fbuloup/Interface_IAI/Documentation/documentation.tex

\documentclass[a4paper,11pt]{beamer}
\usepackage[utf8]{inputenc}
\usepackage{lmodern}
\usepackage{caption}
\usepackage{subcaption}
% Thème Darmstadt
\usetheme{Darmstadt}
\usepackage{graphicx}
\usepackage{caption}
\usepackage{ragged2e}
\usepackage{listings}
\usepackage{color}
\usepackage{gitdags}
\usepackage{fontawesome, wasysym}
\usepackage{booktabs}
\usepackage{pgfplots}
\pgfplotsset{compat=1.18}

%\captionsetup[figure]{labelformat=empty}

\setbeamertemplate{navigation symbols}{} 
\setbeamertemplate{footline} 
{  
	\begin{beamercolorbox}[ht=2.5ex,dp=1.125ex,%
      leftskip=.3cm,rightskip=.3cm plus1fil]{title in head/foot}%
      {\usebeamerfont{title in head/foot}\insertshorttitle} \hfill    
      \insertframenumber / \inserttotalframenumber%
    \end{beamercolorbox}%
%     \begin{beamercolorbox}[colsep=1.5pt]{lower separation line foot}
%     \end{beamercolorbox} 
}

% Informations sur la présentation
\title{Interface IAI - Partie électronique}
\author{frank.buloup@univ-amu.fr} 
\institute{Institut des Sciences du Mouvement}
\date{}

\newcounter{exampleBlockCounter}
\setcounter{exampleBlockCounter}{1} 

\definecolor{comment}{rgb}{0.12, 0.38, 0.18 } %adjusted, in Eclipse: {0.25, 0.42, 0.30 } = #3F6A4D
\definecolor{keyword}{rgb}{0.37, 0.08, 0.25}  % #5F1441
\definecolor{string}{rgb}{0.06, 0.10, 0.98} % 

\lstset{
language=Python,
frame=single,
frameround=tttt,
rulesepcolor=\color{black},
showspaces=false,showtabs=false,tabsize=2,
numberstyle=\tiny,numbers=left,
stringstyle=\color{string},
keywordstyle = \color{keyword}\bfseries,
commentstyle=\color{comment}\itshape,
basicstyle=\ttfamily\footnotesize,
breaklines=true,
captionpos=b
}

%\includeonlyframes{current}

\begin{document}

% Première diapositive : Titre
\begin{frame}[plain]
    \titlepage
    \center{}
 	\vspace{0.5cm}

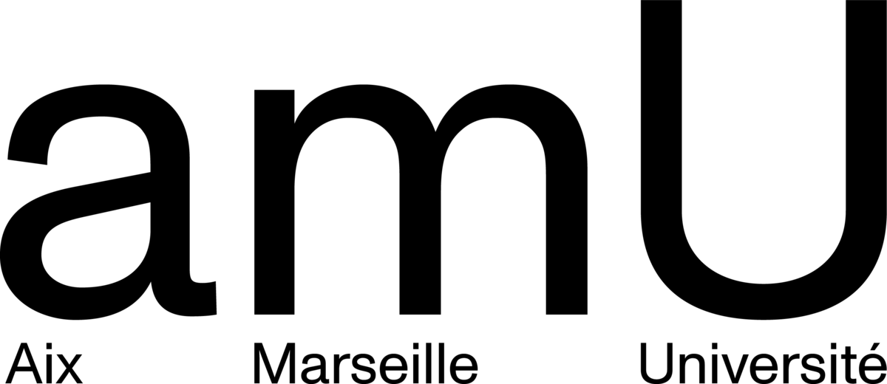
[picture p1: Documentation/images/LogoAMU.png]
	\hspace*{2cm}
	\hspace*{2cm}
	
    
\end{frame}

\begin{frame}{Interface IAI}
	\tableofcontents[hideallsubsections]
\end{frame}

\AtBeginSection{%
    \begin{frame}
        \tableofcontents[sections=\value{section}]
    \end{frame}
}

\section{Documentation}
\begin{frame}
\centering
	\textcolor{blue}{\textbf{\underline{\href{https://raw.githubusercontent.com/fbuloup/Interface_IAI/main/Documentation/RCS4-SLIDER(ME3769-1H).pdf}{Documentation actionneurs}}}}	
	
	\textcolor{blue}{\textbf{\underline{\href{https://raw.githubusercontent.com/fbuloup/Interface_IAI/main/Documentation/SCON-CB_CGB(ME0340-8A).pdf}{Documentation contrôleurs}}}}

	\textcolor{blue}{\textbf{\underline{\href{https://raw.githubusercontent.com/fbuloup/Interface_IAI/main/Documentation/RCM-101-MW_USB(ME0155-31A).pdf}{Documentation PC Software}}}}	
\vspace{1cm}
  
 \textcolor{blue}{\textbf{\underline{\href{https://raw.githubusercontent.com/fbuloup/Interface_IAI/main/Documentation/ProI-HW_eng.pdf}{Documentation ADWinPro I}}}}	
\end{frame}

\section{Principe de la commande}
\subsection{Commande par impulsions}
\begin{frame}
\centering
\textcolor{blue}{\textbf{\underline{\href{https://raw.githubusercontent.com/fbuloup/Interface_IAI/main/Documentation/SCON-CB_CGB(ME0340-8A).pdf\#page=242}{Ref.}}}}
\vspace{0.5cm}

\justifying
Le mode de commande par impulsion est celui que l'on utilisera. L'autre mode, appelé commande par positionnement, présuppose de connaitre les positions à l'avance, ce qui est impossible dans notre cas. Le mode par impulsions est décrit
	\textcolor{blue}{\textbf{\underline{\href{https://raw.githubusercontent.com/fbuloup/Interface_IAI/main/Documentation/SCON-CB_CGB(ME0340-8A).pdf\#page=253}{ici}}}}. Chaque impulsion fait bouger le moteur d'une quantité appelée \textbf{Unit Travel Distance (UTD)}. La fréquence des impulsions règle la vitesse du mouvement. De ce point de vue, on peut dire que la commande est effectuée en vitesse.
Le réglage des différents paramètres pour configurer ce mode peut être trouvé en suivant ce 
\textcolor{blue}{\textbf{\underline{\href{https://raw.githubusercontent.com/fbuloup/Interface_IAI/main/Documentation/SCON-CB_CGB(ME0340-8A).pdf\#page=257}{lien}}}} : réglage du rapport de réduction électronique, du type et de la polarité du train d'impulsions.
\end{frame}

\begin{frame}
\justifying
Pour fonctionner en mode impulsion, l'interrupteur 1 (SW1) en façade du contrôleur doit être positionné sur ON et le paramètre numéro 25 qui défini le type de PIO (PIO pattern) doit être à 1 (codeur de type absolu sans batterie). L'interrupteur 2 (SW2) en façade ne doit jamais être bougé (toujours sur OFF). Il est alors possible de définir une position de référence quelconque différente du "Home". Elle est défini par le paramètre No. 167. Après l'activation du servo, on utilise l'entrée PIO  RSTR et la sortie PIO REND indique son atteinte.\\
\vspace{0.5cm}
\centering
\textbf{\textcolor{red}{Pour économiser des entrées/sorties du DIO32,\\certains signaux du PIO ne sont pas utilisés.\\ * correspond à une logique négative}}\\
\vspace{0.25cm}
\textcolor{blue}{\textbf{\underline{\href{https://raw.githubusercontent.com/fbuloup/Interface_IAI/main/Documentation/SCON-CB_CGB(ME0340-8A).pdf\#page=243}{Ref.}}}}
\end{frame}

\subsection{Signaux PIO accessibles en mode impulsions}
\begin{frame}
\centering
	\begin{block}{Signaux PIO utilisés - Sorties ADWin}
	\begin{itemize}
		\item SON, pour activer le moteur
		\item RES, pour acquitter une alarme sans intervention manuelle
		\item HOME : faire origine depuis ADwin (cod. abs. sans batterie)
		\item CSTP : arrêt forcé, en plus de l'arrêt d'urgence câblé.
		\item RSTR : Reference STaRt
	\end{itemize}
	\end{block}
	\begin{block}{Signaux PIO utilisés - Entrées ADWin}
	\begin{itemize}
		\item SV : servo prêt ? Avant d'envoyer des impulsions
		\item INP : pour savoir si l'actionneur a rejoint la consigne
		\item HEND : pour savoir si l'origine est faite
		\item *ALM : arrêt de l'envoi d'impulsions si défaut.
		\item REND : Reference END 
		\item *EMGS : arrêt d'urgence appuyé
	\end{itemize}
	\end{block}
\end{frame}

\begin{frame}
	\begin{block}{Signaux PIO inutilisés - Sorties ADWin}
	\begin{itemize}
\justifying
		\item RMOD : Il permet de basculer entre AUTO et MANU depuis le PIO, quand le commutateur du contrôleur est en position AUTO.
		\item DCLR : efface le compteur de déviation. Utile lors d'opération de poussées qui décalent les positions de consigne et réelle.
	\end{itemize}
	\end{block}
	\begin{block}{Signaux PIO inutilisés - Entrées ADWin}
	\begin{itemize}
	\justifying
		\item PWR : câblé sur la LED en face avant du contrôleur
		\item RMDS : indique si le contrôleur est en mode AUTO ou MANU (ON en mode manuel). En mode MANU, le SCON ignore les commandes du PIO et les impulsions. C'est le cas, par exemple, si quelqu'un a laissé le commutateur en façade sur MANU après un réglage avec le logiciel IAI. Avec RMDS, l'ADwin pourrait le détecter et arrêter toute commande : ce choix n'a pas été fait.
	\end{itemize}
	\end{block}
\end{frame}
\begin{frame}
\begin{block}{Signaux PIO inutilisés - Entrées ADWin}

\justifying
	\begin{itemize}
	\justifying
		\item ZONE1, ZONE2 : on peut faire la même chose avec l'ADWin puisqu'on a le feedback du SCON.
		\item *OVLW/*ALML : alerte de surcharge / alarme légère. C'est un signal de diagnostic préventif : il prévient avant que le défaut ne devienne une vraie alarme (*ALM). Avec nos vitesses et petites charges, une surcharge est peu probable.
	\end{itemize}
	\end{block}
\end{frame}

\subsection{Résolution et UTD}
\begin{frame}
\begin{alertblock}{Résolution}
\justifying
Les codeurs optique ont 14 bits. On obtient donc $2^{14}$ impulsions par tour moteur. Un tour moteur fait avancer l'actionneur du pas de la vis à bille (BSL en mm/tour). On obtient alors $\frac{BSL}{2^{14}}$ mm par impulsion. C'est le plus petit mouvement réalisable : c'est la résolution.
\begin{align*}
resolution = \frac{BSL}{2^{14}}
\end{align*}
\end{alertblock}

\begin{alertblock}{Distance unitaire parcourue (UTD)}
\justifying
On peut d'autre-part fixer notre propre résolution (celle que l'on souhaite avoir) exprimée également en mm par impulsion : Unit Travel Distance (UTD). Bien sûr UTD ne peut être plus petit que la résolution ! 
\begin{align*}
UTD \geq resolution
\end{align*}
\end{alertblock}
\end{frame}

\begin{frame}
\centering
! Remarque !
\vspace{1cm}

\justifying
Sur cette \textcolor{blue}{\textbf{\underline{\href{https://raw.githubusercontent.com/fbuloup/Interface_IAI/main/Documentation/SCON-CB_CGB(ME0340-8A).pdf\#page=257}{page}}}} il est mentionné le terme de "Actuator Lead Length" dans la formule générale. Nos actionneurs RC4 sont des modèles à moteurs dans l'axe, couplés directement à la vis. Donc "Actuator Lead Length" et "Ball Screw Lead" sont équivalents.
\end{frame}

\subsection{Rapport de réduction}
\begin{frame}
\begin{alertblock}{Rapport de réduction}
\justifying
Le rapport de ces deux quantités donne un nombre sans dimension qui exprime le rapport de réduction entre le nombre d'impulsions réelles et le nombre d'impulsions résultant du choix de notre résolution : 
\begin{align*}
\frac{UTD}{resolution} = \frac{UTD}{\frac{BSL}{2^{14}}} = N
\end{align*}
\end{alertblock}
\begin{alertblock}{CNUM et DNUM}
\justifying
Ce rapport de réduction $N$ est pris en compte dans les contrôleurs sous la forme de deux paramètres : $CNUM$ et $CDEN$ (paramètres 65 et 66) : 
$$
N=\frac{CNUM}{CDEN}=\frac{2^{14}}{BSL}*UTD
$$
\end{alertblock}
\end{frame}

\subsection{Vitesses minimale et maximale absolues}
\begin{frame}
\begin{alertblock}{Vitesse minimale absolue : $V_{min}$}
\justifying
La vitesse minimale absolue (mm/s) est définie de la façon suivante (\textcolor{blue}{\textbf{\underline{\href{https://raw.githubusercontent.com/fbuloup/Interface_IAI/main/Documentation/RCS4-SLIDER(ME3769-1H).pdf\#page=34}{voir ici}}}}, la résolution étant en mm/pulse) :
$$
V_{min} = resolution*1000(pulse/s)
$$
Ce qui signifie que la fréquence de la commande par impulsion ne peut être inférieur à 1000Hz lorsque l'on travaille avec la résolution de l'appareil.
\end{alertblock}

\begin{alertblock}{Vitesse maximale absolue : $V_{max}$}
\justifying
Elle est donnée dans la documentation des actionneurs.
\end{alertblock}
\end{frame}

\subsection{Fréquences minimale et maximale absolues}
\begin{frame}
\begin{alertblock}{Fréquences min et max absolues}
\justifying
Avec ces vitesses absolues (mm/s), on peut connaitre l'intervalle de variation absolue de la fréquence de commande par impulsions :
\begin{align*}
F_{min} &= \frac{V_{min}}{UTD} \\
F_{max} &= \frac{V_{max}}{UTD}
\end{align*}
\end{alertblock}
\end{frame}

\subsection{Vitesse obtenue et fréquence de commande}
\begin{frame}
\begin{alertblock}{Vitesse obtenue $v$}
\justifying
La vitesse (mm/s) obtenue dépend alors de notre UTD (mm/pulse) et de la fréquence des impulsions de commande (Hz) :
$$
v = UTD*f
$$
Avec : 
$$
V_{min} \leq v_{min} \leq v \leq v_{max} \leq V_{max}
$$
$v_{min}$  et $v_{max}$ étant les vitesses min et max que l'on se fixe.
\end{alertblock}
\begin{alertblock}{Fréquence de commande $f$}
\justifying
Elle doit vérifier :
$$
F_{min} \leq f_{min} \leq f \leq f_{max} \leq F_{max}
$$

$f_{min}$  et $f_{max}$ étant les fréquences min et max que l'on se fixe.
\end{alertblock}
\end{frame}

\subsection{Mouvement fluide}
\begin{frame}
\justifying
\textbf{\textcolor{red}{Pour que le mouvement soit fluide, il faut que l'UTD soit suffisamment petit mais également que la fréquence de commande soit suffisamment grande afin que la mise à jour de la position soit assez fréquente. C'est un compromis à trouver.}}
\end{frame}

\subsection{Feedback}
\begin{frame}

\justifying	
Le réglage des différents paramètres pour configurer le feedback peut être trouvé en suivant ce 
\textcolor{blue}{\textbf{\underline{\href{https://raw.githubusercontent.com/fbuloup/Interface_IAI/main/Documentation/SCON-CB_CGB(ME0340-8A).pdf\#page=260}{lien}}}} : réglage du rapport de réduction électronique, du type et de la polarité du train d'impulsions. Il semble qu'une partie de ce réglage ne soit pas obligatoire : si le paramètre No 114 est laissé à zéro (paramètres de feedback non applicable, non utilisé), ce sont les paramètres No 65 et 66 qui s'appliquent (ceux de la commande par impulsions). Au contraire, si le paramètre No 114 est passé à un, il faut alors régler les paramètres No 115 et 116 pour définir un rapport de réduction différent de la commande.

\end{frame}

\section{Caractéristiques des deux axes}
\subsection{Axe 0 - Celui du dessous}
\begin{frame}

	\begin{block}{Actionneur : RCS4-SA8C-WA-400-30-200-T2-S (\textcolor{white}{\textbf{\underline{\href{https://raw.githubusercontent.com/fbuloup/Interface_IAI/main/Documentation/RCS4-SLIDER(ME3769-1H).pdf\#page=37}{Ref.}}}})}
		\begin{itemize}
			\item Masse : 5.6kg - Codeur absolu sans batterie - 400 watts
			\item Pas de la vis à bille (Ball Screw Lead) : 30mm par tour moteur
			\item Course totale (Stroke Length) : 200mm
			\item Vitesse maximale absolue ($V_{max}$) : 1800mm/s
			\item Force nominale en continu : 226N
			\item Codeur : 16384 impulsions par tour moteur
			\item Charge utile horizontale : 30kg - Charge utile verticale : 12kg
		\end{itemize}
	\end{block}
$$resolution=\frac{BSL(mm)}{16384(pulses)}=\frac{30}{16384}=1.83\mu m$$	
$$V_{min}=\frac{BSL(mm)}{16384(pulses)}*1000(pulse/s)=\frac{30000}{16384}=1.83mm/s$$
\end{frame}

\begin{frame}
\centering
	\begin{block}{Contrôleur : SCON-CB-400WAI-PN-2-2}
		\begin{itemize}
			\item Type standard, 400 watts
			\item Codeur absolu/incrémental sans batterie
			\item Type PNP : type source de courant
			\item PIO de type PNP
			\item Commande par positionnement ou impulsions différentielles
			\item Les entrées PIO doivent être positionnées au moins 6ms pour prise en compte (commandes reçues de l'ADwin)
			\item CSTP doit être positionnée au moins 16 
ms		\end{itemize}
	\end{block}
\end{frame}

\begin{frame}
\begin{alertblock}{Grandeurs absolues}
$V_{max} = 1800mm/s$ et $V_{min} = 1.83mm/s$
\end{alertblock}

\begin{exampleblock}{Exemple de calcul I}
Si on se fixe $UTD = resolution$, $v_{max} = 1500mm/s$ et $v_{min} = 2mm/s$. Alors
$F_{max} = 983.606kHz$ et $F_{min} = 1000Hz$,
$f_{max} = 819.672kHz$ et $f_{min} = 1093Hz$
\end{exampleblock}

\begin{exampleblock}{Exemple de calcul II}
Si on se fixe $UTD = 0.5mm$, $v_{max} = 120mm/s$ et $v_{min} = 5mm/s$. Alors $F_{max} = 3600Hz$ et $F_{min} = 3.66Hz$, $f_{max} = 240Hz$ et $f_{min} = 10Hz$
\end{exampleblock}
\end{frame}

\subsection{Axe 0 - Celui du dessous - Mouvement fluide}
\begin{frame}
\justifying
\textbf{\textcolor{red}{
En mode train d'impulsions, chaque impulsion déplace la consigne de position du SCON d'un bloc de $0.5 mm$. À $5 mm/s$, soit $10 Hz$, l'actionneur reçoit une nouvelle consigne toutes les $100 ms$ : il parcourt rapidement $0.5 mm$, s'arrête, attend l'impulsion suivante, et ainsi de suite. Le mouvement sera donc saccadé, alors même que $5 mm/s$ est au-dessus de la vitesse minimale de $1,83mm/s$.}}
\vspace{0.5cm}

\textbf{\textcolor{red}{
Il est alors préférable de raisonner à partir d'une fréquence min assez grande. Prenons $f_{min} = 500Hz$. On obtient avec $v_{min}=5mm/s$, $UTD=10\mu m$ et avec $v_{max}=120mm/s$, $f_{max}=12kHz$. $12kHz$ devrait être réalisable avec un ADwin. Si on rencontre des difficultés, il sera préférable de diminuer $v_{max}$ plutôt que d'augmenter $UTD$.}}
\end{frame}

\subsection{Axe 0 - Celui du dessous - Calcul de N, CNUM et CDEN}
\begin{frame}
\justifying
Avec l'exemple II on obtiendrait :
\begin{align*}
N = \frac{CNUM}{CDEN} &= \frac{2^{14}}{BSL}*UTD = \frac{16384}{3000} = \frac{2048}{375} \\
CNUM &= 2048 \quad CDEN = 375
\end{align*}
\begin{alertblock}{Vérification à faire ! (\textcolor{white}{\textbf{\underline{\href{https://raw.githubusercontent.com/fbuloup/Interface_IAI/main/Documentation/SCON-CB_CGB(ME0340-8A).pdf\#page=258}{Ref.}}}})}
$$
2^{27} \geq \frac{SL}{BSL} * 2^{14} * \frac{CDEN}{CNUM}\quad (1)?
$$
$$
2^{31} \geq \frac{SL}{BSL} * 2^{14} * CNUM\quad (2)?
$$
$$
2^{31} \geq \frac{SL}{BSL} * 2^{14} * CDEN\quad (3)?
$$
Les vérifications (2) et (3) ne sont pas à faire car la version du contrôleur est V0019.
\end{alertblock}

\end{frame}

\begin{frame}
\justifying
Pour vérifier la version du firmware, avec RC PC Software, une fois connecté au contrôleur, chercher la commande d'informations de version du contrôleur, dans le menu Help $\leftrightarrow$ Version Information. Elle affiche les versions des différents logiciels internes (CPU principal, etc.). C'est la version du contrôleur qui compte ici. Le manuel ME0155 du logiciel indique l'emplacement exact de cette commande.

\centering \textcolor{blue}{\textbf{\underline{\href{https://raw.githubusercontent.com/fbuloup/Interface_IAI/main/Documentation/RCM-101-MW_USB(ME0155-31A).pdf\#page=203}{Documentation PC Software}}}}	
\vspace{0.25cm}

\centering 
Dans cette fenêtre, il existe deux numéros de version :
\begin{itemize}
	\item Controller Version : AA090019h $\rightarrow$ V0019
	\item Controller Core Version : AA840003h $\rightarrow$ V0003
\end{itemize}
\textcolor{red}{\textbf{V0019}}

\justifying	
Le réglage des différents paramètres pour configurer la commande peut être trouvé en suivant ce 
\textcolor{blue}{\textbf{\underline{\href{https://raw.githubusercontent.com/fbuloup/Interface_IAI/main/Documentation/SCON-CB_CGB(ME0340-8A).pdf\#page=257}{lien}}}} : réglage du rapport de réduction électronique, du type et de la polarité du train d'impulsions.
\end{frame}

\subsection{Axe 1 - Celui du dessus}
\begin{frame}
	\begin{block}{Actionneur : RCS4-SA7C-WA-200-24-200-T2-R03 (\textcolor{white}{\textbf{\underline{\href{https://raw.githubusercontent.com/fbuloup/Interface_IAI/main/Documentation/RCS4-SLIDER(ME3769-1H).pdf\#page=34}{Ref.}}}})}
		\begin{itemize}
			\item Masse : 4.3kg - Codeur absolu sans batterie - 200 watts
			\item Pas de la vis à bille (Ball Screw Lead) : 24mm par tour moteur
			\item Course totale (Stroke Length) : 200mm
			\item Vitesse maximale absolue ($V_{max}$) : 1500mm/s
			\item Force nominale en continu : 142N
			\item Codeur : 16384 impulsions par tour moteur
			\item Charge utile horizontale : 30kg - Charge utile verticale : 7kg
		\end{itemize}
	\end{block}
$$resolution=\frac{BSL(mm)}{16384(pulses)}=\frac{24}{16384}=1.46\mu m$$	
$$V_{min}=\frac{BSL(mm)}{16384(pulses)}*1000(pulse/s)=\frac{24000}{16384}=1.46mm/s$$
\end{frame}
\begin{frame}
	\begin{block}{Contrôleur : SCON-CB-200WAI-PN-2-2}
		\begin{itemize}
			\item Type standard, 200 watts
			\item Codeur absolu/incrémental sans batterie
			\item Type PNP : type source de courant
			\item PIO de type PNP
			\item Commande par positionnement
			\item Commande par impulsions différentielles
		\end{itemize}
	\end{block}
\end{frame}

\begin{frame}
\begin{alertblock}{Grandeurs absolues}
$V_{max} = 1500mm/s$ et $V_{min} = 1.46mm/s$
\end{alertblock}

\begin{exampleblock}{Exemple de calcul I}
Si on se fixe $UTD = resolution$, $v_{max} = 1300mm/s$ et $v_{min} = 2mm/s$. Alors
$F_{max} = 1027.397kHz$ et $F_{min} = 1000Hz$,
$f_{max} = 890.41kHz$ et $f_{min} = 1.369kHz$
\end{exampleblock}

\begin{exampleblock}{Exemple de calcul II}
Si on se fixe $UTD = 0.5mm$, $v_{max} = 120mm/s$ et $v_{min} = 5mm/s$. Alors $F_{max} = 3000Hz$ et $F_{min} = 2.92Hz$, $f_{max} = 240Hz$ et $f_{min} = 10Hz$
\end{exampleblock}
\end{frame}

\subsection{Axe 1 - Celui du dessus - Mouvement fluide}
\begin{frame}
\justifying
\textbf{\textcolor{red}{
En mode train d'impulsions, chaque impulsion déplace la consigne de position du SCON d'un bloc de $0.5 mm$. À $5 mm/s$, soit $10 Hz$, l'actionneur reçoit une nouvelle consigne toutes les $100 ms$ : il parcourt rapidement $0.5 mm$, s'arrête, attend l'impulsion suivante, et ainsi de suite. Le mouvement sera donc saccadé, alors même que $5 mm/s$ est au-dessus de la vitesse minimale de $1,46mm/s$.}}
\vspace{0.5cm}

\textbf{\textcolor{red}{
Il est alors préférable de raisonner à partir d'une fréquence min assez grande. Prenons $f_{min} = 500Hz$. On obtient avec $v_{min}=5mm/s$, $UTD=10\mu m$ et avec $v_{max}=120mm/s$, $f_{max}=12kHz$. $12kHz$ devrait être réalisable avec un ADwin. Si on rencontre des difficultés, il sera préférable de diminuer $v_{max}$ plutôt que d'augmenter $UTD$.}}
\end{frame}

\subsection{Axe 1 - Celui du dessus - Calcul de N, CNUM et CDEN}
\begin{frame}
\justifying
Avec l'exemple II on obtiendrait :
\begin{align*}
N = \frac{CNUM}{CDEN} &= \frac{2^{14}}{BSL}*UTD = \frac{16384}{2400} = \frac{512}{75} \\
CNUM &= 512 \quad CDEN = 75
\end{align*}
\begin{alertblock}{Vérification à faire ! (\textcolor{white}{\textbf{\underline{\href{https://raw.githubusercontent.com/fbuloup/Interface_IAI/main/Documentation/SCON-CB_CGB(ME0340-8A).pdf\#page=258}{Ref.}}}})}
$$
2^{27} \geq \frac{SL}{BSL} * 2^{14} * \frac{CDEN}{CNUM}\quad (1)?
$$
$$
2^{31} \geq \frac{SL}{BSL} * 2^{14} * CNUM\quad (2)?
$$
$$
2^{31} \geq \frac{SL}{BSL} * 2^{14} * CDEN\quad (3)?
$$
Les vérifications (2) et (3) ne sont pas à faire car la version du contrôleur est V0019.
\end{alertblock}
\end{frame}

\begin{frame}
\justifying
Pour vérifier la version du firmware, avec RC PC Software, une fois connecté au contrôleur, chercher la commande d'informations de version du contrôleur, dans le menu Help $\rightarrow$ Version Information. Elle affiche les versions des différents logiciels internes (CPU principal, etc.). C'est la version du contrôleur qui compte ici. Le manuel ME0155 du logiciel indique l'emplacement exact de cette commande.

\centering \textcolor{blue}{\textbf{\underline{\href{https://raw.githubusercontent.com/fbuloup/Interface_IAI/main/Documentation/RCM-101-MW_USB(ME0155-31A).pdf\#page=203}{Documentation PC Software}}}}	
\vspace{0.25cm}

\centering 
Dans cette fenêtre, il existe deux numéros de version :
\begin{itemize}
	\item Controller Version : AA090019h $\rightarrow$ V0019
	\item Controller Core Version : AA840003h $\rightarrow$ V0003
\end{itemize}
\textcolor{red}{\textbf{V0019}}	

\justifying	
Le réglage des différents paramètres pour configurer la commande peut être trouvé en suivant ce 
\textcolor{blue}{\textbf{\underline{\href{https://raw.githubusercontent.com/fbuloup/Interface_IAI/main/Documentation/SCON-CB_CGB(ME0340-8A).pdf\#page=257}{lien}}}} : réglage du rapport de réduction électronique, du type et de la polarité du train d'impulsions.
\end{frame}

\section{Interface avec un ADWinPro}
\subsection{Généralités}
\begin{frame}
	\begin{block}{Pulse, feedback et PIO}
	\justifying
		\begin{itemize}
			\item Une carte pour adapter les signaux SCON $\leftrightarrow$ ADWin
			\item Commande par impulsion et non par positionnement
			\item La commande sera faite avec des sorties DIO32 de l'ADwin
			\item Les états des signaux PIO seront lus/positionnés avec des entrées/sorties DIO32 de l'ADwin
			\item La lecture du feedback sera faite avec une carte CO4-T de l'ADwin
			\item Une carte par paire contrôleur/actionneur (par axe)
		\end{itemize}
	\end{block}
\end{frame}

\subsection{Schémas et principe de l'interface}
\begin{frame}
\begin{block}{Alimentation}
\begin{itemize}
	\item Alimentation 24V externe
	\item Diode Schottky de protection contre l'inversion de polarité
	\item Régulateur 5V à découpage
	\item Diodes témoins 5V et 24V
	\item Fusible réarmable
\end{itemize}
\end{block}
	\centering
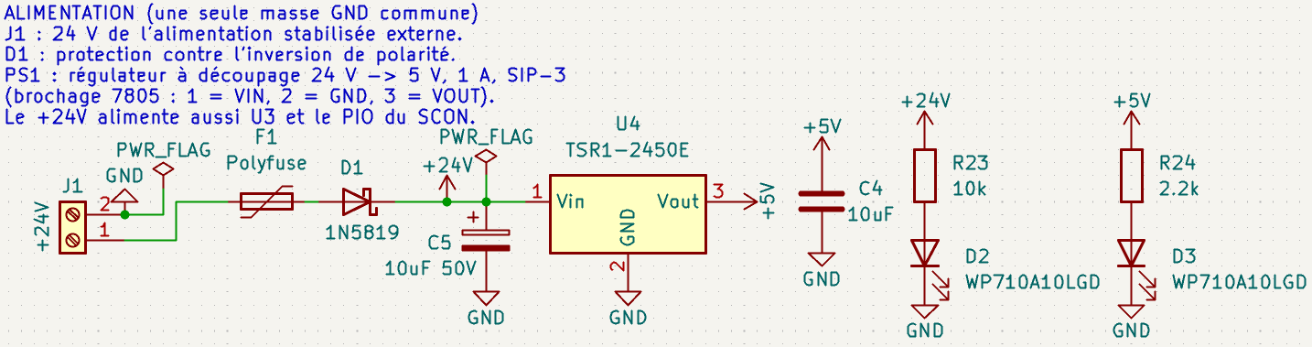
[picture p2: Documentation/images/Alimentation.PNG]
	
\end{frame}
\begin{frame}
\begin{block}{Pulse}
\begin{itemize}

	\justifying
		\item Signaux TTL PP et NP convertis en signaux différentiels \textcolor{blue}{\textbf{\underline{\href{https://raw.githubusercontent.com/fbuloup/Interface_IAI/main/Documentation/SCON-CB_CGB(ME0340-8A).pdf\#page=50}{4V}}}}
	\item Résistances de limitation de courant et de pull down
	\item Principe de la commande
\textcolor{blue}{\textbf{\underline{\href{https://raw.githubusercontent.com/fbuloup/Interface_IAI/main/Documentation/SCON-CB_CGB(ME0340-8A).pdf\#page=253}{ici}}}}		

\end{itemize}
\end{block}
	\centering
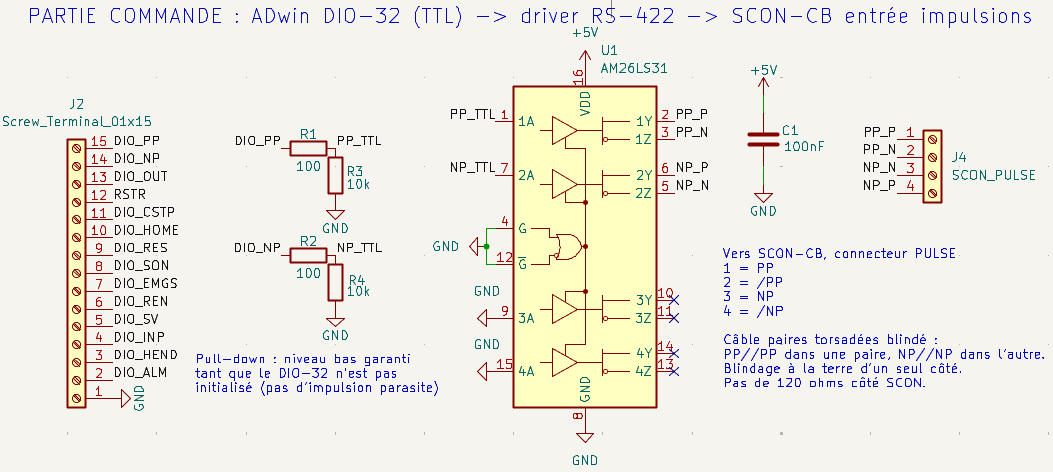
[picture p3: Documentation/images/Pulse.PNG]
	
	
\end{frame}
\begin{frame}
\begin{block}{Feedback}
\begin{itemize}
\item Signaux de retour de position du moteur
\item Résistances de limitation vers entrées ADWin
\item Résistances de terminaison côté sortie SCON
\item Principe de la commande
\textcolor{blue}{\textbf{\underline{\href{https://raw.githubusercontent.com/fbuloup/Interface_IAI/main/Documentation/SCON-CB_CGB(ME0340-8A).pdf\#page=260}{ici}}}}
\end{itemize}
\end{block}
	\centering
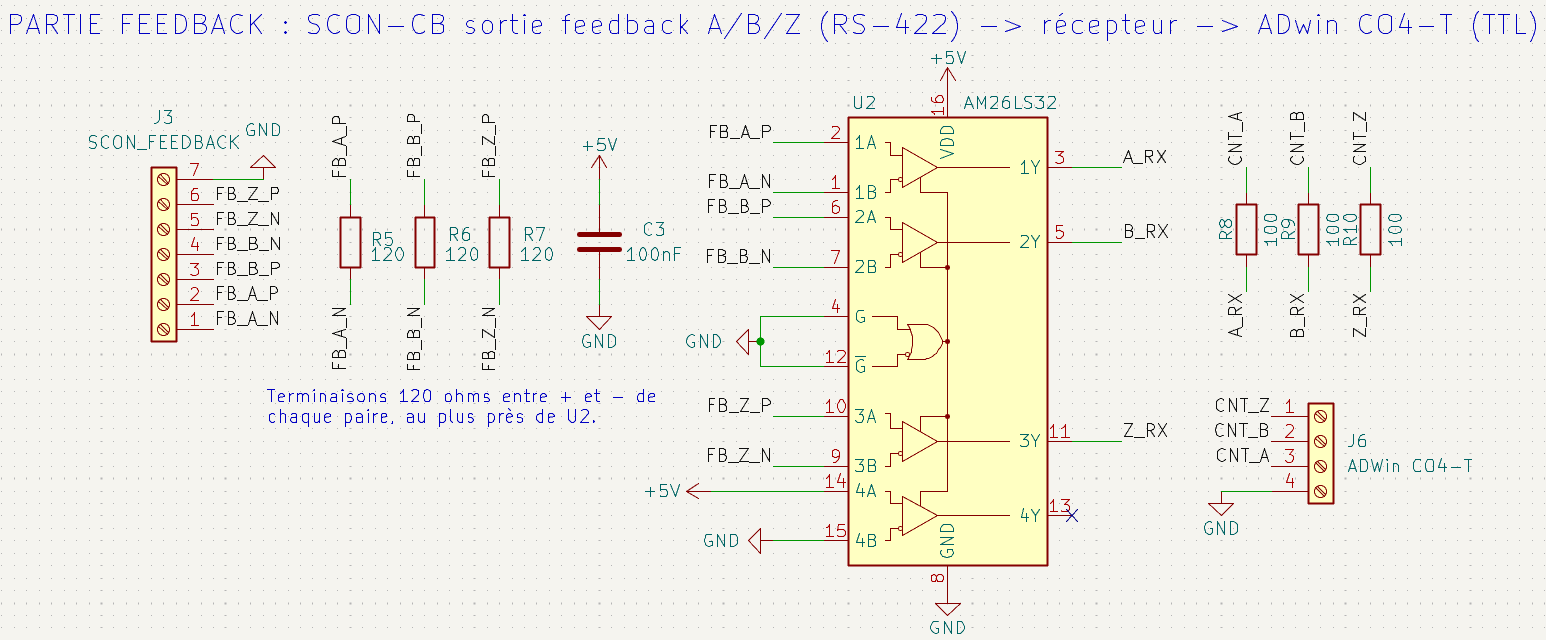
[picture p4: Documentation/images/feedback.PNG]
	
\end{frame}
\begin{frame}
\begin{block}{PIO}
\begin{itemize}
\item Adaptation niveaux TTL vers niveaux 24V
\item Adaptation niveaux 24V vers niveaux TTL par pont diviseur
\item Résistance de pull down pour stabilité
\item Un seul signal de réserve : une sortie ADWin vers SCON
\end{itemize}
\end{block}
	\centering
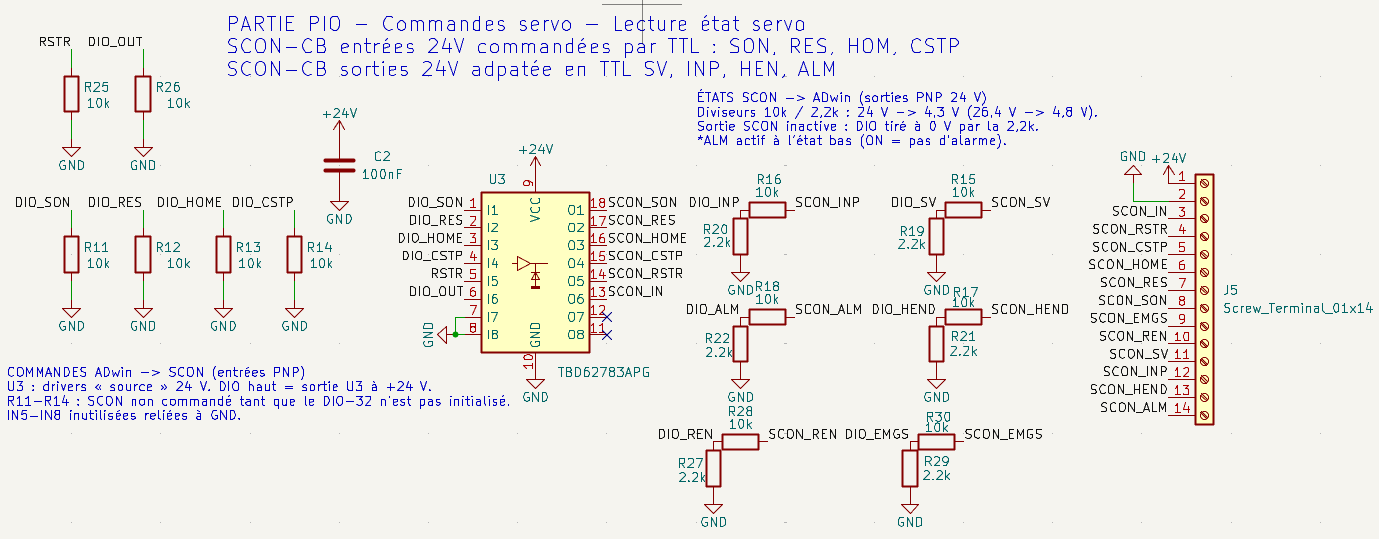
[picture p5: Documentation/images/PIO.PNG]
	
\end{frame}

\subsection{Aperçus du routage PCB}
\begin{frame}
	\centering
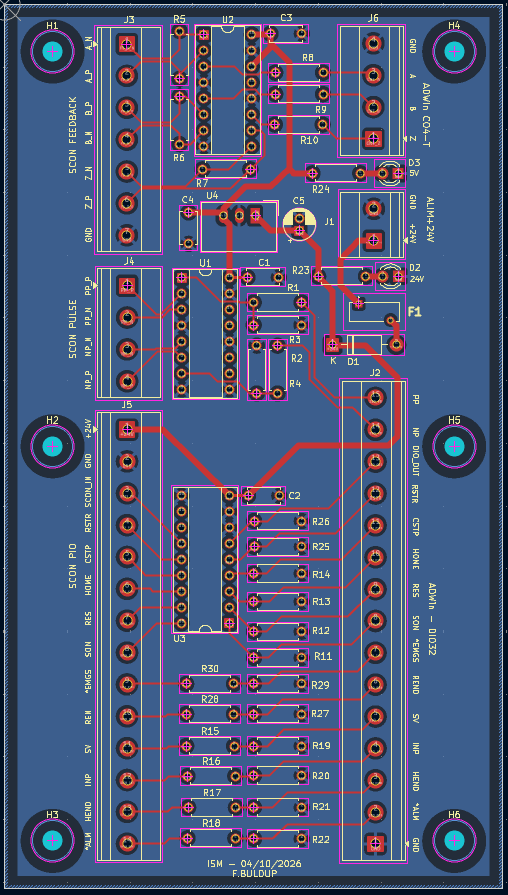
[picture p6: Documentation/images/pcb.PNG]
	
\end{frame}

\begin{frame}
	\centering
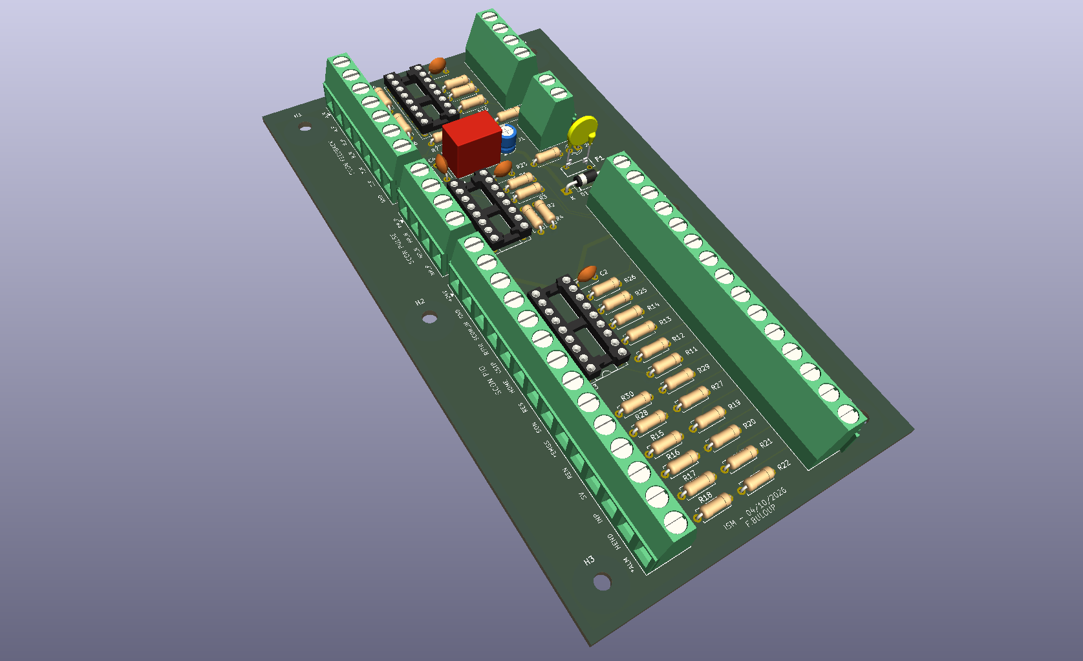
[picture p7: Documentation/images/Interface_IAI_1.png]
	
\end{frame}

\begin{frame}
	\centering
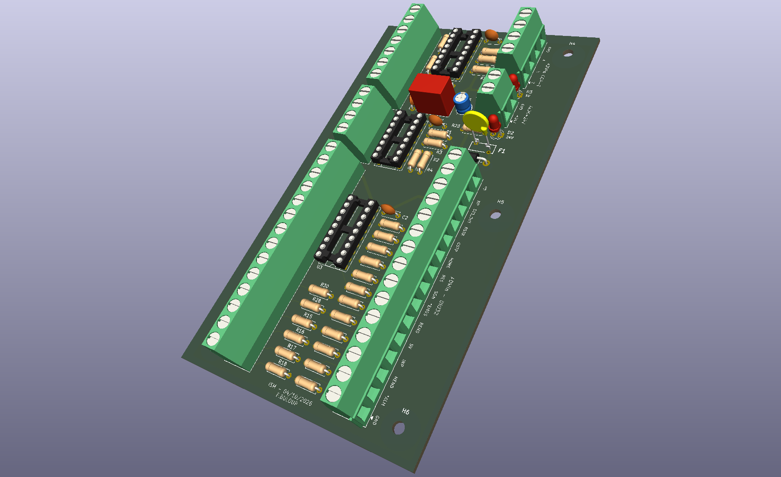
[picture p8: Documentation/images/Interface_IAI_2.png]
	
\end{frame}

\subsection{Coffret mural}
\begin{frame}
	\centering
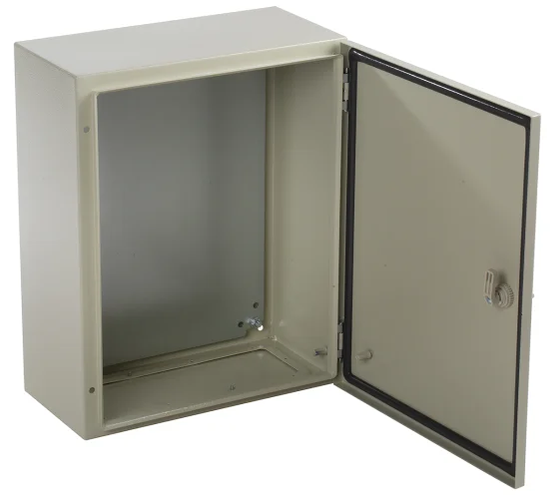
[picture p9: Documentation/images/CoffretMural.png]
	
	
	Avec plaque de châssis (terre) et de presse-étoupes
\end{frame}

\begin{frame}
\begin{block}{Les différents éléments}
	\begin{itemize}
		\item 1 différentiel de protection globale
		\item 2 disjoncteurs de protection des contrôleurs
		\item 1 alimentation 24V
		\item 1 disjoncteur de protection alimentation 24V
		\item 2 filtres EMI et 8 noyaux de ferrites pour limiter le bruit
		\item 2 rail DIN pour recevoir les modules
		\item 7 presse-étoupes Ø 4 à 9 mm pour sortir du coffret
		\item 1 presse-étoupe : arrêt d'urgence
		\item 2 presse-étoupes : câbles vers ADWin (DIO32 et CO4-T)
		\item 4 presse-étoupes : câbles SCON $\leftrightarrow$ RCS4
		\item Câblage en goulotte
		\item Connecteur CEI en panneau 
	\end{itemize}
\end{block}
\end{frame}

\subsection{Implantation schématique dans le coffret}
\begin{frame}
	\centering
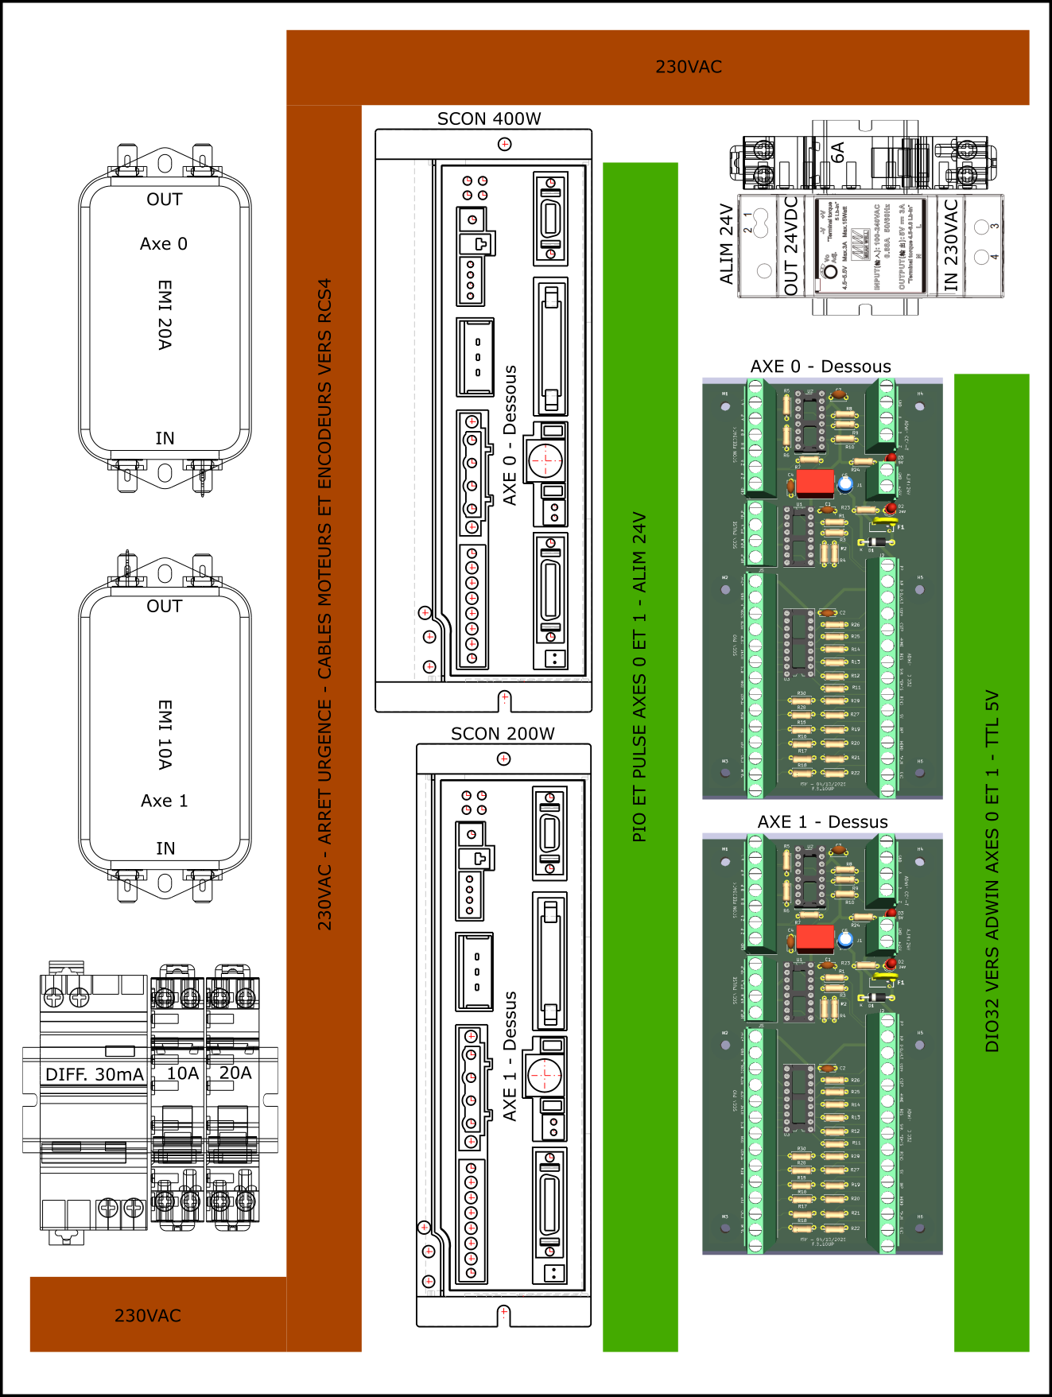
[picture p10: Documentation/images/ImplantationCoffret.png]
	
\end{frame}

\begin{frame}
	\centering
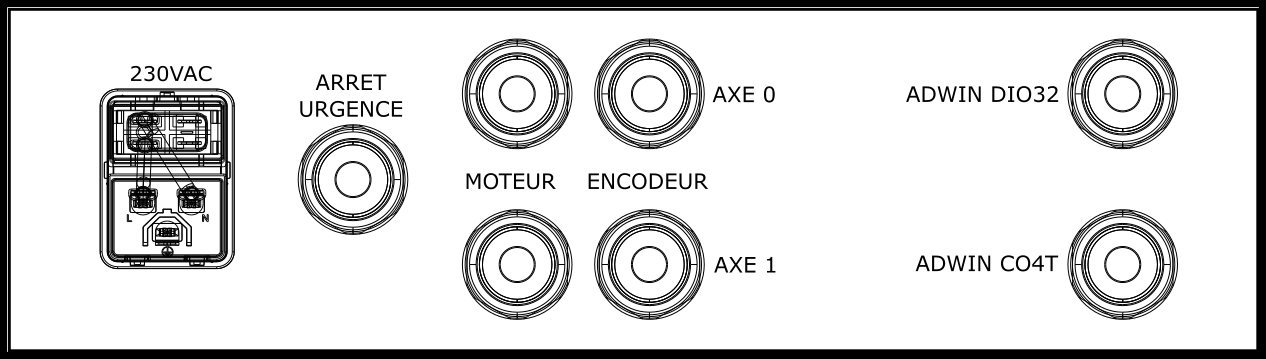
[picture p11: Documentation/images/ImplantationEtoupes.png]
	
\centering
Plaque presse-étoupes
\end{frame}

\subsection{Câblage (pour mémo !)}
\begin{frame}
\begin{itemize}
\justifying
  \item \textbf{Liaisons SCON $\leftrightarrow$ Carte PCB} : utiliser les deux câbles fournis (PULSE + FEEDBACK et PIO) pour chaque axe. Garder des longueurs d'environ 10 à 15cm. Visser dans les borniers côté carte PCB.
  \item \textbf{Liaisons Carte PCB $\leftrightarrow$ ADWin} : utiliser des câbles blindés avec des connecteurs DA-37 mâles pour les DIO et les CO4-T. Visser dans les borniers côté carte PCB. Ces câbles qui partent vers l'ADWin auront leurs tresses reliées à la terre du coffret. Ces tresses ne devront pas être reliées côté ADWin (règle du blindage d'un seul côté, éviter les boucles de masse). L'inverse est possible.
  \item Utiliser les goulottes pour passer les câbles dans le coffret et des presse-étoupes pour passer en dehors si possible !
  \item \textbf{Immunité au bruit} : ne pas relier la masse électronique des PCB (GND) à la terre du coffret et croiser les câbles signaux et de puissance à la perpendiculaire
\end{itemize}
\end{frame}

\begin{frame}
\begin{table}[htbp]
  \centering
  \caption{Brochage côté ADWin DIO-32 (DA-37 femelle)}
  \label{tab:brochage-x1}
  \tiny
  \setlength{\tabcolsep}{2pt}
  \begin{tabular}[t]{cl}
    \toprule
    \textbf{Broche} & \textbf{Signal} \\
    \midrule
    19 & PP0 (out) \\
    37 & NP0 (out)\\
    18 & SON0 (out)\\
    36 & RES0 (out)\\
    17 & HOME0 (out)\\
    35 & CSTP0 (out)\\
    16 & DIO\_RSTR0 (out)\\
    34 & DIO\_OUT0 (out)\\
    15 & SV0 (in)\\
    33 & INP0 (in)\\
    14 & HEND0 (in)\\
    32 & ALM0 (in)\\
    13 & DIO\_REND0 (in)\\
    31 & DIO\_EMGS0 (in)\\
    \bottomrule
  \end{tabular}
  \hspace{1mm}
  \begin{tabular}[t]{cl}
    \toprule
    \textbf{Broche} & \textbf{Signal} \\
    \midrule
    12 & SV1 (in) \\
    30 & INP1 (in)\\
    11 & HEND1 (in)\\
    29 & ALM1 (in)\\
    10 & DIO\_REND1 (in)\\
    28 & DIO\_EMGS1 (in)\\
    ...			&...\\

    7 & PP1 (out) \\
    25 & NP1 (out)\\
    6 & SON1 (out)\\
    24 & RES1 (out)\\
    5  & HOME1 (out)\\
    23 & CSTP1 (out)\\ 
    4 & DIO\_RSTR1 (out)\\
    \bottomrule
  \end{tabular}
  \hspace{1mm}
  \begin{tabular}[t]{cl}
  \toprule
    \textbf{Broche} & \textbf{Signal} \\
    \midrule
  22 & DIO\_OUT1 (out)\\
    ...			&...\\
    3  & GND \\
    \bottomrule
  \end{tabular}
\end{table}
\begin{itemize}
\tiny
\item DIO\_OUT0 : sortie de réserve pour l'axe 0 (entrée SCON)
\item DIO\_OUT1 : sortie de réserve pour l'axe 1 (entrée SCON)
\end{itemize}
\vspace{0.5cm}
\centering
\textcolor{blue}{\textbf{\underline{\href{https://raw.githubusercontent.com/fbuloup/Interface_IAI/main/Documentation/ProI-HW_eng.pdf\#page=89}{Voir ici pour le brochage}}}}	

\end{frame}

\begin{frame}
\begin{table}[htbp]
  \centering
  \caption{Brochage côté ADWin CO4-T (DA-37 femelle)}
  \label{tab:brochage-x2}
  \footnotesize
  \begin{tabular}{cl}
    \toprule
    \textbf{Broche} & \textbf{Signal} \\
    \midrule
    19          & Z0 \\
    37          & N.C. \\
    18          & N.C. \\
    36          & A0 \\
    17          & B0 \\
    ...			&...\\
    15          & Z1 \\
    33          & N.C. \\
    14          & N.C. \\
    32          & A1 \\
    13          & B1 \\
    ...			&...\\
    3   & GND \\
    \bottomrule
  \end{tabular}
\end{table}
\centering
\textcolor{blue}{\textbf{\underline{\href{https://raw.githubusercontent.com/fbuloup/Interface_IAI/main/Documentation/ProI-HW_eng.pdf\#page=121}{Voir ici pour le brochage}}}}
\end{frame}

\subsection{Ordre de prix et devis}
\begin{frame}
\begin{table}[htbp]
  \centering
  \caption{Ordres de prix pour les deux axes}
  \label{tab:brochage-x2}
  \footnotesize
  \begin{tabular}{cl}
    \toprule
    \textbf{Poste} & \textbf{Prix approximatif HT} \\
    \midrule
    Carte chez eurocircuits          & 180 \\
    Composants pour circuit imprimé  & 95 \\
    Coffret mural          & 1310 \\
    \midrule
    Total HT          & 1580 \\
    \bottomrule
  \end{tabular}
\end{table}
\vspace{1cm}

\centering \textcolor{blue}{\textbf{\underline{\href{https://raw.githubusercontent.com/fbuloup/Interface_IAI/main/Documentation/DevisEurocircuits.pdf}{Devis Eurocircuits}}}}	

\textcolor{blue}{\textbf{\underline{\href{https://raw.githubusercontent.com/fbuloup/Interface_IAI/main/Interface_IAI.xlsx}{Fichier Excel prix}}}}	
\end{frame}

% Paramètres de la fonction
\pgfmathsetmacro{\fmin}{4000}
\pgfmathsetmacro{\fmax}{10000}
\pgfmathsetmacro{\deltaMax}{5}
\pgfmathsetmacro{\eps}{0.25}
\pgfmathsetmacro{\pente}{(\fmax-\fmin)/\deltaMax} % pente = 1200
\pgfmathsetmacro{\feps}{\pente*\eps+\fmin}         % valeur de F juste après epsilon = 4300

\section{Simulation}
\subsection{Loi de commande}

\begin{frame}

	\centering
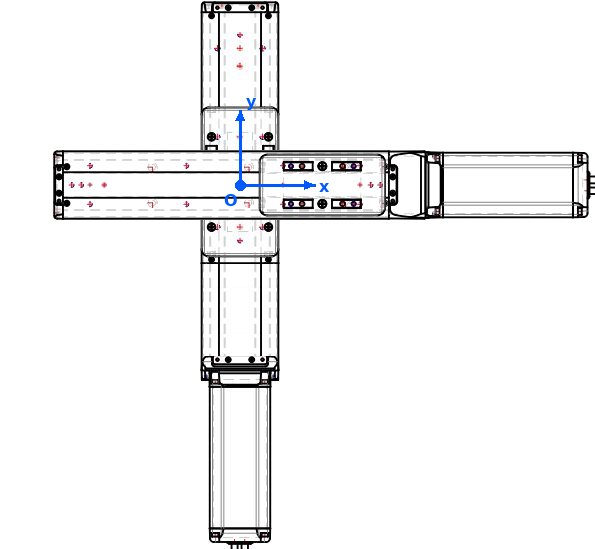
[picture p12: Documentation/images/IAI_Models/SA7C_sur_SA8C_repere.png]
	
\end{frame}

\begin{frame}
\justifying
Le repère (O,x,y) de l'OptiTrack devrait correspondre aux axes moteurs. Les positions des moteurs sont récupérées par le feedback. On calcule à tout instant les différences entre les positions moteurs et les positions du marqueur en x et y :
\begin{equation*}
\left\{
\begin{aligned}
\delta_x &= marker_x - motor_x\\
\delta_y &= marker_y - motor_y
\end{aligned}\right.
\end{equation*}

Puis, à partir de ces différences, on peut calculer la fréquence à envoyer à chacun des axes selon la fonction présentée dans le graphe ci-après. On pourrait tout à fait envisager d'autres lois. 

\end{frame}

\begin{frame}
\begin{tikzpicture}
\begin{axis}[
    width=11cm,
    height=7cm,
    xlabel={$\lvert\delta\rvert - mm$},
    ylabel={$F(\lvert\delta\rvert) - Hz$},
    xmin=0, xmax=10,
    ymin=0, ymax=12000,
    axis lines=left,
    grid=both,
    grid style={line width=.1pt, draw=gray!30},
    major grid style={line width=.2pt, draw=gray!50},
    xtick={0,0.25,1,2,3,4,5,6,7,8,9,10},
    ytick={0,2000,4000,6000,8000,10000,12000},
	%xticklabels={$0$,$\delta_{\max}$},
   	xticklabels={,$\varepsilon$,,,,,$\delta_{\max}$,,,,,},
    yticklabels={},
    legend pos=south east,
    legend style={font=\scriptsize},
    every axis plot/.append style={thick},
    scaled y ticks=false,
]
 
% Zone 1 : 0 <= delta < epsilon  ->  F = 0
\addplot[green!50!black, domain=0:\eps, samples=2] {0};
\addlegendentry{$0 \leq \lvert\delta\rvert < \varepsilon$ : $F=0$}
 
% Zone 2 : epsilon <= delta < deltaMax  ->  F = (fmax-fmin)/deltaMax * delta + fmin
\addplot[blue, domain=\eps:\deltaMax, samples=2] {\pente * x + \fmin};
\addlegendentry{$\varepsilon \leq \lvert\delta\rvert \leq \delta_{\max}$ : $F=\frac{f_{\max}-f_{\min}}{\delta_{\max}}\,\lvert\delta\rvert+f_{\min}$}
 
% Zone 3 : delta >= deltaMax  ->  F = fmax
\addplot[red, domain=\deltaMax:10, samples=2] {\fmax};
\addlegendentry{$\delta > \delta_{\max}$ : $F=f_{\max}$}
 
% Saut en delta = epsilon (trait pointillé)
\draw[dashed, gray] (axis cs:\eps,0) -- (axis cs:\eps,\feps);
 
% Points : plein = valeur prise, creux = valeur non atteinte
%\addplot[only marks, mark=*, mark size=2pt, black]
%    coordinates {(0,0) (\eps,\feps) (\deltaMax,\fmax)};
%\addplot[only marks, mark=*, mark size=2pt, fill=white, draw=black]
%    coordinates {(\eps,0)};
 
% Pointillés vers les axes
\draw[dashed, gray] (axis cs:0,\fmax) -- (axis cs:\deltaMax,\fmax)
                                    -- (axis cs:\deltaMax,0);
 
% Annotations
\node[anchor=south west, font=\small] at (axis cs:0.4,\feps-1100) {$F(\varepsilon)=f_{\min}$};
\node[anchor=south west, font=\small] at (axis cs:0.1,\fmax) {$F(\delta_{\max})=f_{\max}$};
\node[anchor=north west, font=\small] at (axis cs:\eps,-300) {};
 
\end{axis}
\end{tikzpicture}
\centering
On peut prendre $\epsilon = \frac{UTD}{2}$.
\end{frame}

\begin{frame}
\centering
Une simulation peut être faite en utilisant ce \textcolor{blue}{\textbf{\underline{\href{https://raw.githubusercontent.com/fbuloup/Interface_IAI/main/Simulation/oneAxisSimulation.m}{code}}}} Matlab.
\end{frame}

\section{Planning !}
\begin{frame}
\begin{block}{Étapes suivantes - Propositions}
\begin{itemize}
\item Achat des composants électroniques
\item Câblage sur platine d'essai pour tests
\item Corrections carte PCB
\item Achat carte PCB et composants pour coffret mural
\item Développement partie commande des axes
\end{itemize}
\end{block}
\end{frame}

\end{document}
