fbuloup/Interface_IAI/Documentation/documentation.pdf

## Interface IAI - Partie électronique

frank.buloup@univ-amu.fr

Institut des Sciences du Mouvement

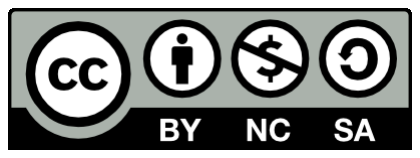
[picture p13: figure]
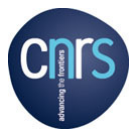
[picture p14: figure]
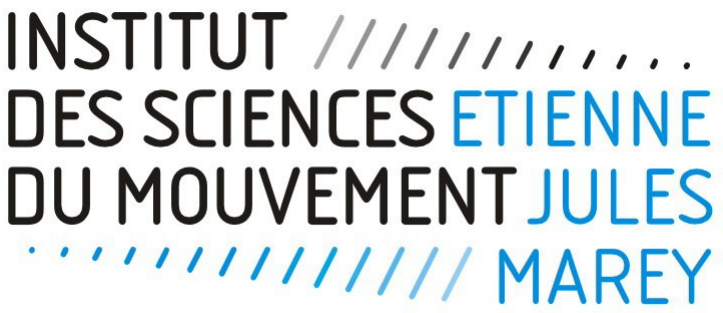
[picture p15: figure]
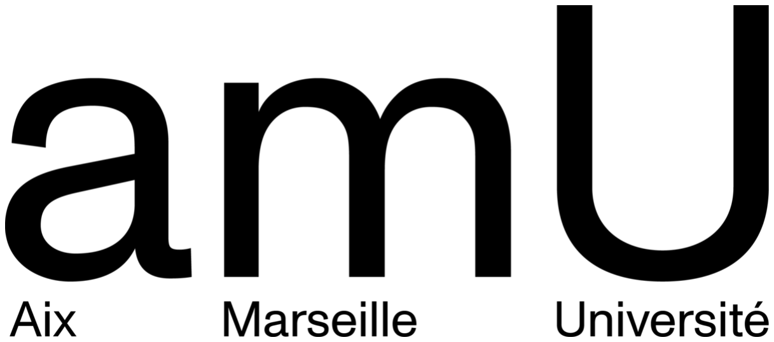
[picture p16: figure]

Documentation Principe de la commande Caractéristiques des deux axes Interface avec un ADWinPro Simulation Planning !

## Interface IAI

1 | Documentation
2 | Principe de la commande
3 | Caractéristiques des deux axes
4 | Interface avec un ADWinPro
5 | Simulation
6 | Planning !
Interface IAI - Partie électronique | 2/ 55

1 Documentation

Documentation actionneurs (https://raw.githubusercontent.com/fbuloup/Interface_IAI/main/Documentation/RCS4-SLIDER(ME3769-1H).pdf)
Documentation contrôleurs (https://raw.githubusercontent.com/fbuloup/Interface_IAI/main/Documentation/SCON-CB_CGB(ME0340-8A).pdf) Documentation PC Software (https://raw.githubusercontent.com/fbuloup/Interface_IAI/main/Documentation/RCM-101-MW_USB(ME0155-31A).pdf)

Documentation ADWinPro I (https://raw.githubusercontent.com/fbuloup/Interface_IAI/main/Documentation/ProI-HW_eng.pdf)

2 Principe de la commande Commande par impulsions Signaux PIO accessibles en mode impulsions Résolution et UTD Rapport de réduction Vitesses minimale et maximale absolues Fréquences minimale et maximale absolues Vitesse obtenue et fréquence de commande Mouvement fluide Feedback

Commande par impulsions

Ref. (https://raw.githubusercontent.com/fbuloup/Interface_IAI/main/Documentation/SCON-CB_CGB(ME0340-8A).pdf)

Le mode de commande par impulsion est celui que l’on utilisera. L’autre mode, appelé commande par positionnement, présuppose de connaitre les positions à l’avance, ce qui est impossible dans notre cas. Le mode par impulsions est décrit ici. (https://raw.githubusercontent.com/fbuloup/Interface_IAI/main/Documentation/SCON-CB_CGB(ME0340-8A).pdf) Chaque impulsion fait bouger le moteur d’une quantité appelée Unit Travel Distance (UTD). La fréquence des impulsions règle la vitesse du mouvement. De ce point de vue, on peut dire que la commande est effectuée en vitesse. Le réglage des différents paramètres pour configurer ce mode peut être trouvé en suivant ce lien (https://raw.githubusercontent.com/fbuloup/Interface_IAI/main/Documentation/SCON-CB_CGB(ME0340-8A).pdf) : réglage du rapport de réduction électronique, du type et de la polarité du train d’impulsions.

Commande par impulsions

Pour fonctionner en mode impulsion, l’interrupteur 1 (SW1) en façade du contrôleur doit être positionné sur ON et le paramètre numéro 25 qui défini le type de PIO (PIO pattern) doit être à 1 (codeur de type absolu sans batterie). L’interrupteur 2 (SW2) en façade ne doit jamais être bougé (toujours sur OFF). Il est alors possible de définir une position de référence quelconque différente du ”Home”. Elle est défini par le paramètre No. 167. Après l’activation du servo, on utilise l’entrée PIO RSTR et la sortie PIO REND indique son atteinte.

Pour économiser des entrées/sorties du DIO32, certains signaux du PIO ne sont pas utilisés. * correspond à une logique négative

Ref. (https://raw.githubusercontent.com/fbuloup/Interface_IAI/main/Documentation/SCON-CB_CGB(ME0340-8A).pdf)

Signaux PIO accessibles en mode impulsions

Signaux PIO utilisés - Sorties ADWin
SON, pour activer le moteur
RES, pour acquitter une alarme sans intervention manuelle HOME : faire origine depuis ADwin (cod. abs. sans batterie)

CSTP : arrêt forcé, en plus de l’arrêt d’urgence câblé.
RSTR : Reference STaRt

Signaux PIO utilisés - Entrées ADWin
SV : servo prêt ? Avant d’envoyer des impulsions

INP : pour savoir si l’actionneur a rejoint la consigne HEND : pour savoir si l’origine est faite
*ALM : arrêt de l’envoi d’impulsions si défaut.

REND : Reference END
*EMGS : arrêt d’urgence appuyé

Signaux PIO accessibles en mode impulsions
Signaux PIO inutilisés - Sorties ADWin
RMOD : Il permet de basculer entre AUTO et MANU depuis le PIO, quand le commutateur du contrôleur est en position AUTO.

DCLR : efface le compteur de déviation. Utile lors d’opération de poussées qui décalent les positions de consigne et réelle.

Signaux PIO inutilisés - Entrées ADWin
PWR : câblé sur la LED en face avant du contrôleur
RMDS : indique si le contrôleur est en mode AUTO ou MANU (ON en mode manuel). En mode MANU, le SCON ignore les commandes du PIO et les impulsions. C’est le cas, par exemple, si quelqu’un a laissé le commutateur en façade sur MANU après un réglage avec le logiciel IAI. Avec RMDS, l’ADwin pourrait le détecter et arrêter toute commande : ce choix n’a pas été fait.

Signaux PIO accessibles en mode impulsions

Signaux PIO inutilisés - Entrées ADWin
ZONE1, ZONE2 : on peut faire la même chose avec l’ADWin puisqu’on a le feedback du SCON.
*OVLW/*ALML : alerte de surcharge / alarme légère. C’est un signal de diagnostic préventif : il prévient avant que le défaut ne devienne une vraie alarme (*ALM). Avec nos vitesses et petites charges, une surcharge est peu probable.

Résolution et UTD
Résolution
Les codeurs optique ont 14 bits. On obtient donc 2¹⁴ impulsions par tour moteur. Un tour moteur fait avancer l’actionneur du pas de la vis à bille (BSL en mm/tour). On obtient alors BSL
2

14 mm
par impulsion. C’est le plus petit mouvement réalisable : c’est la résolution.

resolution =

BSL
2

14

Distance unitaire parcourue (UTD)

On peut d’autre-part fixer notre propre résolution (celle que l’on souhaite avoir) exprimée également en mm par impulsion : Unit
Travel Distance (UTD). Bien sur UTD ne peut ˆ | être plus petit que
la résolution !

UTD ≥ resolution

Résolution et UTD

! Remarque !

Sur cette page (https://raw.githubusercontent.com/fbuloup/Interface_IAI/main/Documentation/SCON-CB_CGB(ME0340-8A).pdf) il est mentionné le terme de ”Actuator Lead Length” dans la formule générale. Nos actionneurs RC4 sont des modèles à moteurs dans l’axe, couplés directement à la vis. Donc ”Actuator Lead Length” et ”Ball Screw Lead” sont équivalents.

Rapport de réduction

Rapport de réduction
Le rapport de ces deux quantités donne un nombre sans dimension qui exprime le rapport de réduction entre le nombre d’impulsions réelles et le nombre d’impulsions résultant du choix de notre résolution :

UTD
resolution =

UTD

BSL
2

14

= N

CNUM et DNUM
Ce rapport de réduction N est pris en compte dans les contrôleurs sous la forme de deux paramètres : CNUM et CDEN (paramètres 65 et 66) :

N =

CNUM
CDEN =

2

14
BSL

∗ UTD

Vitesses minimale et maximale absolues

Vitesse minimale absolue : Vmin
La vitesse minimale absolue (mm/s) est définie de la façon suivante (voir ici, (https://raw.githubusercontent.com/fbuloup/Interface_IAI/main/Documentation/RCS4-SLIDER(ME3769-1H).pdf) la résolution étant en mm/pulse) :

Vmin = resolution ∗ 1000(pulse/s)

Ce qui signifie que la fréquence de la commande par impulsion ne peut être inférieur à 1000Hz lorsque l’on travaille avec la résolution de l’appareil.

Vitesse maximale absolue : Vmax
Elle est donnée dans la documentation des actionneurs.

Fréquences minimale et maximale absolues

Fréquences min et max absolues
Avec ces vitesses absolues (mm/s), on peut connaitre l’intervalle de variation absolue de la fréquence de commande par impulsions :

Fmin =

Vmin
UTD

Fmax =

Vmax
UTD

Vitesse obtenue et fréquence de commande

Vitesse obtenue v
La vitesse (mm/s) obtenue dépend alors de notre UTD (mm/pulse) et de la fréquence des impulsions de commande (Hz) :

v = UTD ∗ f

Avec :

Vmin ≤ vmin ≤ v ≤ vmax ≤ Vmax

vmin et vmax étant les vitesses min et max que l’on se fixe.

Fréquence de commande f
Elle doit vérifier :

Fmin ≤ fmin ≤ f ≤ fmax ≤ Fmax

fmin et fmax étant les fréquences min et max que l’on se fixe.

Mouvement fluide

Pour que le mouvement soit fluide, il faut que l’UTD soit suffisamment petit mais également que la fréquence de commande soit suffisamment grande afin que la mise à jour de la position soit assez fréquente. C’est un compromis à trouver.

Feedback

Le réglage des différents paramètres pour configurer le feedback peut être trouvé en suivant ce lien (https://raw.githubusercontent.com/fbuloup/Interface_IAI/main/Documentation/SCON-CB_CGB(ME0340-8A).pdf) : réglage du rapport de réduction électronique, du type et de la polarité du train d’impulsions. Il semble qu’une partie de ce réglage ne soit pas obligatoire : si le paramètre No 114 est laissé à zéro (paramètres de feedback non applicable, non utilisé), ce sont les paramètres No 65 et 66 qui s’appliquent (ceux de la commande par impulsions). Au contraire, si le paramètre No 114 est passé à un, il faut alors régler les paramètres No 115 et 116 pour définir un rapport de réduction différent de la commande.

3 Caractéristiques des deux axes Axe 0 - Celui du dessous Axe 0 - Celui du dessous - Mouvement fluide Axe 0 - Celui du dessous - Calcul de N, CNUM et CDEN Axe 1 - Celui du dessus Axe 1 - Celui du dessus - Mouvement fluide Axe 1 - Celui du dessus - Calcul de N, CNUM et CDEN

Axe 0 - Celui du dessous

Actionneur : RCS4-SA8C-WA-400-30-200-T2-S (Ref.) (https://raw.githubusercontent.com/fbuloup/Interface_IAI/main/Documentation/RCS4-SLIDER(ME3769-1H).pdf)

Masse : 5.6kg - Codeur absolu sans batterie - 400 watts
Pas de la vis à bille (Ball Screw Lead) : 30mm par tour moteur Course totale (Stroke Length) : 200mm
Vitesse maximale absolue (Vmax ) : 1800mm/s

Force nominale en continu : 226N
Codeur : 16384 impulsions par tour moteur
Charge utile horizontale : 30kg - Charge utile verticale : 12kg

resolution =

BSL(mm)
16384(pulses)

=

30
16384

= 1.83µm

Vmin =

BSL(mm)
16384(pulses)

∗ 1000(pulse/s) = 30000
16384

= 1.83mm/s

Axe 0 - Celui du dessous

Contrôleur : SCON-CB-400WAI-PN-2-2 Type standard, 400 watts
Codeur absolu/incrémental sans batterie

Type PNP : type source de courant
PIO de type PNP

Commande par positionnement ou impulsions différentielles Les entrées PIO doivent être positionnées au moins 6ms pour prise en compte (commandes reçues de l’ADwin)

CSTP doit être positionnée au moins 16 ms

Axe 0 - Celui du dessous

Grandeurs absolues
Vmax = 1800mm/s et Vmin = 1.83mm/s

Exemple de calcul I
Si on se fixe UTD = resolution, vmax = 1500mm/s et
vmin = 2mm/s. Alors Fmax = 983.606kHz et Fmin = 1000Hz, fmax = 819.672kHz et fmin = 1093Hz

Exemple de calcul II
Si on se fixe UTD = 0.5mm, vmax = 120mm/s et vmin = 5mm/s. Alors Fmax = 3600Hz et Fmin = 3.66Hz, fmax = 240Hz et
fmin = 10Hz

Axe 0 - Celui du dessous - Mouvement fluide

En mode train d’impulsions, chaque impulsion déplace la consigne de position du SCON d’un bloc de 0.5mm. À 5mm/s, soit 10Hz, l’actionneur reçoit une nouvelle consigne toutes les 100ms : il parcourt rapidement 0.5mm, s’arrête, attend l’impulsion suivante, et ainsi de suite. Le mouvement sera donc saccadé, alors même que 5mm/s est au-dessus de la vitesse minimale de 1, 83mm/s.

Il est alors préférable de raisonner à partir d’une fréquence min assez grande. Prenons fmin = 500Hz. On obtient avec vmin = 5mm/s, UTD = 10µm et avec vmax = 120mm/s, fmax = 12kHz. 12kHz devrait être réalisable avec un ADwin. Si on rencontre des difficultés, il sera préférable de diminuer vmax plutôt que d’augmenter UTD.

Axe 0 - Celui du dessous - Calcul de N, CNUM et CDEN
Avec l’exemple II on obtiendrait :

N =

CNUM
CDEN =

2

14
BSL

∗ UTD =

16384
3000

=

2048
375
CNUM = 2048 CDEN = 375

Vérification à faire ! (Ref.) (https://raw.githubusercontent.com/fbuloup/Interface_IAI/main/Documentation/SCON-CB_CGB(ME0340-8A).pdf)

2

27 ≥

SL
BSL

∗ 2

14 ∗

CDEN
CNUM (1)?

2

31 ≥

SL
BSL

∗ 2

14 ∗ CNUM (2)?

2

31 ≥

SL
BSL

∗ 2

14 ∗ CDEN (3)?

Les vérifications (2) et (3) ne sont pas à faire car la version du contrôleur est V0019.

Axe 0 - Celui du dessous - Calcul de N, CNUM et CDEN

Pour vérifier la version du firmware, avec RC PC Software, une fois connecté au contrôleur, chercher la commande d’informations de version du contrôleur, dans le menu Help ↔ Version Information. Elle affiche les versions des différents logiciels internes (CPU principal, etc.). C’est la version du contrôleur qui compte ici. Le manuel ME0155 du logiciel indique l’emplacement exact de cette commande.
Documentation PC Software (https://raw.githubusercontent.com/fbuloup/Interface_IAI/main/Documentation/RCM-101-MW_USB(ME0155-31A).pdf)

Dans cette fenêtre, il existe deux numéros de version : Controller Version : AA090019h → V0019
Controller Core Version : AA840003h → V0003
V0019
Le réglage des différents paramètres pour configurer la commande peut être trouvé en suivant ce lien (https://raw.githubusercontent.com/fbuloup/Interface_IAI/main/Documentation/SCON-CB_CGB(ME0340-8A).pdf) : réglage du rapport de réduction électronique, du type et de la polarité du train d’impulsions.

Axe 1 - Celui du dessus

Actionneur : RCS4-SA7C-WA-200-24-200-T2-R03 (Ref.) (https://raw.githubusercontent.com/fbuloup/Interface_IAI/main/Documentation/RCS4-SLIDER(ME3769-1H).pdf)

Masse : 4.3kg - Codeur absolu sans batterie - 200 watts
Pas de la vis à bille (Ball Screw Lead) : 24mm par tour moteur Course totale (Stroke Length) : 200mm
Vitesse maximale absolue (Vmax ) : 1500mm/s

Force nominale en continu : 142N
Codeur : 16384 impulsions par tour moteur
Charge utile horizontale : 30kg - Charge utile verticale : 7kg

resolution =

BSL(mm)
16384(pulses)

=

24
16384

= 1.46µm

Vmin =

BSL(mm)
16384(pulses)

∗ 1000(pulse/s) = 24000
16384

= 1.46mm/s

Axe 1 - Celui du dessus

Contrôleur : SCON-CB-200WAI-PN-2-2 Type standard, 200 watts
Codeur absolu/incrémental sans batterie

Type PNP : type source de courant PIO de type PNP

Commande par positionnement Commande par impulsions différentielles

Axe 1 - Celui du dessus

Grandeurs absolues
Vmax = 1500mm/s et Vmin = 1.46mm/s

Exemple de calcul I
Si on se fixe UTD = resolution, vmax = 1300mm/s et
vmin = 2mm/s. Alors Fmax = 1027.397kHz et Fmin = 1000Hz, fmax = 890.41kHz et fmin = 1.369kHz

Exemple de calcul II
Si on se fixe UTD = 0.5mm, vmax = 120mm/s et vmin = 5mm/s. Alors Fmax = 3000Hz et Fmin = 2.92Hz, fmax = 240Hz et
fmin = 10Hz

Axe 1 - Celui du dessus - Mouvement fluide

En mode train d’impulsions, chaque impulsion déplace la consigne de position du SCON d’un bloc de 0.5mm. À 5mm/s, soit 10Hz, l’actionneur reçoit une nouvelle consigne toutes les 100ms : il parcourt rapidement 0.5mm, s’arrête, attend l’impulsion suivante, et ainsi de suite. Le mouvement sera donc saccadé, alors même que 5mm/s est au-dessus de la vitesse minimale de 1, 46mm/s.

Il est alors préférable de raisonner à partir d’une fréquence min assez grande. Prenons fmin = 500Hz. On obtient avec vmin = 5mm/s, UTD = 10µm et avec vmax = 120mm/s, fmax = 12kHz. 12kHz devrait être réalisable avec un ADwin. Si on rencontre des difficultés, il sera préférable de diminuer vmax plutôt que d’augmenter UTD.

Axe 1 - Celui du dessus - Calcul de N, CNUM et CDEN
Avec l’exemple II on obtiendrait :

N =

CNUM
CDEN =

2

14
BSL

∗ UTD =

16384
2400

=

512
75
CNUM = 512 CDEN = 75

Vérification à faire ! (Ref.) (https://raw.githubusercontent.com/fbuloup/Interface_IAI/main/Documentation/SCON-CB_CGB(ME0340-8A).pdf)

2

27 ≥

SL
BSL

∗ 2

14 ∗

CDEN
CNUM (1)?

2

31 ≥

SL
BSL

∗ 2

14 ∗ CNUM (2)?

2

31 ≥

SL
BSL

∗ 2

14 ∗ CDEN (3)?

Les vérifications (2) et (3) ne sont pas à faire car la version du contrôleur est V0019.

Axe 1 - Celui du dessus - Calcul de N, CNUM et CDEN

Pour vérifier la version du firmware, avec RC PC Software, une fois connecté au contrôleur, chercher la commande d’informations de version du contrôleur, dans le menu Help → Version Information. Elle affiche les versions des différents logiciels internes (CPU principal, etc.). C’est la version du contrôleur qui compte ici. Le manuel ME0155 du logiciel indique l’emplacement exact de cette commande.
Documentation PC Software (https://raw.githubusercontent.com/fbuloup/Interface_IAI/main/Documentation/RCM-101-MW_USB(ME0155-31A).pdf)

Dans cette fenêtre, il existe deux numéros de version : Controller Version : AA090019h → V0019
Controller Core Version : AA840003h → V0003
V0019
Le réglage des différents paramètres pour configurer la commande peut être trouvé en suivant ce lien (https://raw.githubusercontent.com/fbuloup/Interface_IAI/main/Documentation/SCON-CB_CGB(ME0340-8A).pdf) : réglage du rapport de réduction électronique, du type et de la polarité du train d’impulsions.

4 Interface avec un ADWinPro Généralités Schémas et principe de l’interface Aperçus du routage PCB Coffret mural Implantation schématique dans le coffret Câblage (pour mémo !) Ordre de prix et devis

Généralités

Pulse, feedback et PIO
Une carte pour adapter les signaux SCON ↔ ADWin

Commande par impulsion et non par positionnement
La commande sera faite avec des sorties DIO32 de l’ADwin Les états des signaux PIO seront lus/positionnés avec des entrées/sorties DIO32 de l’ADwin

La lecture du feedback sera faite avec une carte CO4-T de l’ADwin
Une carte par paire contrôleur/actionneur (par axe)

Schémas et principe de l’interface

Alimentation
Alimentation 24V externe
Diode Schottky de protection contre l’inversion de polarité

Régulateur 5V à découpage
Diodes témoins 5V et 24V
Fusible réarmable

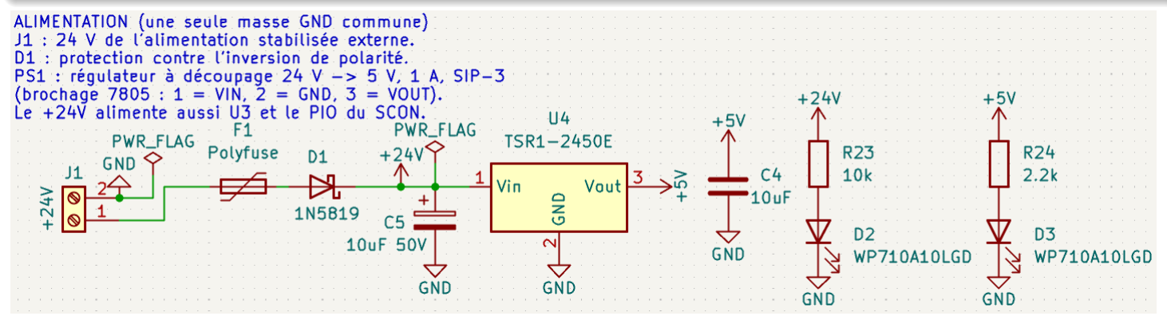
[picture p17: figure]

Schémas et principe de l’interface

Pulse
Signaux TTL PP et NP convertis en signaux différentiels 4V (https://raw.githubusercontent.com/fbuloup/Interface_IAI/main/Documentation/SCON-CB_CGB(ME0340-8A).pdf)

Résistances de limitation de courant et de pull down Principe de la commande ici (https://raw.githubusercontent.com/fbuloup/Interface_IAI/main/Documentation/SCON-CB_CGB(ME0340-8A).pdf)

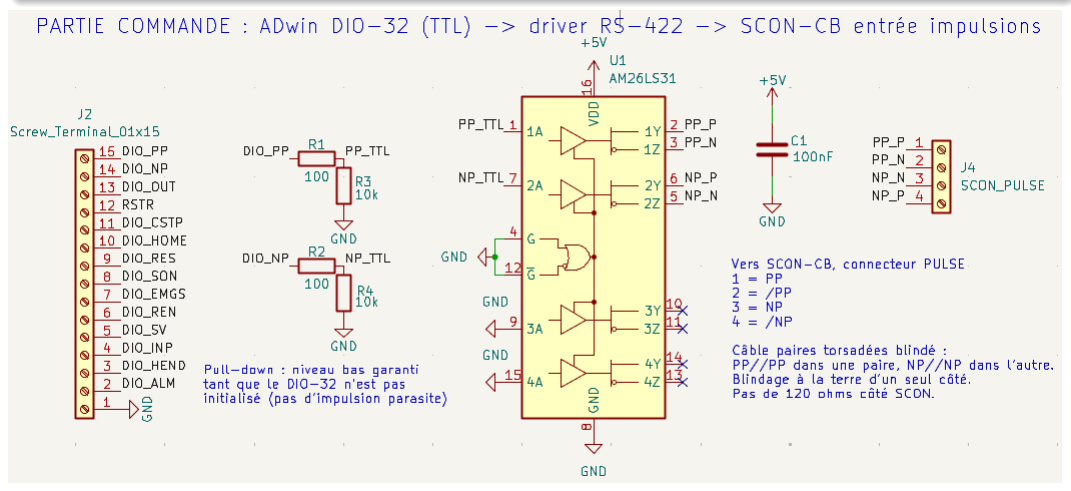
[picture p18: figure]

Schémas et principe de l’interface

Feedback
Signaux de retour de position du moteur

Résistances de limitation vers entrées ADWin Résistances de terminaison côté sortie SCON

Principe de la commande ici (https://raw.githubusercontent.com/fbuloup/Interface_IAI/main/Documentation/SCON-CB_CGB(ME0340-8A).pdf)

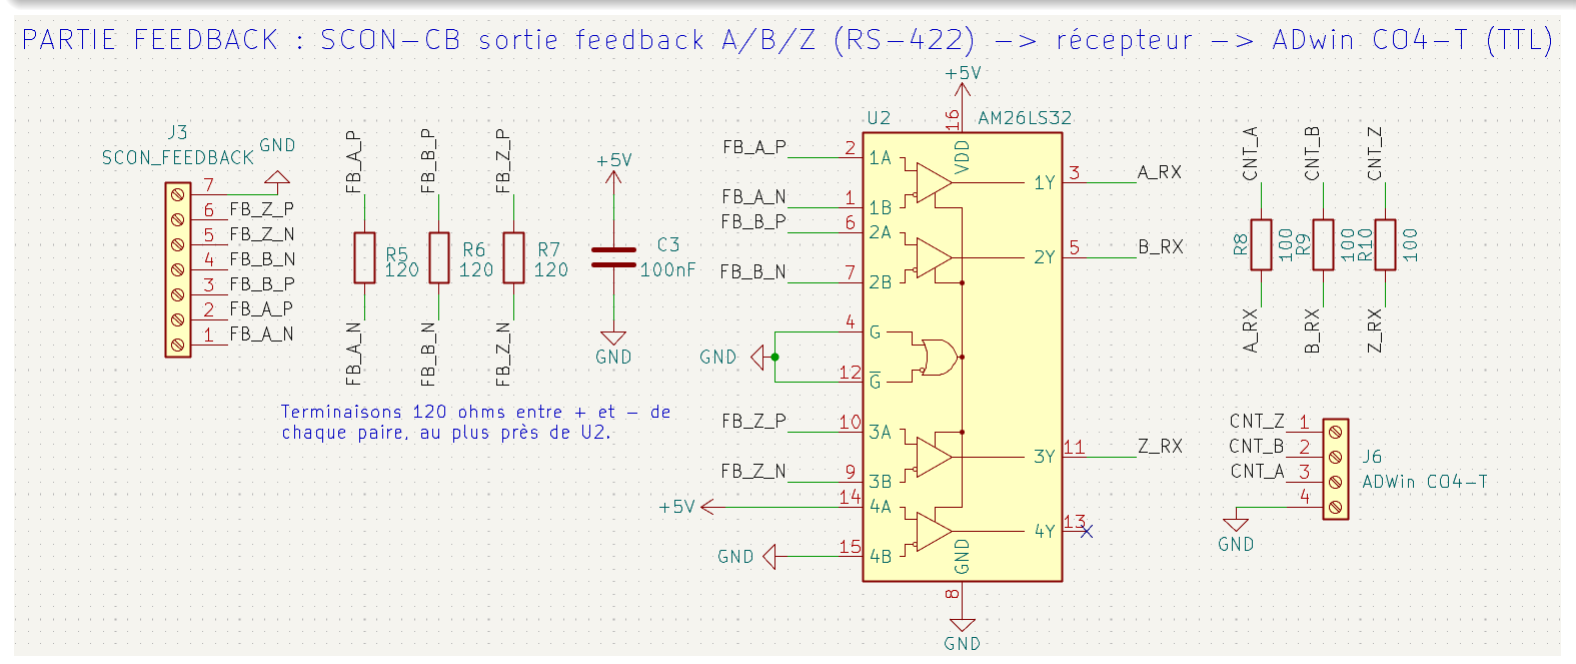
[picture p19: figure]

Schémas et principe de l’interface

PIO
Adaptation niveaux TTL vers niveaux 24V
Adaptation niveaux 24V vers niveaux TTL par pont diviseur Résistance de pull down pour stabilité
Un seul signal de réserve : une sortie ADWin vers SCON

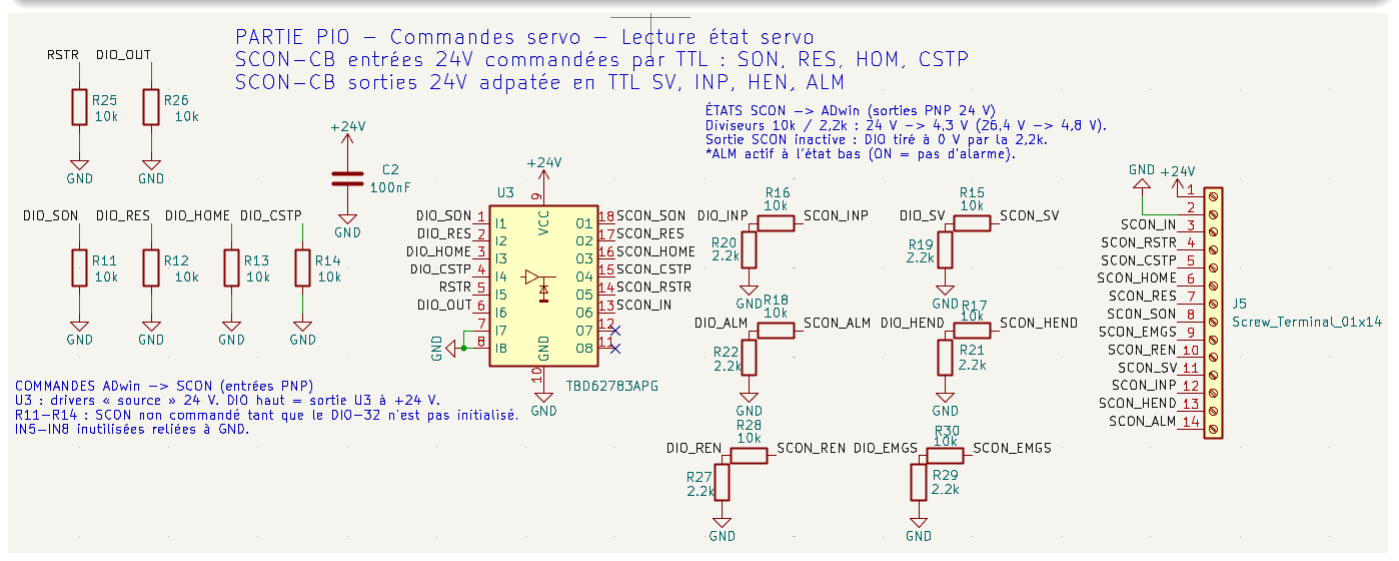
[picture p20: figure]

Aperçus du routage PCB

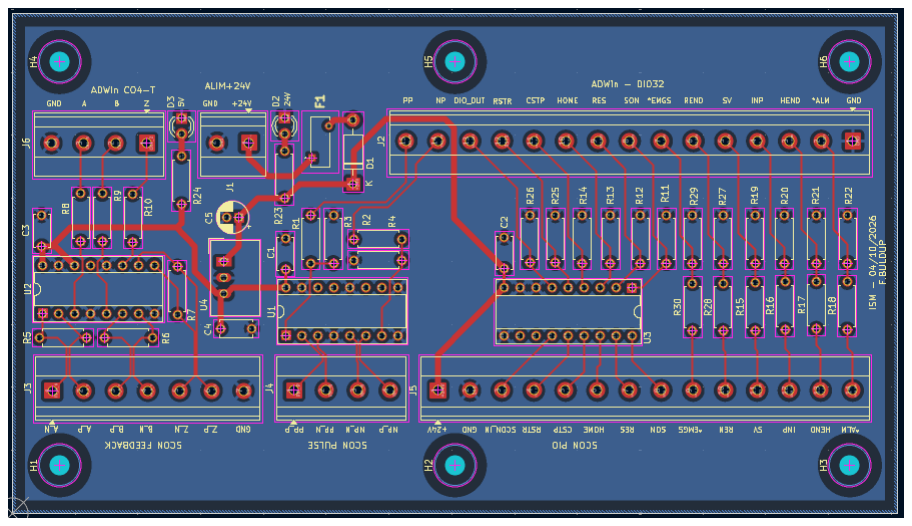
[picture p21: figure]

Aperçus du routage PCB

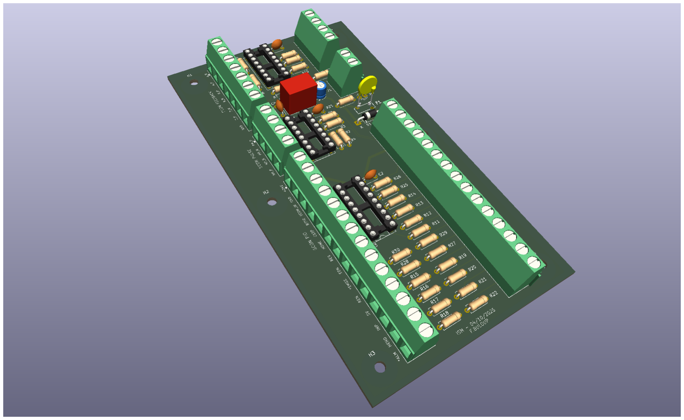
[picture p22: figure]

Aperçus du routage PCB

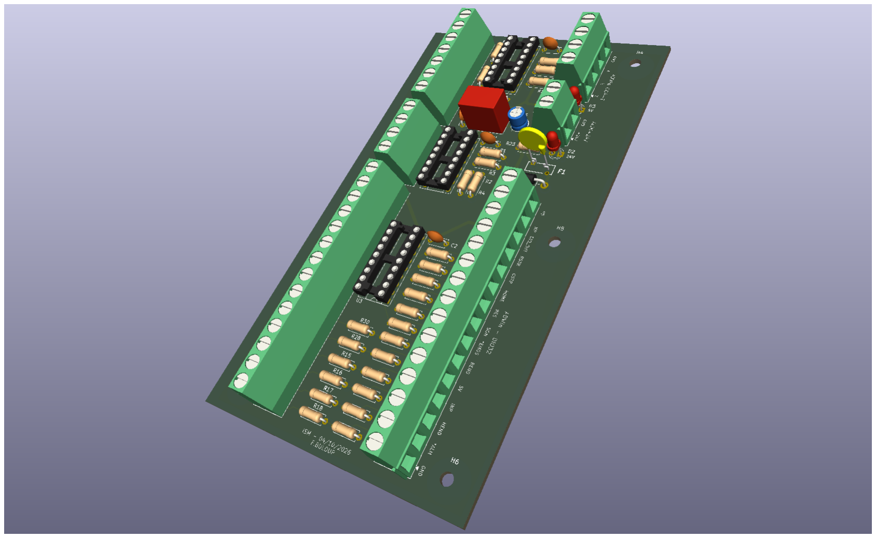
[picture p23: figure]

Coffret mural


Avec plaque de châssis (terre) et de presse-étoupes

Coffret mural

Les différents éléments
1 différentiel de protection globale

2 disjoncteurs de protection des contrôleurs 1 alimentation 24V
1 disjoncteur de protection alimentation 24V
2 filtres EMI et 8 noyaux de ferrites pour limiter le bruit

2 rail DIN pour recevoir les modules
7 presse-étoupes Ø 4 à 9 mm pour sortir du coffret

1 presse-étoupe : arrêt d’urgence
2 presse-étoupes : câbles vers ADWin (DIO32 et CO4-T) 4 presse-étoupes : câbles SCON ↔ RCS4

Câblage en goulotte
Connecteur CEI en panneau

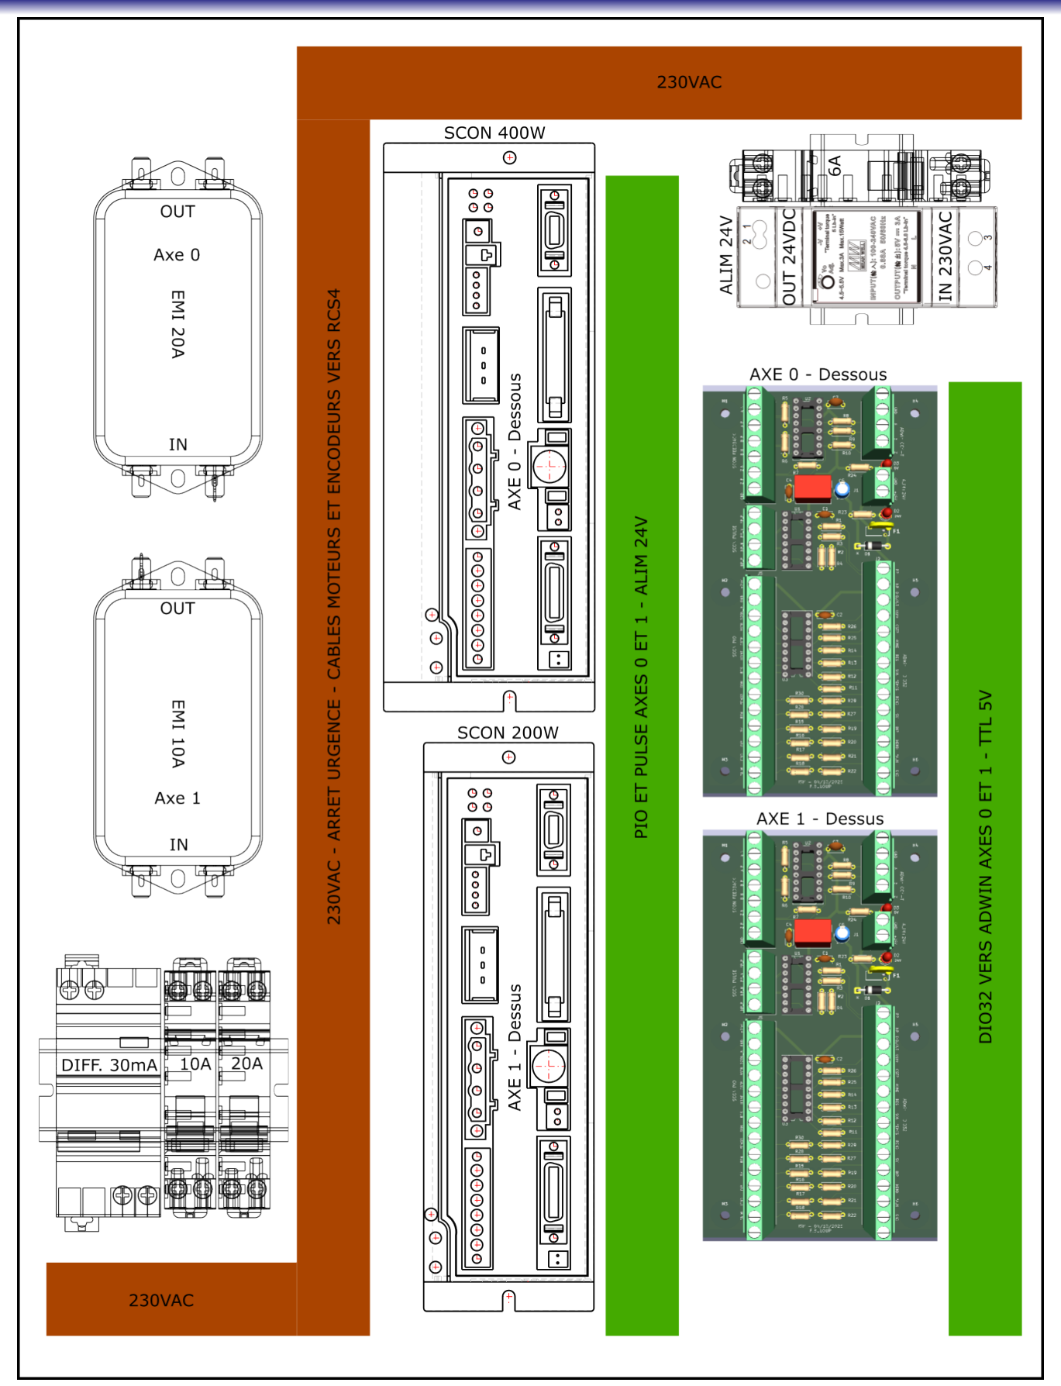
[picture p24: figure]

Implantation schématique dans le coffret

Implantation schématique dans le coffret

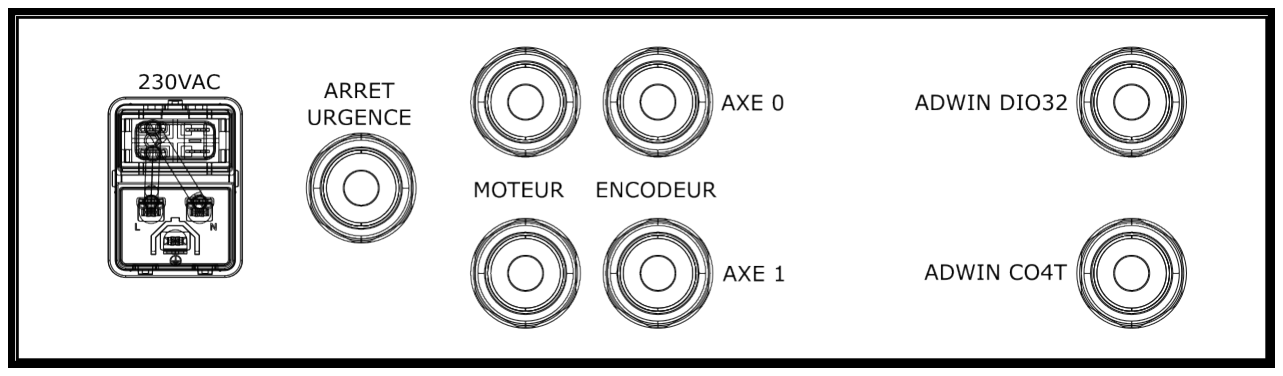
[picture p25: figure]

Plaque presse-étoupes

Câblage (pour mémo !)
Liaisons SCON ↔ Carte PCB : utiliser les deux câbles fournis (PULSE + FEEDBACK et PIO) pour chaque axe. Garder des longueurs d’environ 10 à 15cm. Visser dans les borniers côté carte PCB.
Liaisons Carte PCB ↔ ADWin : utiliser des câbles blindés avec des connecteurs DA-37 mâles pour les DIO et les CO4-T. Visser dans les borniers côté carte PCB. Ces câbles qui partent vers l’ADWin auront leurs tresses reliées à la terre du coffret. Ces tresses ne devront pas être reliées côté ADWin (règle du blindage d’un seul côté, éviter les boucles de masse). L’inverse est possible.
Utiliser les goulottes pour passer les câbles dans le coffret et des presse-étoupes pour passer en dehors si possible ! Immunité au bruit : ne pas relier la masse électronique des PCB (GND) à la terre du coffret et croiser les câbles signaux et de puissance à la perpendiculaire

Câblage (pour mémo !)

Table: Brochage côté ADWin DIO-32 (DA-37 femelle)

Broche Signal

19 | PP0 (out)
37 | NP0 (out)
18 | SON0 (out)
36 | RES0 (out)
17 | HOME0 (out)
35 | CSTP0 (out)
16 | DIO RSTR0 (out)
34 | DIO OUT0 (out)
15 | SV0 (in)
33 | INP0 (in)
14 | HEND0 (in)
32 | ALM0 (in)
13 | DIO REND0 (in)
31 | DIO EMGS0 (in)

Broche Signal

12 | SV1 (in)
30 | INP1 (in)
11 | HEND1 (in)
29 | ALM1 (in)
10 | DIO REND1 (in)
28 | DIO EMGS1 (in)
7 | PP1 (out)
25 | NP1 (out)
6 | SON1 (out)
24 | RES1 (out)
5 | HOME1 (out)
23 | CSTP1 (out)
4 | DIO RSTR1 (out)

Broche Signal

22 | DIO OUT1 (out)
3 | GND

DIO OUT0 : sortie de réserve pour l’axe 0 (entrée SCON)

DIO OUT1 : sortie de réserve pour l’axe 1 (entrée SCON)

Voir ici pour le brochage (https://raw.githubusercontent.com/fbuloup/Interface_IAI/main/Documentation/ProI-HW_eng.pdf#page=89)

Câblage (pour mémo !)

Table: Brochage côté ADWin CO4-T (DA-37 femelle)

Broche | Signal
19 | Z0
37 | N.C.
18 | N.C.
36 | A0
17 | B0
15 | Z1
33 | N.C.
14 | N.C.
32 | A1
13 | B1
3 | GND

Voir ici pour le brochage (https://raw.githubusercontent.com/fbuloup/Interface_IAI/main/Documentation/ProI-HW_eng.pdf#page=121)

Ordre de prix et devis

Table: Ordres de prix pour les deux axes

Poste | Prix approximatif HT
Carte chez eurocircuits | 180
Composants pour circuit imprimé | 95
Coffret mural | 1310
Total HT | 1580

Devis Eurocircuits (https://raw.githubusercontent.com/fbuloup/Interface_IAI/main/Documentation/DevisEurocircuits.pdf)
Fichier Excel prix (https://raw.githubusercontent.com/fbuloup/Interface_IAI/main/Interface_IAI.xlsx)

5 Simulation Loi de commande

Loi de commande


Loi de commande

Le repère (O,x,y) de l’OptiTrack devrait correspondre aux axes moteurs. Les positions des moteurs sont récupérées par le feedback. On calcule à tout instant les différences entre les positions moteurs et les positions du marqueur en x et y :
{︄
δx = markerx − motorx
δy = markery − motory

Puis, à partir de ces différences, on peut calculer la fréquence à envoyer à chacun des axes selon la fonction présentée dans le graphe ci-après. On pourrait tout à fait envisager d’autres lois.

Loi de commande

ε | δmax

F(ε) = fmin

F(δmax) = fmax

|δ| − mm

F(|δ|) − Hz

| 0 ≤ |δ| < ε : F = | | fmax−fmin | 0
ε ≤ |δ| ≤ δmax : F = | δ > | δmax : | δmax F = fmax | |δ| + fmin

On peut prendre ϵ =

UTD
2

Loi de commande

Une simulation peut être faite en utilisant ce code (https://raw.githubusercontent.com/fbuloup/Interface_IAI/main/Simulation/oneAxisSimulation.m) Matlab.

6 Planning !

Etapes suivantes - Propositions ´

Achat des composants électroniques Câblage sur platine d’essai pour tests
Corrections carte PCB
Achat carte PCB et composants pour coffret mural

Développement partie commande des axes
