fbuloup/Interface_IAI/Documentation/images/by-nc-sa-eps-converted-to.pdf

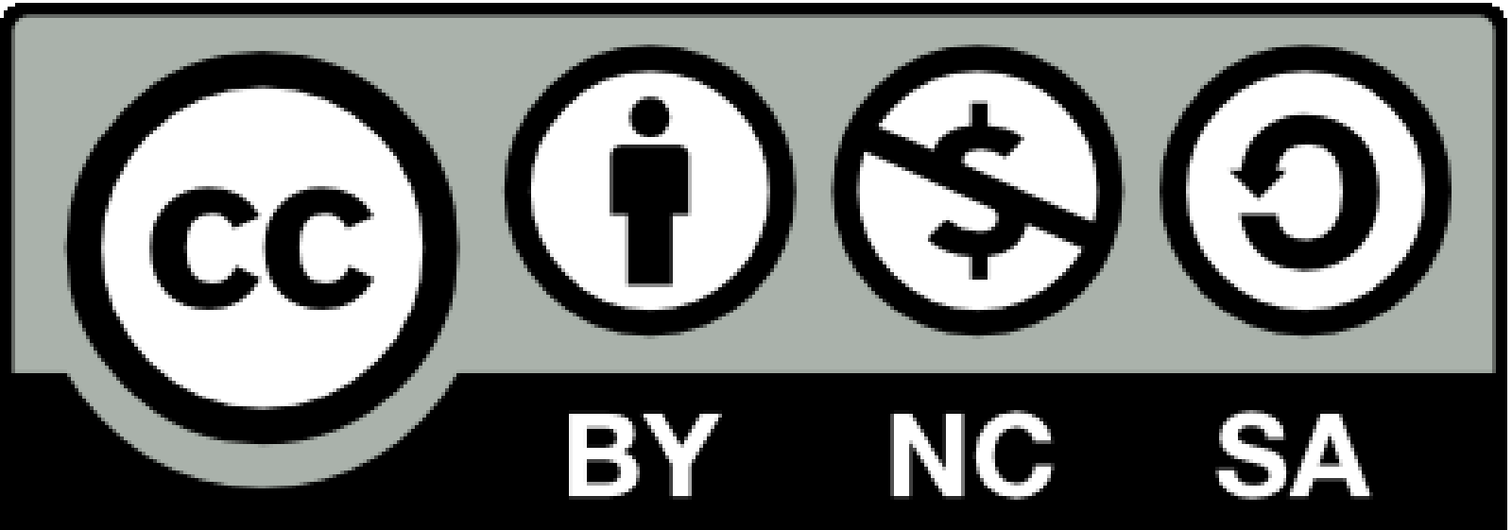
[picture p26: page 1]
