fbuloup/Interface_IAI/Documentation/images/LogoCNRS-eps-converted-to.pdf

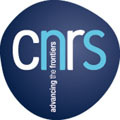
[picture p27: page 1]
