fbuloup/Interface_IAI/Documentation/images/LogoISM-eps-converted-to.pdf

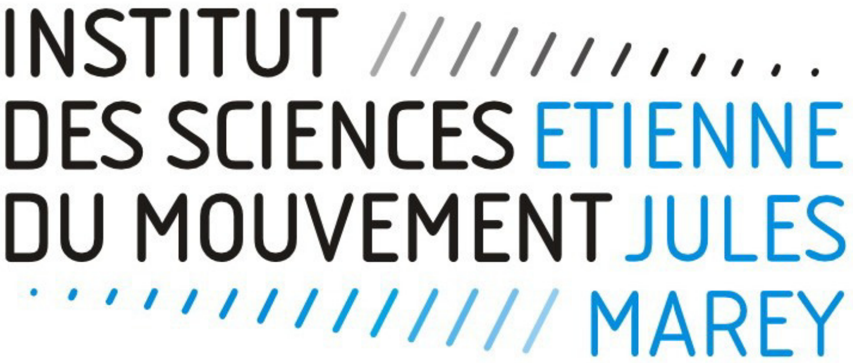
[picture p28: page 1]
