fbuloup/Interface_IAI/Documentation/images/Alim24.PNG

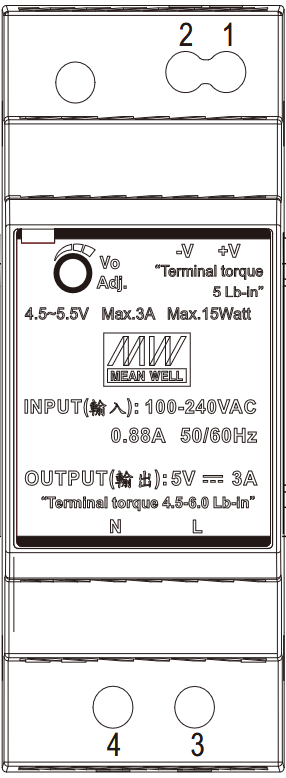
Documentation/images/Alim24.PNG
