fbuloup/Interface_IAI/Documentation/images/Boitier.PNG

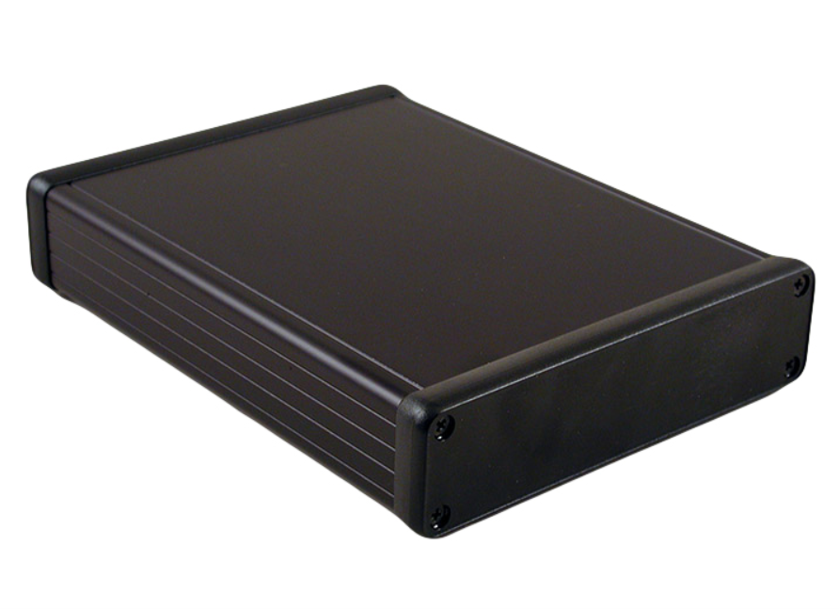
Documentation/images/Boitier.PNG
