fbuloup/Interface_IAI/Documentation/images/IAI_Models/IAI_RCS4SA7CWA20024200T2R0300/RCS4-SA7C-WA-200-24-200-T2-R03(0-0)_front.bmp

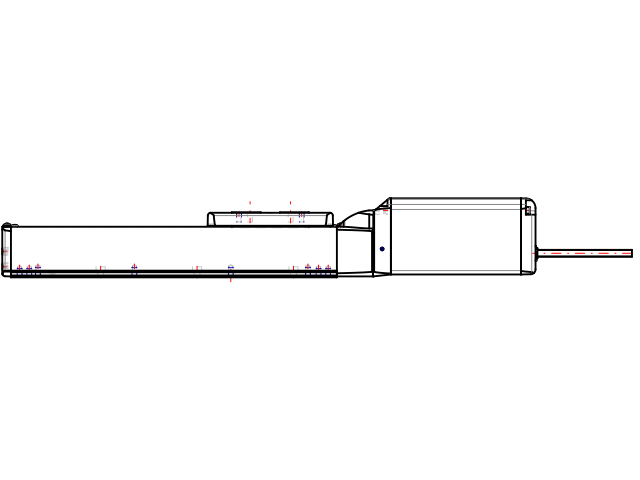
Documentation/images/IAI_Models/IAI_RCS4SA7CWA20024200T2R0300/RCS4-SA7C-WA-200-24-200-T2-R03(0-0)_front.bmp
