fbuloup/Interface_IAI/Documentation/images/IAI_Models/IAI_RCS4SA8CWA40030200T2P00/RCS4-SA8C-WA-400-30-200-T2-P(0-0)_right.bmp

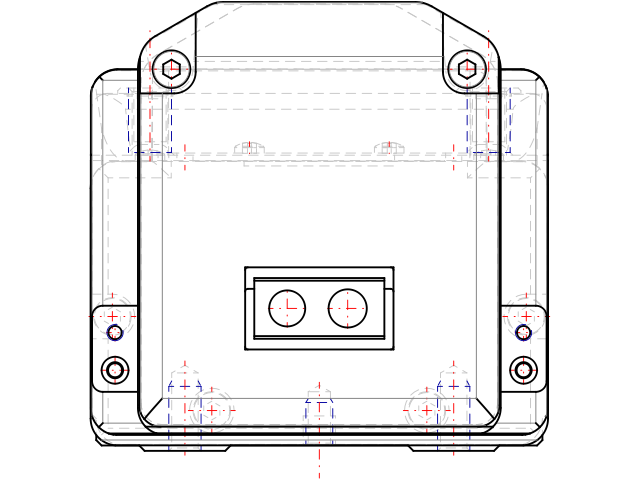
Documentation/images/IAI_Models/IAI_RCS4SA8CWA40030200T2P00/RCS4-SA8C-WA-400-30-200-T2-P(0-0)_right.bmp
