fbuloup/Interface_IAI/Documentation/images/IAI_Models/IAI_SCONCGB200WAIPN22/SCON-CGB-200WAI-PN-2-2.bmp

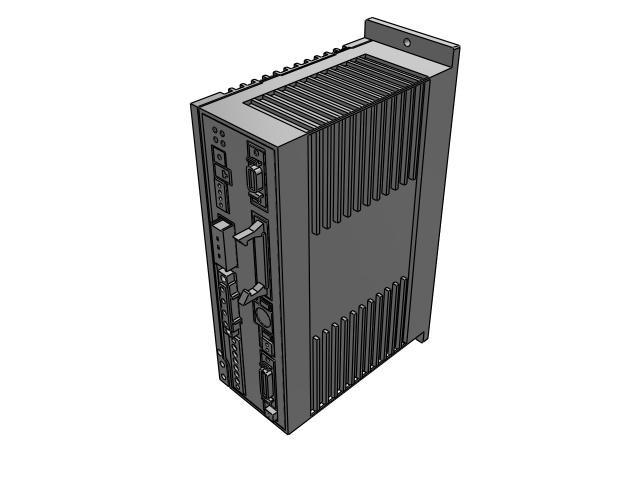
Documentation/images/IAI_Models/IAI_SCONCGB200WAIPN22/SCON-CGB-200WAI-PN-2-2.bmp
