fbuloup/Interface_IAI/Documentation/images/IAI_Models/IAI_SCONCGB400WAIPN22/SCON-CGB-400WAI-PN-2-2_front.bmp

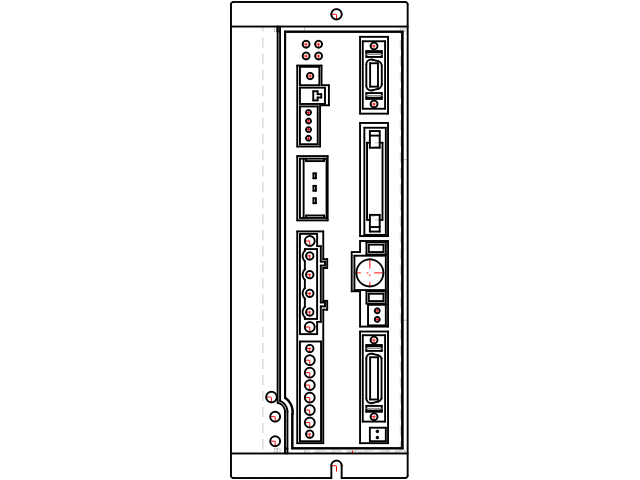
Documentation/images/IAI_Models/IAI_SCONCGB400WAIPN22/SCON-CGB-400WAI-PN-2-2_front.bmp
