fbuloup/Interface_IAI/Documentation/images/implantation_coffret.png

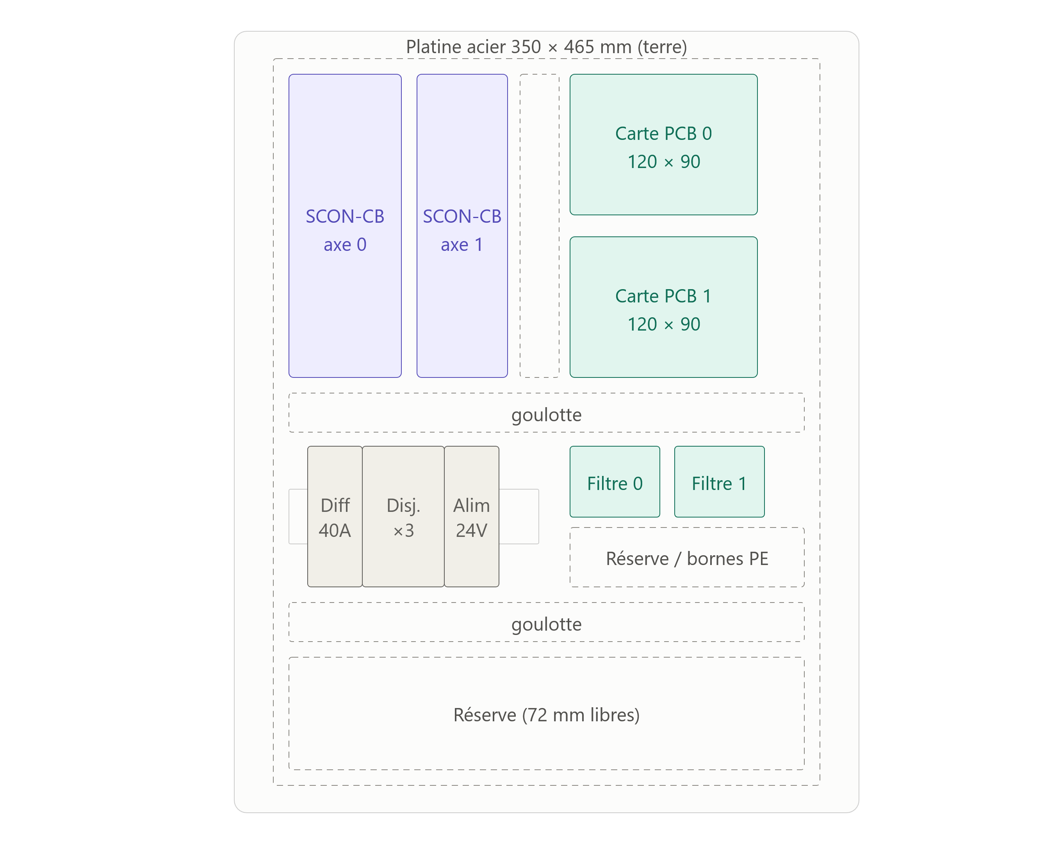
Documentation/images/implantation_coffret.png
