fbuloup/Interface_IAI/Documentation/images/Interface_IAI_3.png

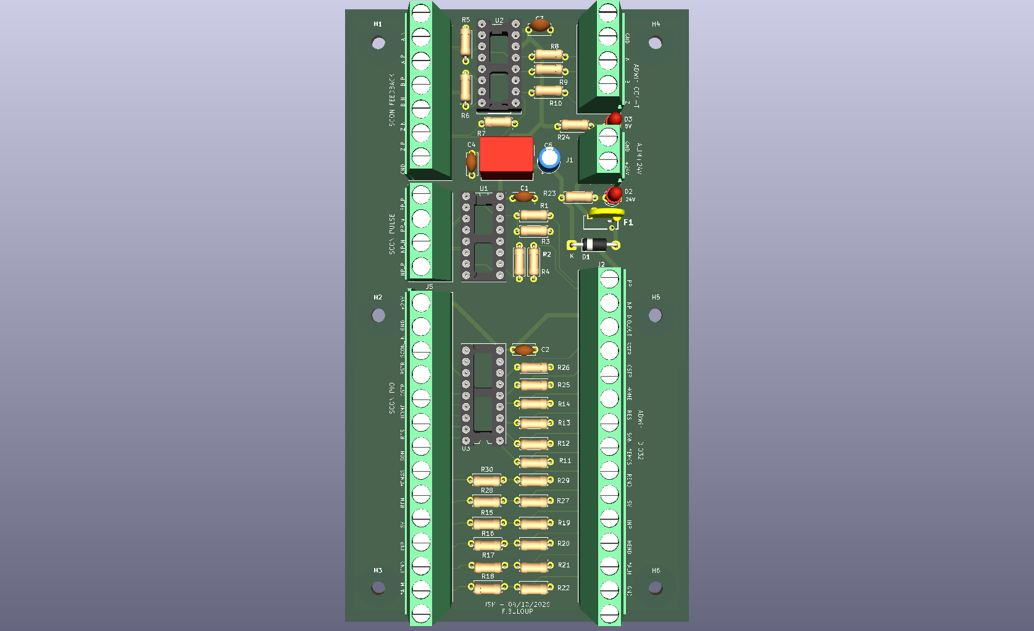
Documentation/images/Interface_IAI_3.png
