fbuloup/Interface_IAI/Documentation/images/Interface_IAI_4.png

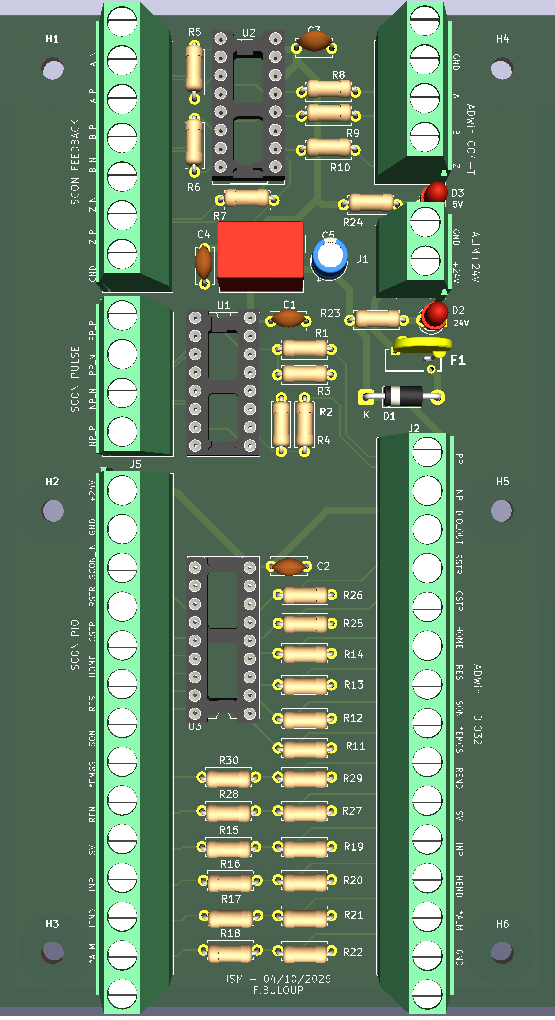
Documentation/images/Interface_IAI_4.png
