fbuloup/Interface_IAI/Interface_IAI.xlsx

Composants pour cicuit imprimé
Reference | Qté | Qté totale | Valeur | Fournisseur | Reference | PUHT | PTHT
C1,C2,C3 | 3 | 6 | 100nF | Digikey | BC3323-ND | 0.23 | 1.38
C4 | 1 | 2 | 10uF | Digikey | 399-13968-ND | 5.11 | 10.22
C5 | 1 | 2 | 10uF 50V | Digikey | 399-6100-ND | 0.15 | 0.3
D1 | 1 | 2 | 1N5819 | Digikey | 1801-1N5819CT-ND | 0.27 | 0.54
D2 | 1 | 2 | MF-R050 | Digikey | MF-R050-ND | 0.41 | 0.82
J1.2 | 1 | 2 | +24V | Digikey | 277-1247-ND | 0.81 | 1.62
J2.4 | 3 | 6 | ADWIN_DIO32 | Digikey | 277-1249-ND | 1.66 | 9.96
J2.3 | 1 | 2 | ADWIN_DIO32 | Digikey | 277-1264-ND | 1.46 | 2.92
J3.4 | 1 | 2 | SCON_FEEDBACK | Digikey | 277-1249-ND | 1.66 | 3.32
J3.3 | 1 | 2 | SCON_FEEDBACK | Digikey | 277-1264-ND | 1.46 | 2.92
J4.4 | 1 | 2 | SCON_PULSE | Digikey | 277-1249-ND | 1.66 | 3.32
J5.2 | 1 | 2 | SCON_PIO | Digikey | 277-1247-ND | 0.81 | 1.62
J5.4 | 3 | 6 | SCON_PIO | Digikey | 277-1249-ND | 1.66 | 9.96
J6.4 | 1 | 2 | ADWin CO4-T | Digikey | 277-1249-ND | 1.66 | 3.32
R1,R2,R8,R9,R10 | 5 | 10 | 100 | Digikey | 100XBK-ND | 0.09 | 0.9
R3,R4,R11,R12,R13,R14,R15,R16,R17,R18,R23,R25,R26,R28,R30 | 15 | 30 | 10k | Digikey | 10.0KXBK-ND | 0.09 | 2.7
R5,R6,R7 | 3 | 6 | 120 | Digikey | MFR-25FBF52-120R-ND | 0.09 | 0.54
R19,R20,R21,R22,R24,R27,R29 | 7 | 14 | 2.2k | Digikey | MFR-25FBF52-2K2-ND | 0.09 | 1.26
U1 | 1 | 2 | AM26LS31 | Digikey | 296-1374-5-ND | 1.81 | 3.62
U2 | 1 | 2 | AM26LS32 | Digikey | 296-1376-5-ND | 1.94 | 3.88
U3 | 1 | 2 | TBD62783APG | Digikey | TBD62783APG-ND | 2.52 | 5.04
U4 | 1 | 2 | R-78K5.0-1.0 | Digikey | 945-R-78K5.0-1.0-ND | 3.41 | 6.82
Support CI DIP 16 | 2 | 4 |  | Digikey | ED3016-ND | 0.95 | 3.8
Support CI DIP 18 | 1 | 2 |  | Digikey | 123-AR18-HZL-TT-ND | 0.95 | 1.9
LED | 2 | 4 | WP710A10LGD | Digikey | 754-1609-ND | 0.19 | 0.76
Entretoise hexagonale M3, polyamide | 6 | 12 |  | Digikey | 732-12994-ND | 0.76 | 9.12
Fusible | 1 | 2 |  | Digikey | MF-R050-ND | 0.41 | 0.82
 |  |  |  |  |  | Total HT | 93.38
Circuit imprimé
Reference | Qté | Qté totale | Valeur | Fournisseur | Reference | PUHT | PTHT
Circuit imprimé | 1 | 2 |  | Eurocircuits | B5452603 | 90.34 | 180.68
 |  |  |  |  |  | Total HT | 180.68
Coffret mural avec protection
Reference | Qté | Qté totale | Valeur | Fournisseur | Reference | PUHT | PTHT
Coffret mural | 0 | 0 |  | Radiospares | 775-5322 | 97.34 | 0
Rail DIN à couper | 1 | 2 |  | Radiospares | 200-6731 | 7.53 | 15.06
Goulotte (1 paquet de 4 unités) | 0.5 | 1 |  | Radiospares | 879-3713 | 27.09 | 27.09
Presse-étoupe Ø 4 à 9 mm (1 sachet de 5 unités) | 1 | 2 |  | Radiospares | 669-4660 | 7.91 | 15.82
Un disjoncteur différentiel 30mA, 40A, type C | 0.5 | 1 |  | Radiospares | 238-3297 | 244.52 | 244.52
Alimentation sur Rail DIN | 0.5 | 1 |  | Radiospares | 145-7868 | 22.77 | 22.77
Disjoncteur 6A | 0.5 | 1 |  | Radiospares | 175-3722 | 20.64 | 20.64
disjoncteur 20A axe 0 | 0.5 | 1 |  | Radiospares | 175-3725 | 13.32 | 13.32
disjoncteur 10A axe 1 | 0.5 | 1 |  | Radiospares | 175-3723 | 13.32 | 13.32
Filtre EMI 20A | 0.5 | 1 |  | Radiospares | 292-818 | 67.75 | 67.75
Filtre EMI 10A | 0.5 | 1 |  | Radiospares | 708-4272 | 52.9 | 52.9
noyaux de ferrite | 4 | 8 |  | Radiospares | 916-4336 | 10.46 | 83.68
Connecteur SubD 37 male | 1 | 2 |  | Radiospares | 300-295 | 7.89 | 15.78
Capot connecteur SubD 37 | 1 | 2 |  | Radiospares | 251-677 | 4.92 | 9.84
Connecteur CEI Droit C20 Schurter, Panneau Mâle | 0.5 | 1 |  | Radiospares | 498-2710 | 21.89 | 21.89
Connecteur CEI Droit C19 Schurter, Câble | 0.5 | 1 |  | Radiospares | 295-8759 | 9.83 | 9.83
Câble industriels multiconducteur (36 - 25m) | 0.5 | 1 |  | Radiospares | 236-9258 | 181.19 | 181.19
 |  |  |  |  |  | Total HT | 815.4
 |  |  |  |  | Grand total HT |  | 1089.46 €
 |  |  |  |  | Grand total TTC |  | 1307.35 €
