fbuloup/Interface_IAI/Documentation/images/Disj10A/r9pfc610_front.dxf

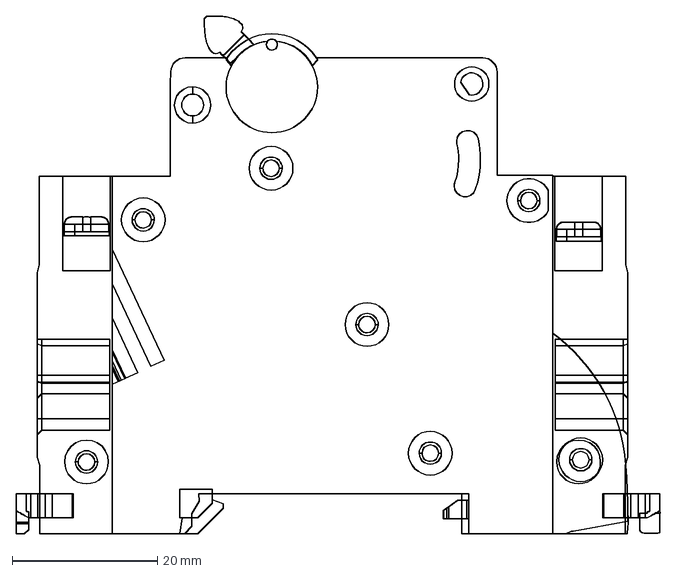
[picture p45: CAD file, 2026-10-14]
Documentation/images/Disj10A/r9pfc610_front.dxf
88.6 x 71.2 mm
