fbuloup/Interface_IAI/Documentation/images/Disj20A/r9pfc620_front.dxf

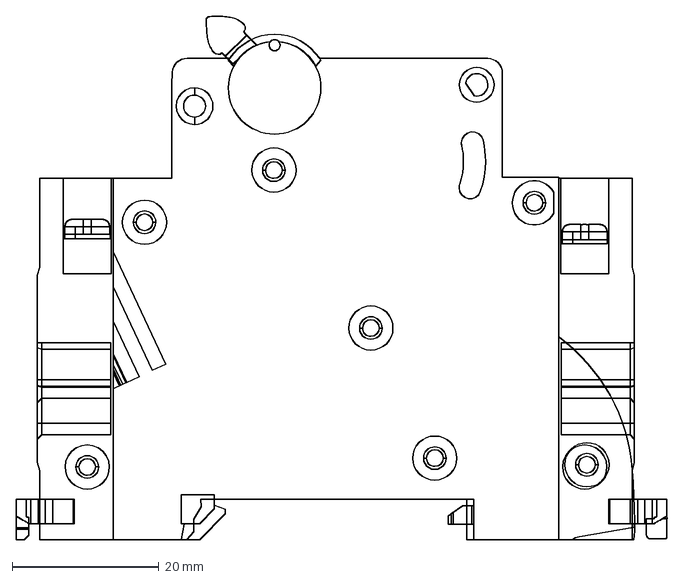
[picture p46: CAD file, 2026-10-14]
Documentation/images/Disj20A/r9pfc620_front.dxf
88.6 x 71.2 mm
