fbuloup/Interface_IAI/Documentation/images/Disj6A/r9pfc606_top.dxf

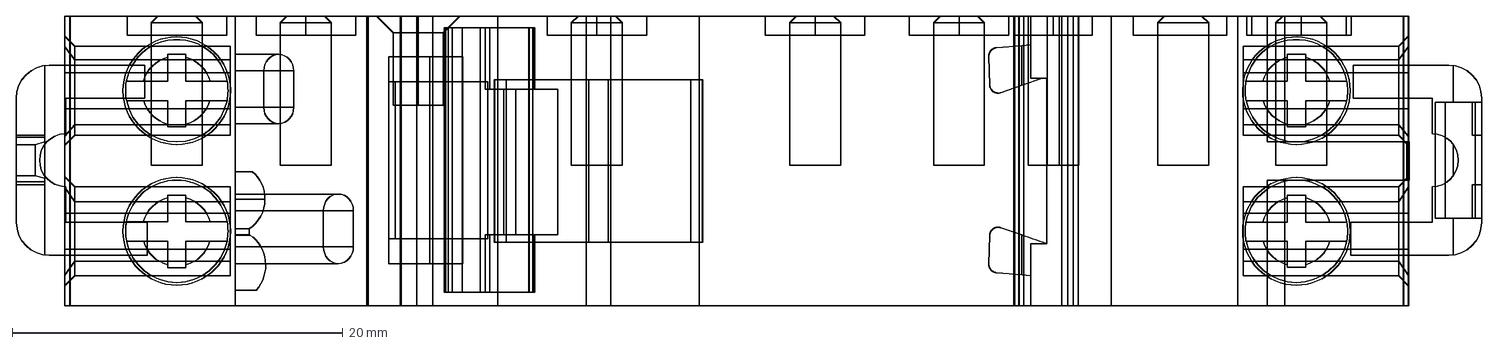
[picture p47: CAD file, 2026-10-14]
Documentation/images/Disj6A/r9pfc606_top.dxf
88.6 x 17.5 mm
