fbuloup/Interface_IAI/Documentation/images/FiltreEMI10A/fn2090b-10-06_right.dxf

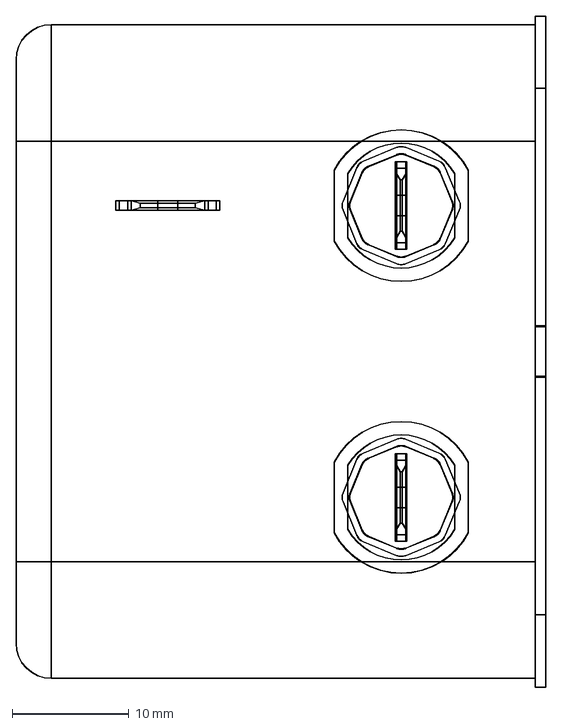
[picture p48: CAD file, 2026-10-14]
Documentation/images/FiltreEMI10A/fn2090b-10-06_right.dxf
45.4 x 57.5 mm
