fbuloup/Interface_IAI/Documentation/images/FiltreEMI20A/fn2090-20-06_front.dxf

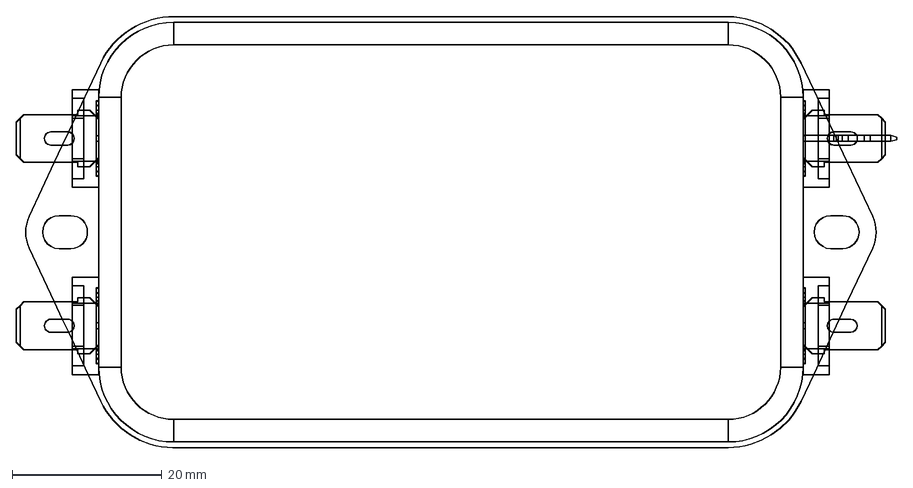
[picture p49: CAD file, 2026-10-14]
Documentation/images/FiltreEMI20A/fn2090-20-06_front.dxf
117.5 x 57.5 mm
