fbuloup/Interface_IAI/Documentation/images/ConnecteurAlim/ec11_0001_001_left.dxf

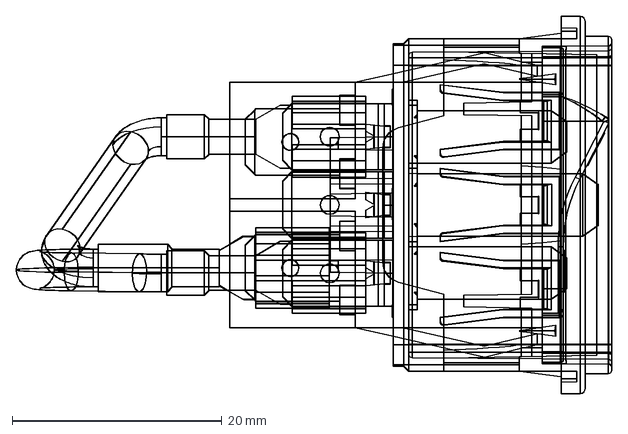
[picture p50: CAD file, 2026-10-14]
Documentation/images/ConnecteurAlim/ec11_0001_001_left.dxf
56.7 x 36.0 mm
