fbuloup/Interface_IAI/Documentation/images/Disj10A/r9pfc610_iso.dxf

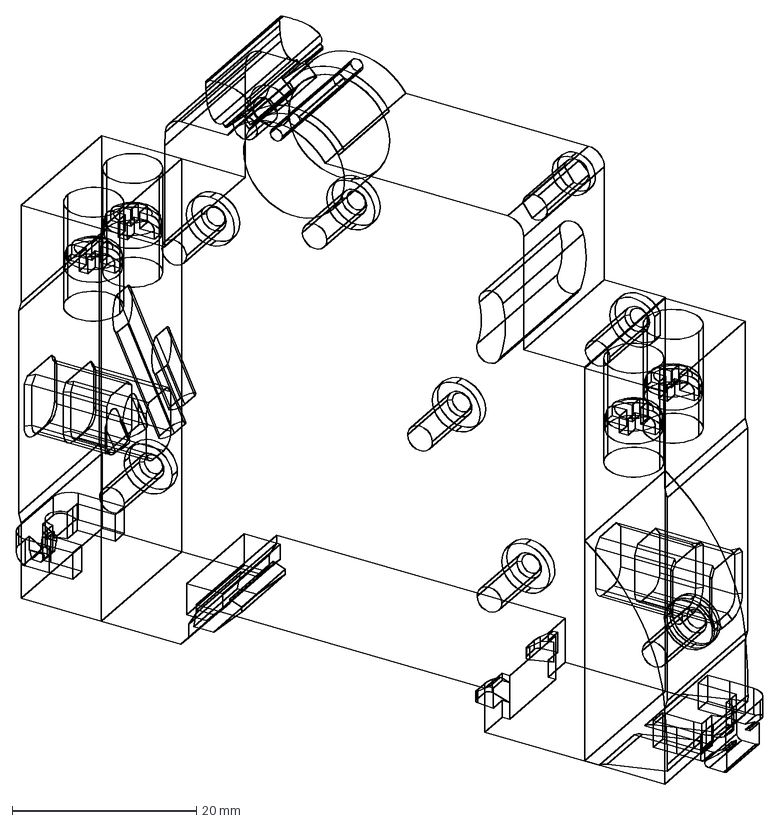
[picture p51: CAD file, 2026-10-14]
Documentation/images/Disj10A/r9pfc610_iso.dxf
81.0 x 83.3 mm
