fbuloup/Interface_IAI/Documentation/images/Disj20A/r9pfc620_right.dxf

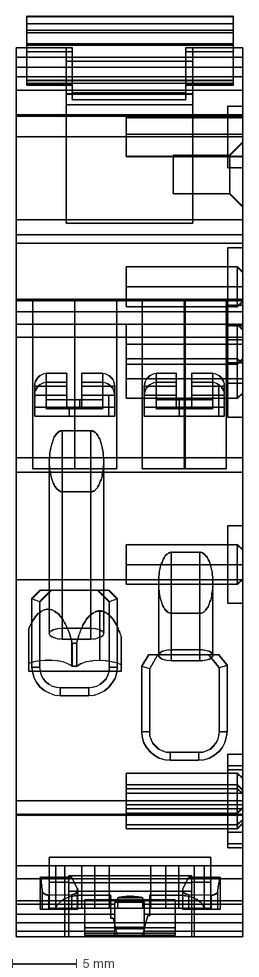
[picture p52: CAD file, 2026-10-14]
Documentation/images/Disj20A/r9pfc620_right.dxf
17.5 x 71.2 mm
