fbuloup/Interface_IAI/Documentation/images/Disj6A/r9pfc606_right.dxf

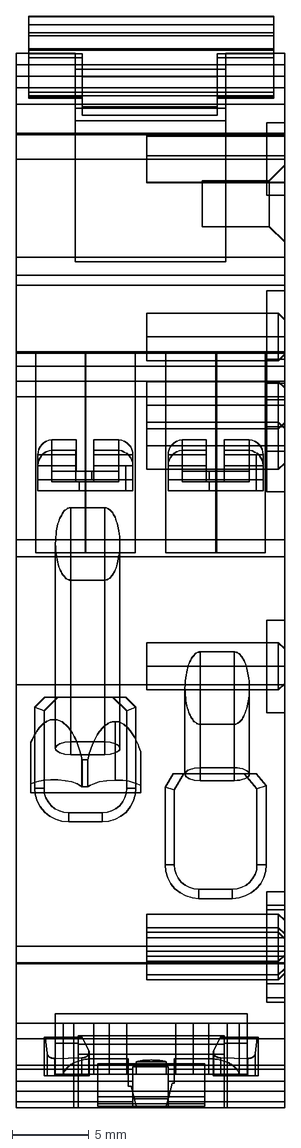
[picture p53: CAD file, 2026-10-14]
Documentation/images/Disj6A/r9pfc606_right.dxf
17.5 x 71.2 mm
