fbuloup/Interface_IAI/Documentation/images/FiltreEMI10A/fn2090b-10-06_left.dxf

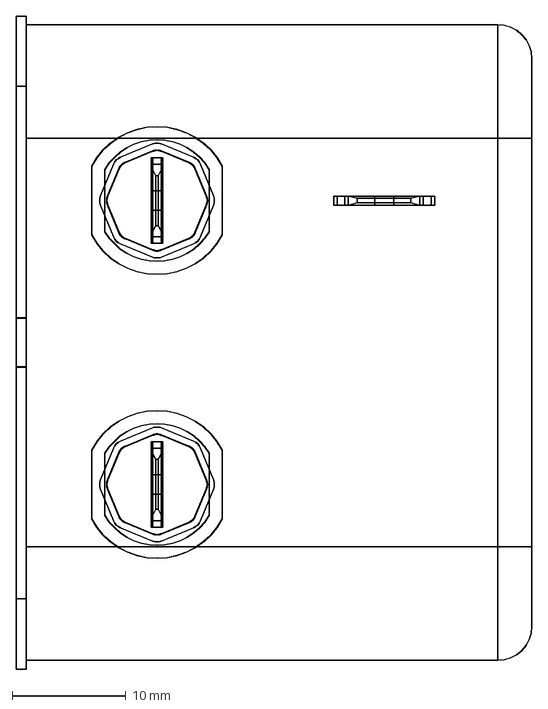
[picture p54: CAD file, 2026-10-14]
Documentation/images/FiltreEMI10A/fn2090b-10-06_left.dxf
45.4 x 57.5 mm
