fbuloup/Interface_IAI/Documentation/images/FiltreEMI20A/fn2090-20-06_right.dxf

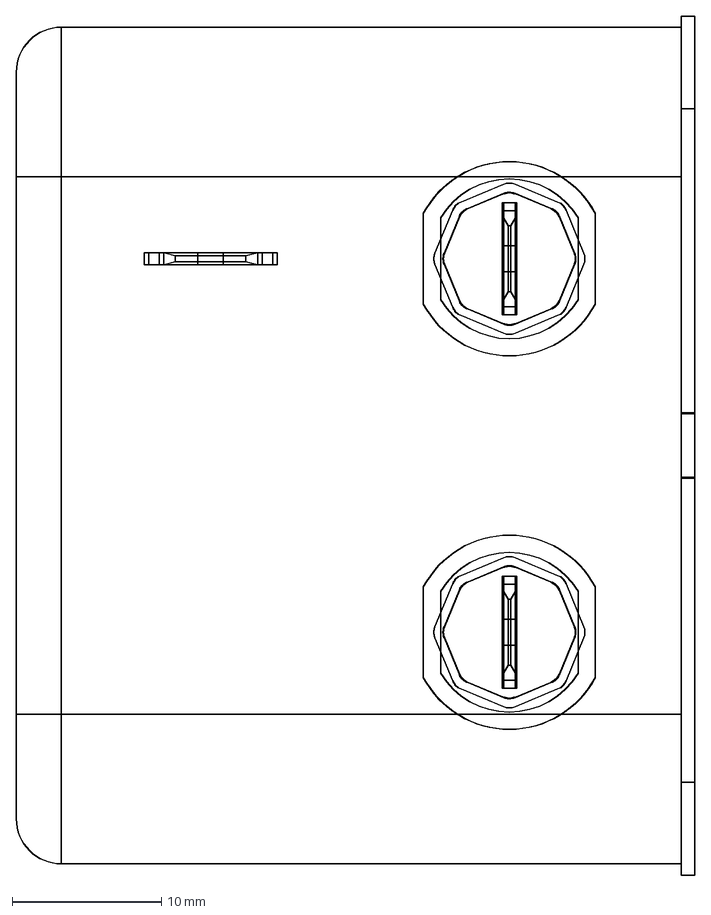
[picture p55: CAD file, 2026-10-14]
Documentation/images/FiltreEMI20A/fn2090-20-06_right.dxf
45.4 x 57.5 mm
