fbuloup/Interface_IAI/Documentation/images/ConnecteurAlim/ec11_0001_001_iso.dxf

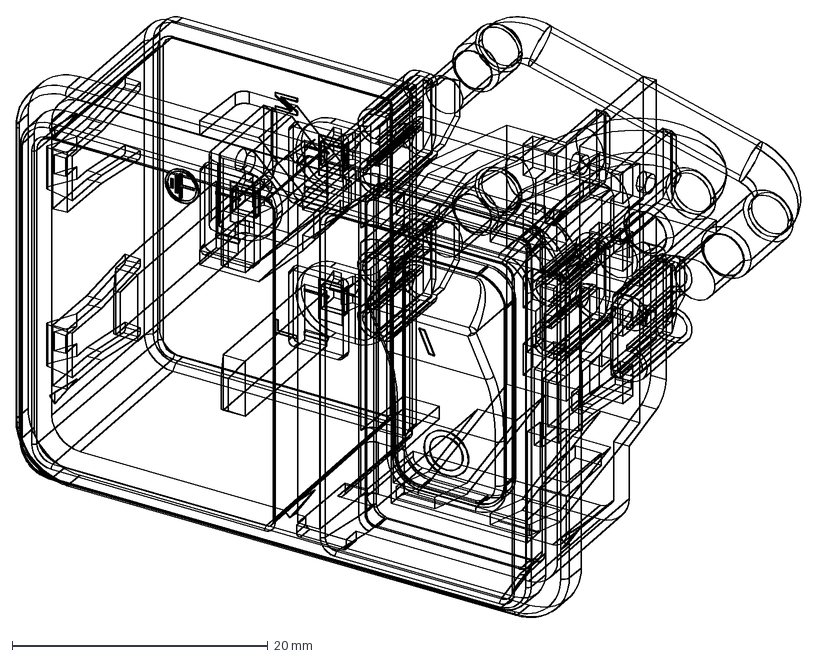
[picture p56: CAD file, 2026-10-14]
Documentation/images/ConnecteurAlim/ec11_0001_001_iso.dxf
61.4 x 47.2 mm
