fbuloup/Interface_IAI/Documentation/images/Disj20A/r9pfc620_left.dxf

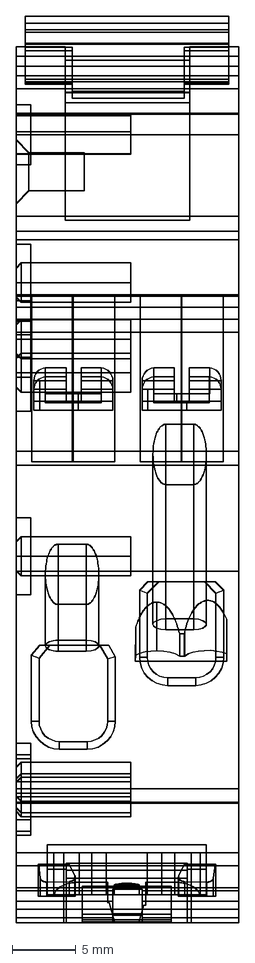
[picture p58: CAD file, 2026-10-14]
Documentation/images/Disj20A/r9pfc620_left.dxf
17.5 x 71.2 mm
