fbuloup/Interface_IAI/Documentation/images/Disj6A/r9pfc606_iso.dxf

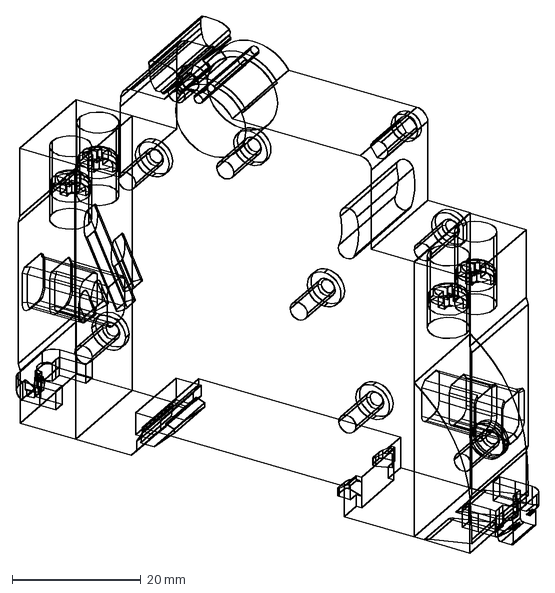
[picture p59: CAD file, 2026-10-14]
Documentation/images/Disj6A/r9pfc606_iso.dxf
81.0 x 83.3 mm
