fbuloup/Interface_IAI/Documentation/images/FiltreEMI10A/fn2090b-10-06_top.dxf

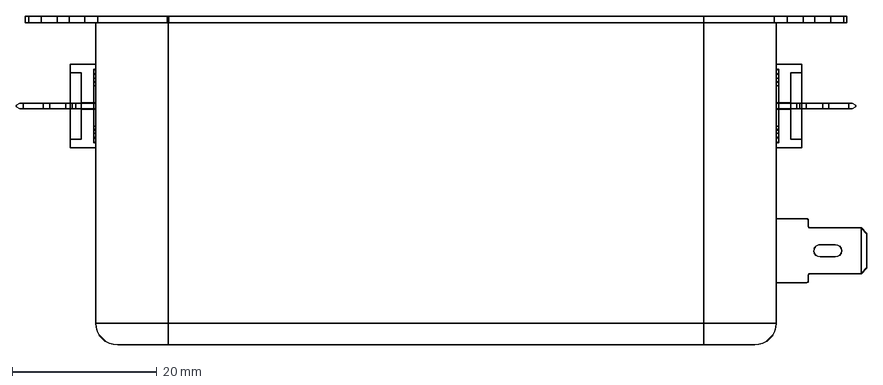
[picture p60: CAD file, 2026-10-14]
Documentation/images/FiltreEMI10A/fn2090b-10-06_top.dxf
117.5 x 45.4 mm
