fbuloup/Interface_IAI/Documentation/images/FiltreEMI20A/fn2090-20-06_iso.dxf

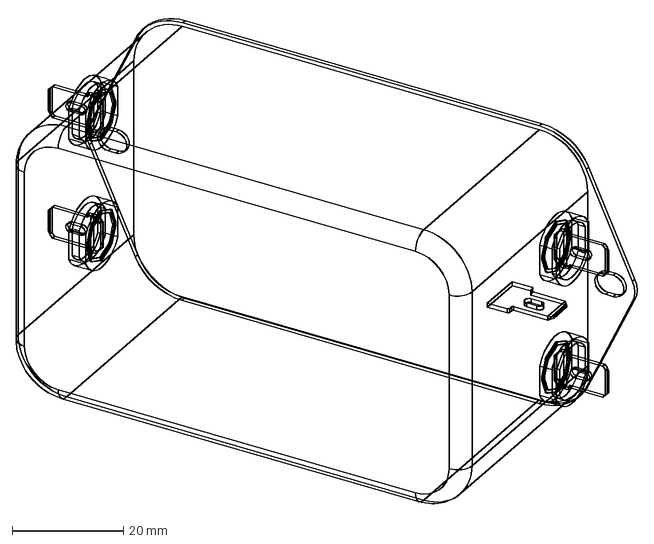
[picture p61: CAD file, 2026-10-14]
Documentation/images/FiltreEMI20A/fn2090-20-06_iso.dxf
111.6 x 87.5 mm
