fbuloup/Interface_IAI/Documentation/images/Disj10A/r9pfc610_right.dxf

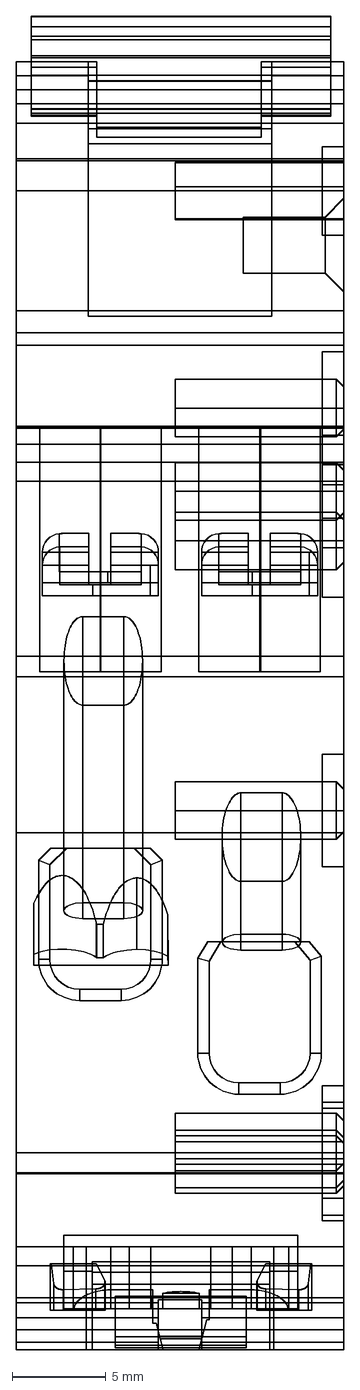
[picture p63: CAD file, 2026-10-14]
Documentation/images/Disj10A/r9pfc610_right.dxf
17.5 x 71.2 mm
