fbuloup/Interface_IAI/Documentation/images/Disj6A/r9pfc606_front.dxf

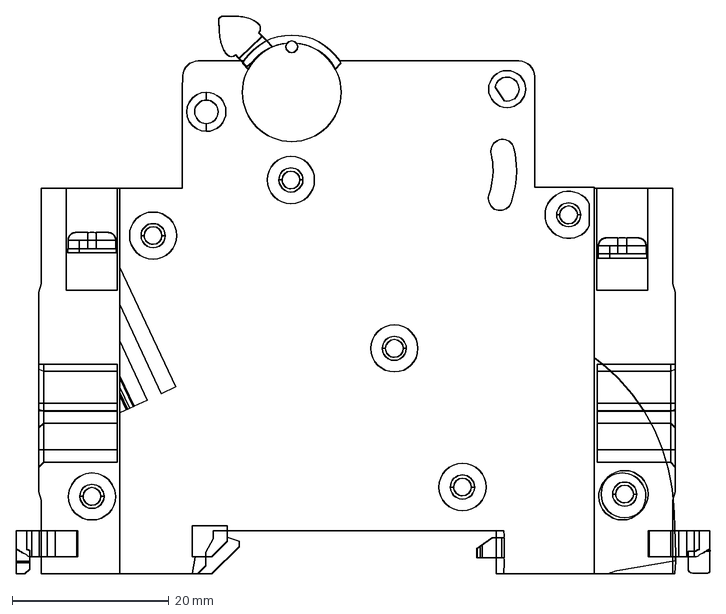
[picture p65: CAD file, 2026-10-14]
Documentation/images/Disj6A/r9pfc606_front.dxf
88.6 x 71.2 mm
