fbuloup/Interface_IAI/Documentation/images/FiltreEMI10A/fn2090b-10-06_front.dxf

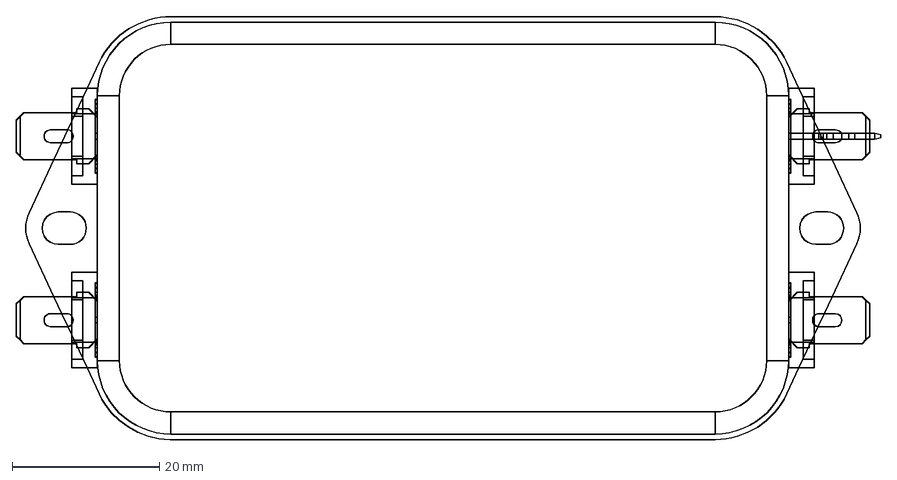
[picture p66: CAD file, 2026-10-14]
Documentation/images/FiltreEMI10A/fn2090b-10-06_front.dxf
117.5 x 57.5 mm
