fbuloup/Interface_IAI/Documentation/images/FiltreEMI20A/fn2090-20-06_bottom.dxf

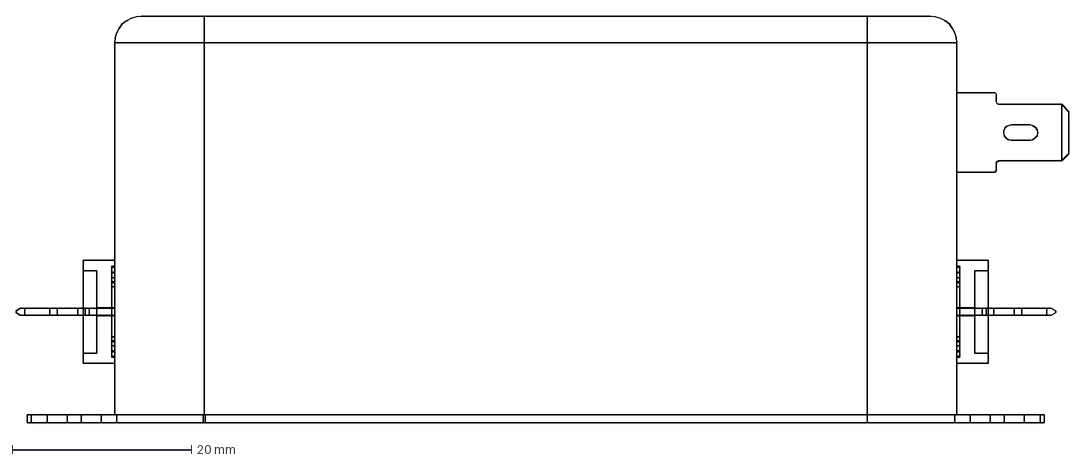
[picture p67: CAD file, 2026-10-14]
Documentation/images/FiltreEMI20A/fn2090-20-06_bottom.dxf
117.5 x 45.4 mm
