fbuloup/Interface_IAI/Documentation/images/Disj10A/r9pfc610_bottom.dxf

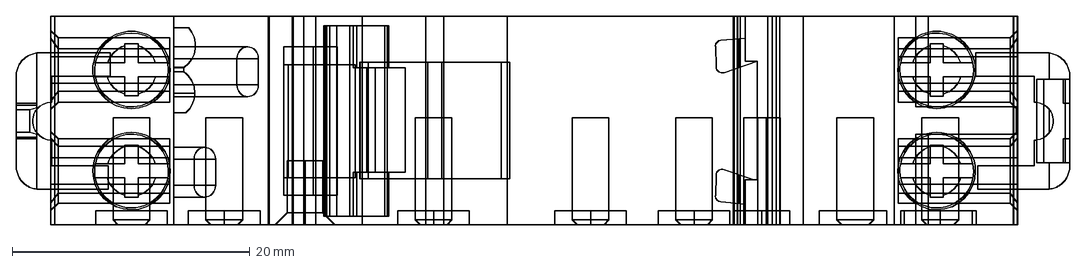
[picture p69: CAD file, 2026-10-14]
Documentation/images/Disj10A/r9pfc610_bottom.dxf
88.6 x 17.5 mm
