fbuloup/Interface_IAI/Documentation/images/Disj20A/r9pfc620_top.dxf

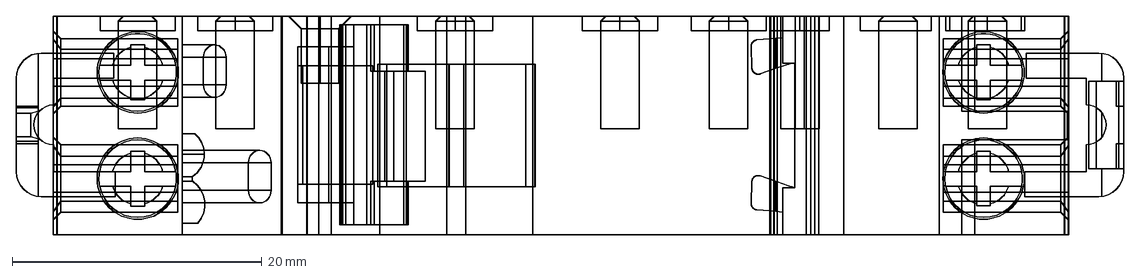
[picture p70: CAD file, 2026-10-14]
Documentation/images/Disj20A/r9pfc620_top.dxf
88.6 x 17.5 mm
