fbuloup/Interface_IAI/Documentation/images/Disj6A/r9pfc606_left.dxf

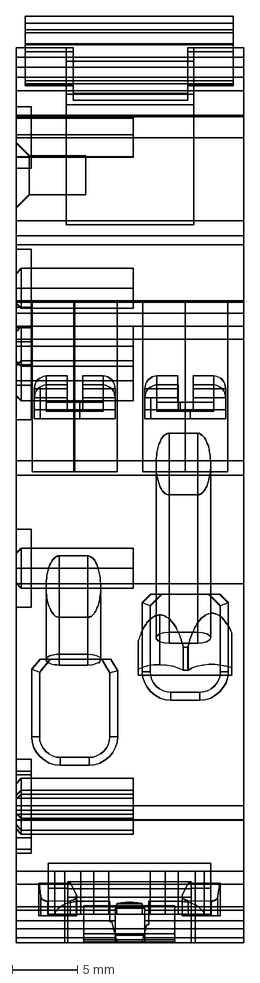
[picture p71: CAD file, 2026-10-14]
Documentation/images/Disj6A/r9pfc606_left.dxf
17.5 x 71.2 mm
