fbuloup/Interface_IAI/Documentation/images/FiltreEMI10A/fn2090b-10-06_back.dxf

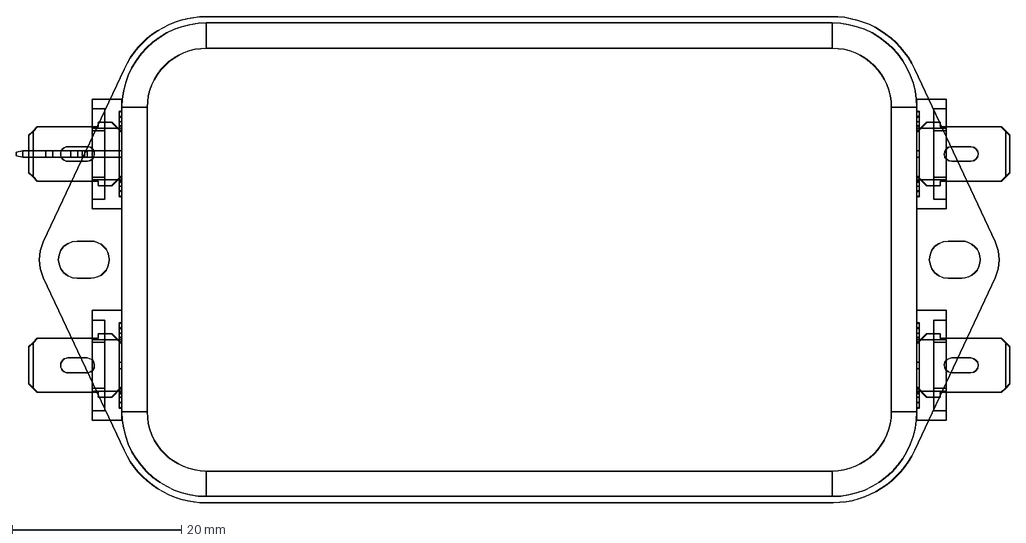
[picture p72: CAD file, 2026-10-14]
Documentation/images/FiltreEMI10A/fn2090b-10-06_back.dxf
117.5 x 57.5 mm
