fbuloup/Interface_IAI/Documentation/images/FiltreEMI20A/fn2090-20-06_left.dxf

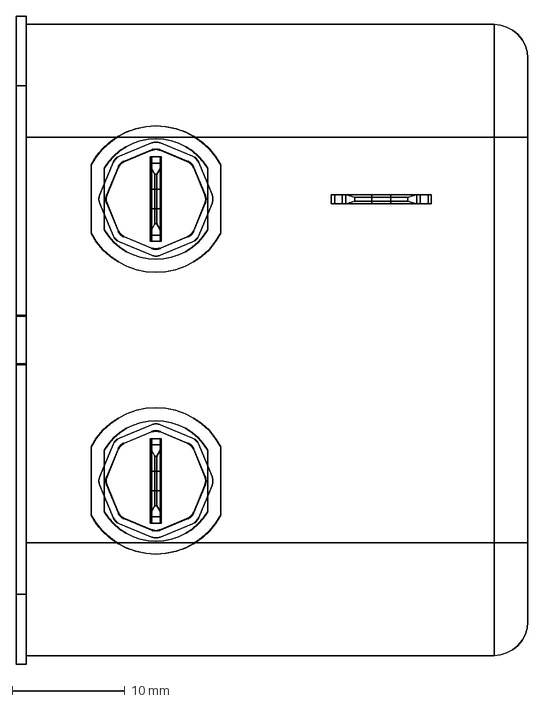
[picture p73: CAD file, 2026-10-14]
Documentation/images/FiltreEMI20A/fn2090-20-06_left.dxf
45.4 x 57.5 mm
