fbuloup/Interface_IAI/Documentation/images/ConnecteurAlim/ec11_0001_001_back.dxf

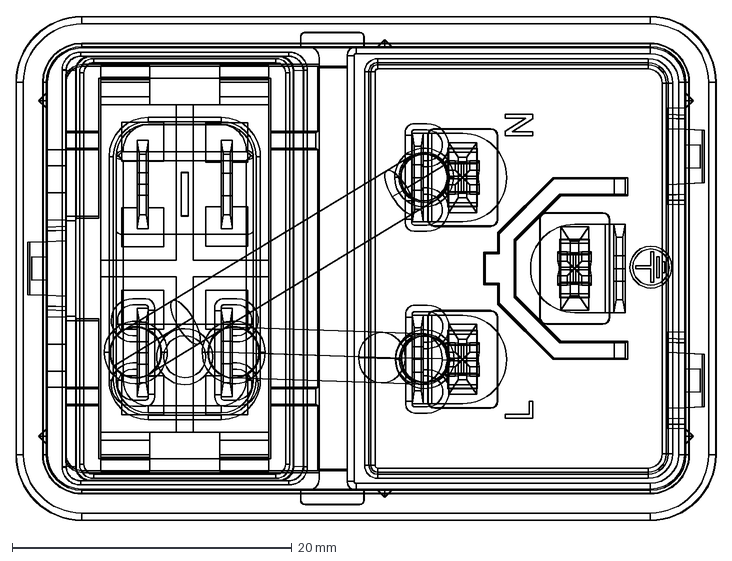
[picture p74: CAD file, 2026-10-14]
Documentation/images/ConnecteurAlim/ec11_0001_001_back.dxf
50.0 x 36.0 mm
