fbuloup/Interface_IAI/Documentation/images/Disj10A/r9pfc610_left.dxf

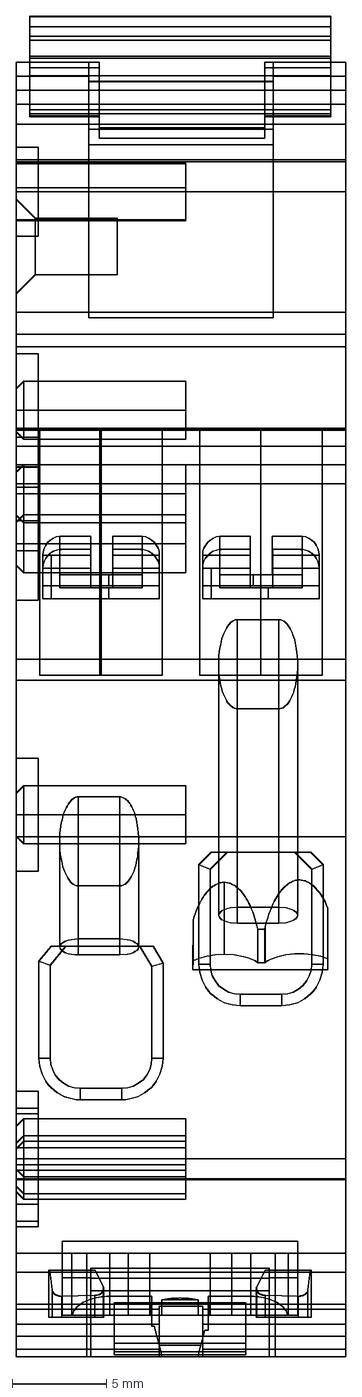
[picture p75: CAD file, 2026-10-14]
Documentation/images/Disj10A/r9pfc610_left.dxf
17.5 x 71.2 mm
