fbuloup/Interface_IAI/Documentation/images/Disj20A/r9pfc620_bottom.dxf

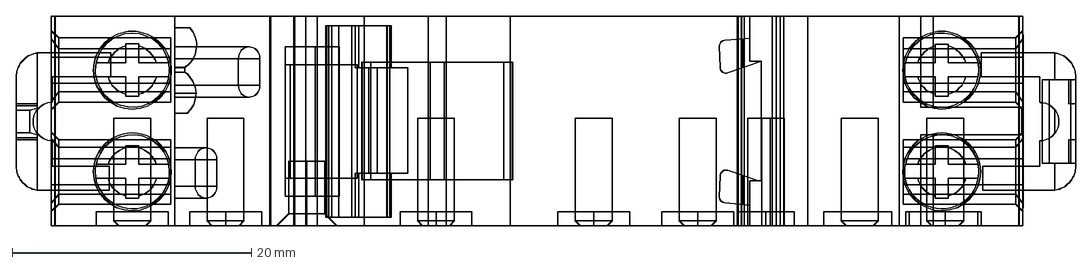
[picture p76: CAD file, 2026-10-14]
Documentation/images/Disj20A/r9pfc620_bottom.dxf
88.6 x 17.5 mm
