fbuloup/Interface_IAI/Documentation/images/Disj6A/r9pfc606_bottom.dxf

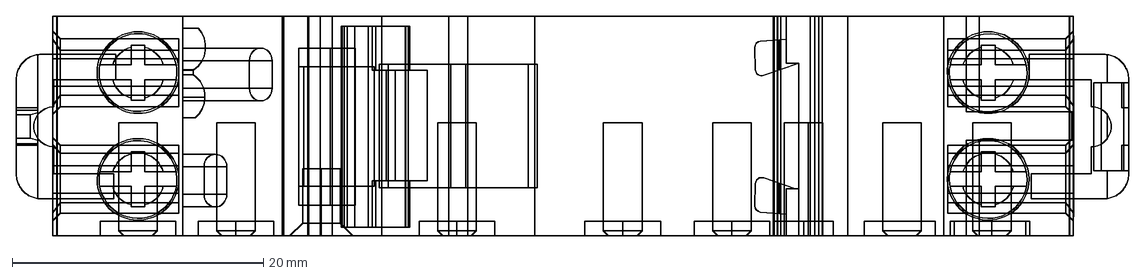
[picture p77: CAD file, 2026-10-14]
Documentation/images/Disj6A/r9pfc606_bottom.dxf
88.6 x 17.5 mm
