fbuloup/Interface_IAI/Documentation/images/ConnecteurAlim/ec11_0001_001_bottom.dxf

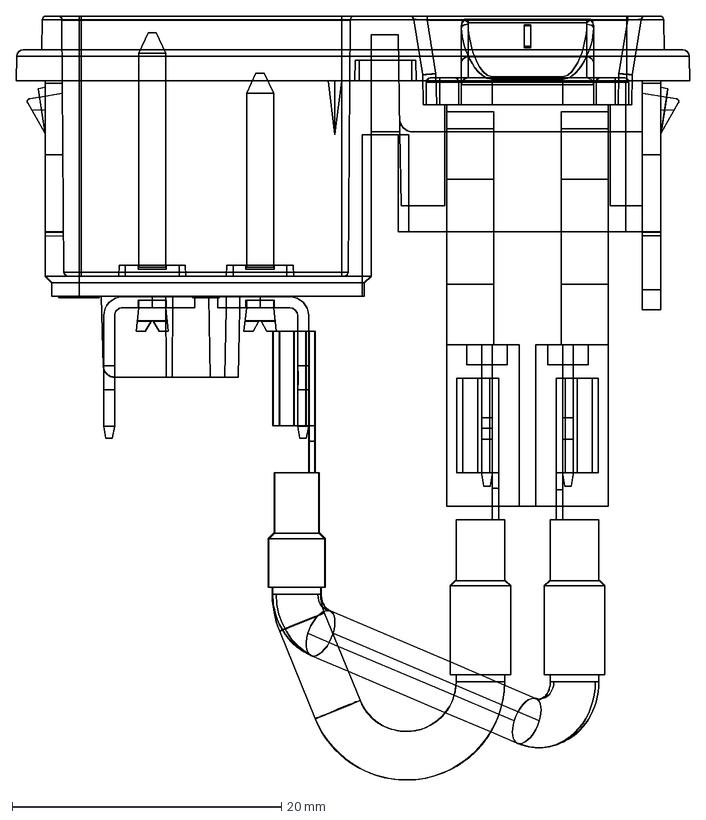
[picture p80: CAD file, 2026-10-14]
Documentation/images/ConnecteurAlim/ec11_0001_001_bottom.dxf
50.0 x 56.7 mm
