fbuloup/Interface_IAI/Documentation/images/Disj10A/r9pfc610_back.dxf

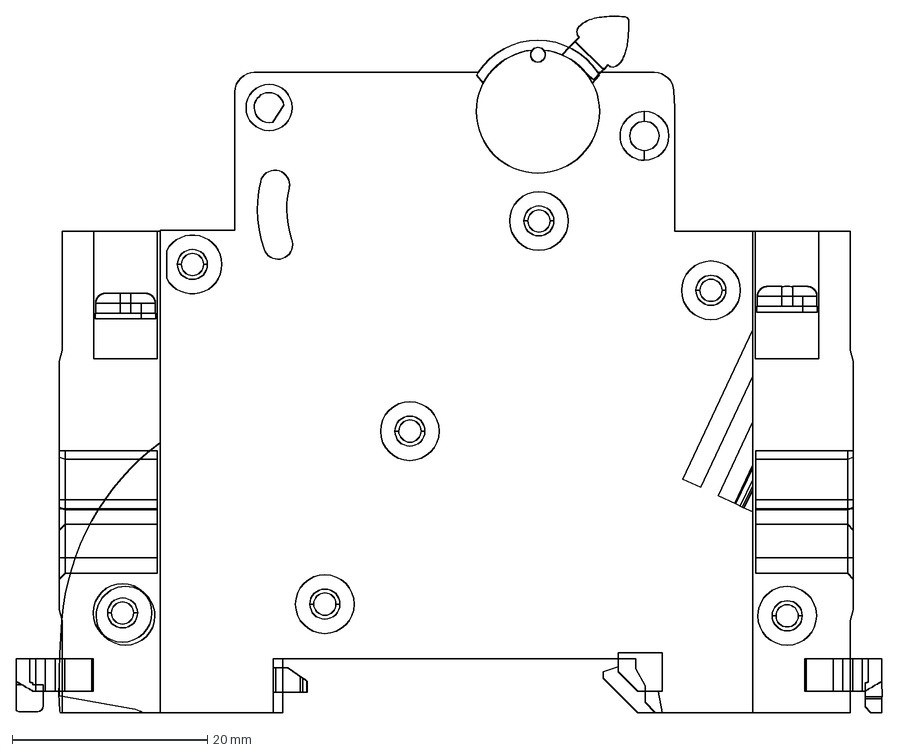
[picture p81: CAD file, 2026-10-14]
Documentation/images/Disj10A/r9pfc610_back.dxf
88.6 x 71.2 mm
