fbuloup/Interface_IAI/Documentation/images/Disj20A/r9pfc620_iso.dxf

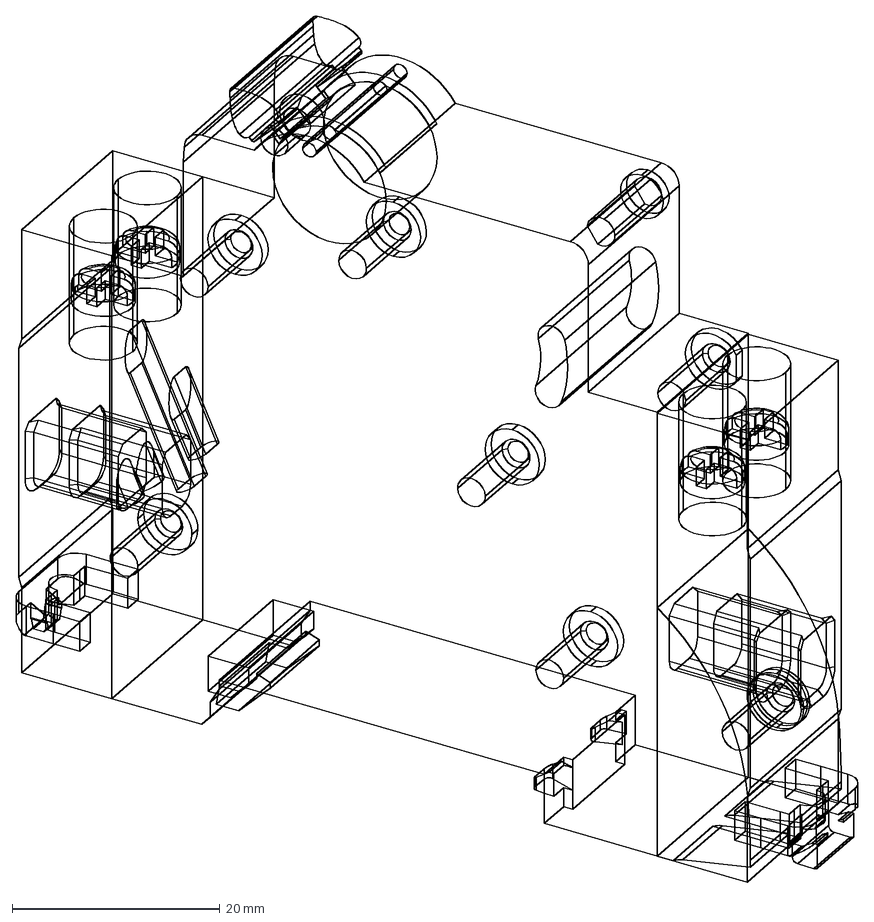
[picture p82: CAD file, 2026-10-14]
Documentation/images/Disj20A/r9pfc620_iso.dxf
81.0 x 83.3 mm
