fbuloup/Interface_IAI/Documentation/images/Disj6A/r9pfc606_back.dxf

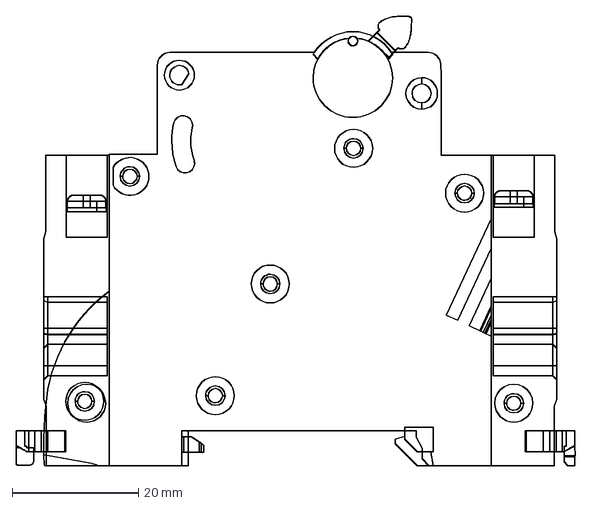
[picture p83: CAD file, 2026-10-14]
Documentation/images/Disj6A/r9pfc606_back.dxf
88.6 x 71.2 mm
