fbuloup/Interface_IAI/Documentation/images/FiltreEMI10A/fn2090b-10-06_iso.dxf

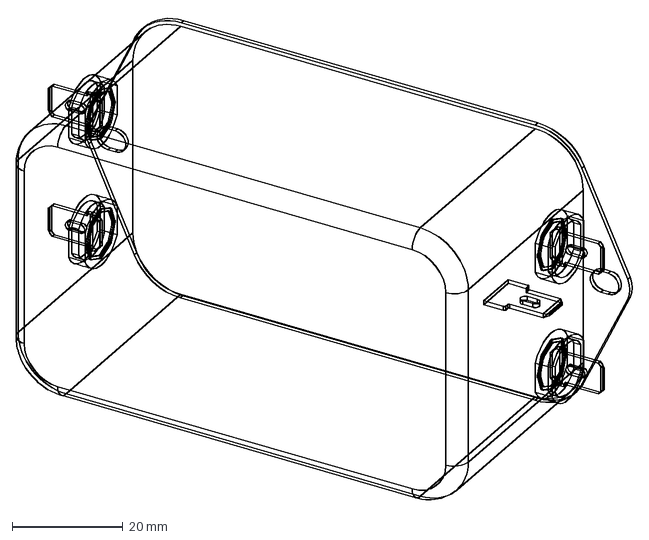
[picture p84: CAD file, 2026-10-14]
Documentation/images/FiltreEMI10A/fn2090b-10-06_iso.dxf
111.6 x 87.5 mm
