fbuloup/Interface_IAI/Documentation/images/FiltreEMI20A/fn2090-20-06_back.dxf

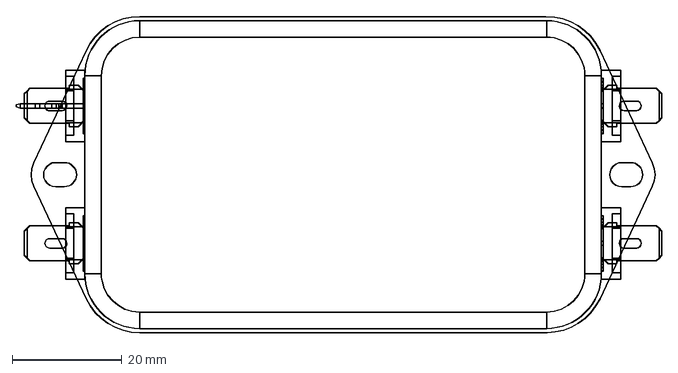
[picture p85: CAD file, 2026-10-14]
Documentation/images/FiltreEMI20A/fn2090-20-06_back.dxf
117.5 x 57.5 mm
