fbuloup/Interface_IAI/(list of files, cad)

Other CAD files:
Documentation/1455N1601.stp
Documentation/images/DisjDiff/2383297_back.dxf
Documentation/images/DisjDiff/2383297_bottom.dxf
Documentation/images/DisjDiff/2383297_front.dxf
Documentation/images/DisjDiff/2383297_iso.dxf
Documentation/images/DisjDiff/2383297_left.dxf
Documentation/images/DisjDiff/2383297_right.dxf
Documentation/images/DisjDiff/2383297_top.dxf
Documentation/images/PresseEtoupe/6694660_back.dxf
Documentation/images/PresseEtoupe/6694660_bottom.dxf
Documentation/images/PresseEtoupe/6694660_front.dxf
Documentation/images/PresseEtoupe/6694660_iso.dxf
Documentation/images/PresseEtoupe/6694660_left.dxf
Documentation/images/PresseEtoupe/6694660_right.dxf
Documentation/images/PresseEtoupe/6694660_top.dxf
Documentation/images/RailDin/2006731_back.dxf
Documentation/images/RailDin/2006731_bottom.dxf
Documentation/images/RailDin/2006731_front.dxf
Documentation/images/RailDin/2006731_iso.dxf
Documentation/images/RailDin/2006731_left.dxf
Documentation/images/RailDin/2006731_right.dxf
Documentation/images/RailDin/2006731_top.dxf
