fbuloup/Interface_IAI/Documentation/images/pcb.pdf

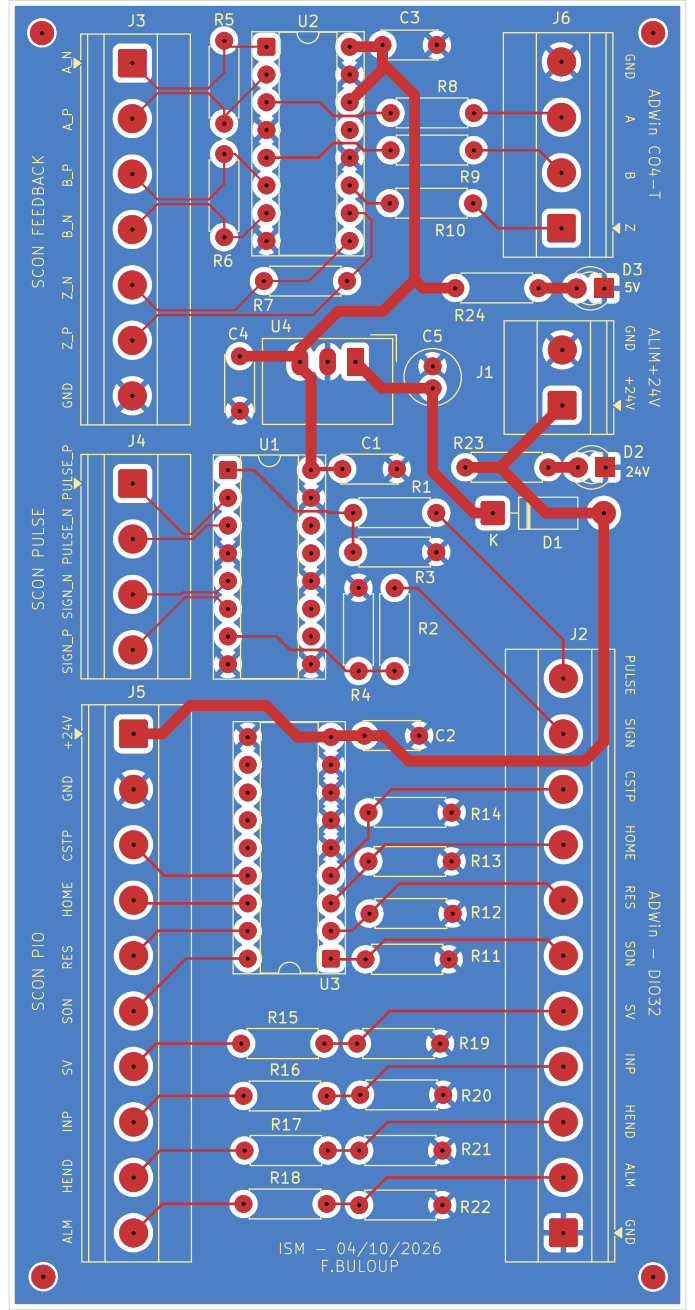
[picture p86: page 1]
