fbuloup/Interface_IAI/Documentation/images/Interface_IAI_PCB.pdf

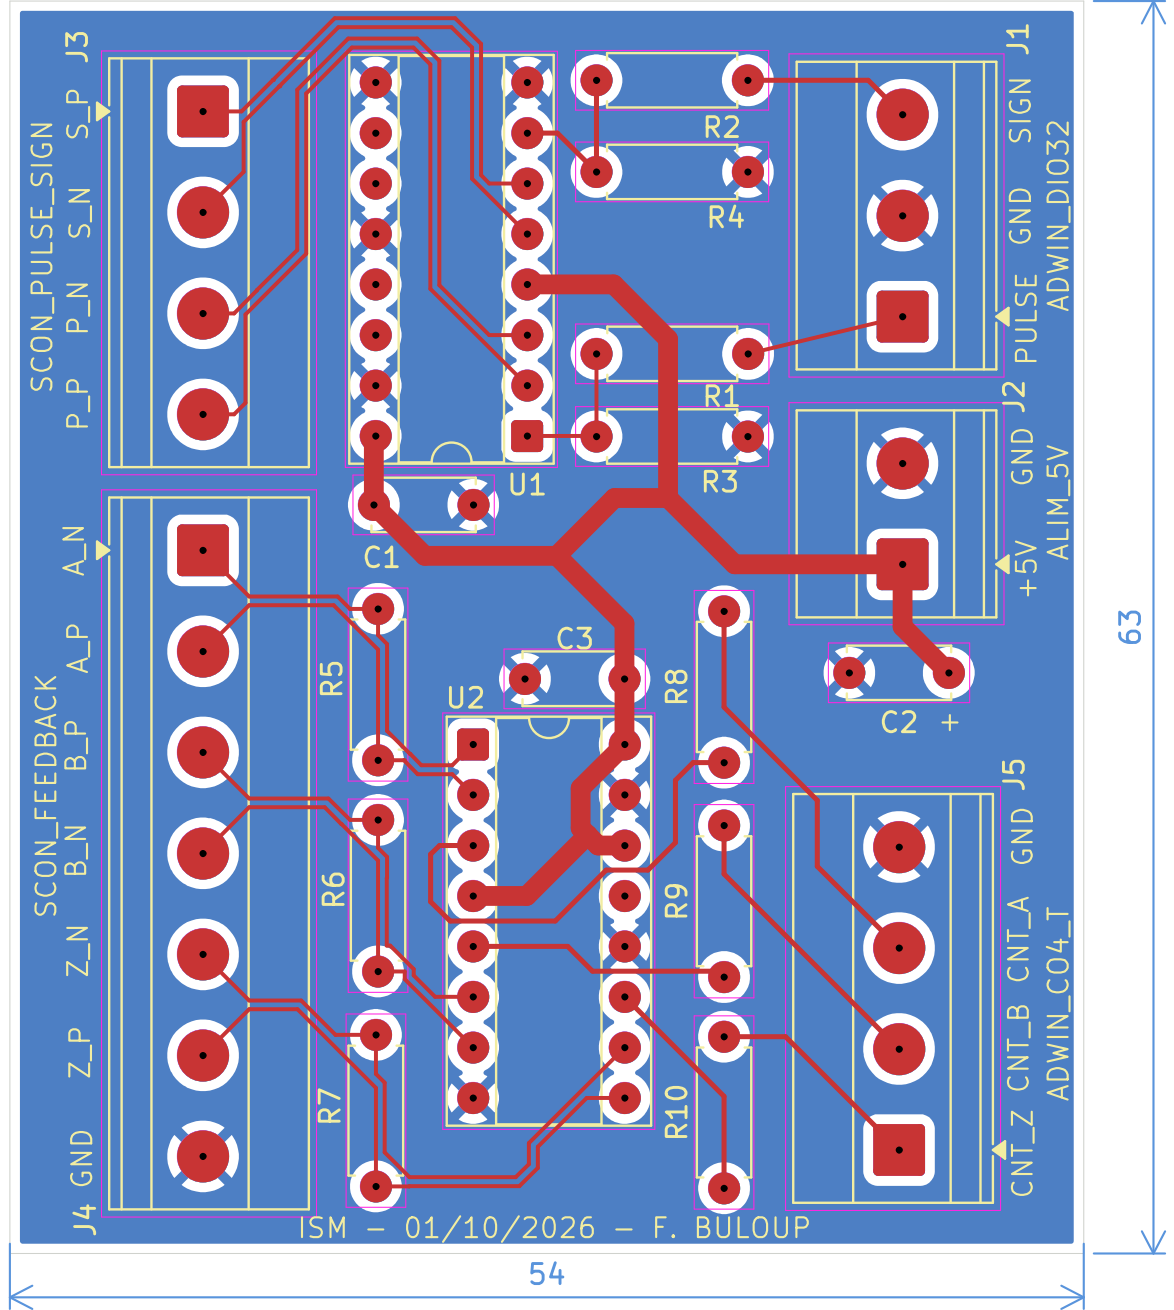
[picture p87: page 1]
