fbuloup/Interface_IAI/Interface_IAI.kicad_pcb

## KiCad design Interface_IAI.kicad_pcb (2026-10-09)

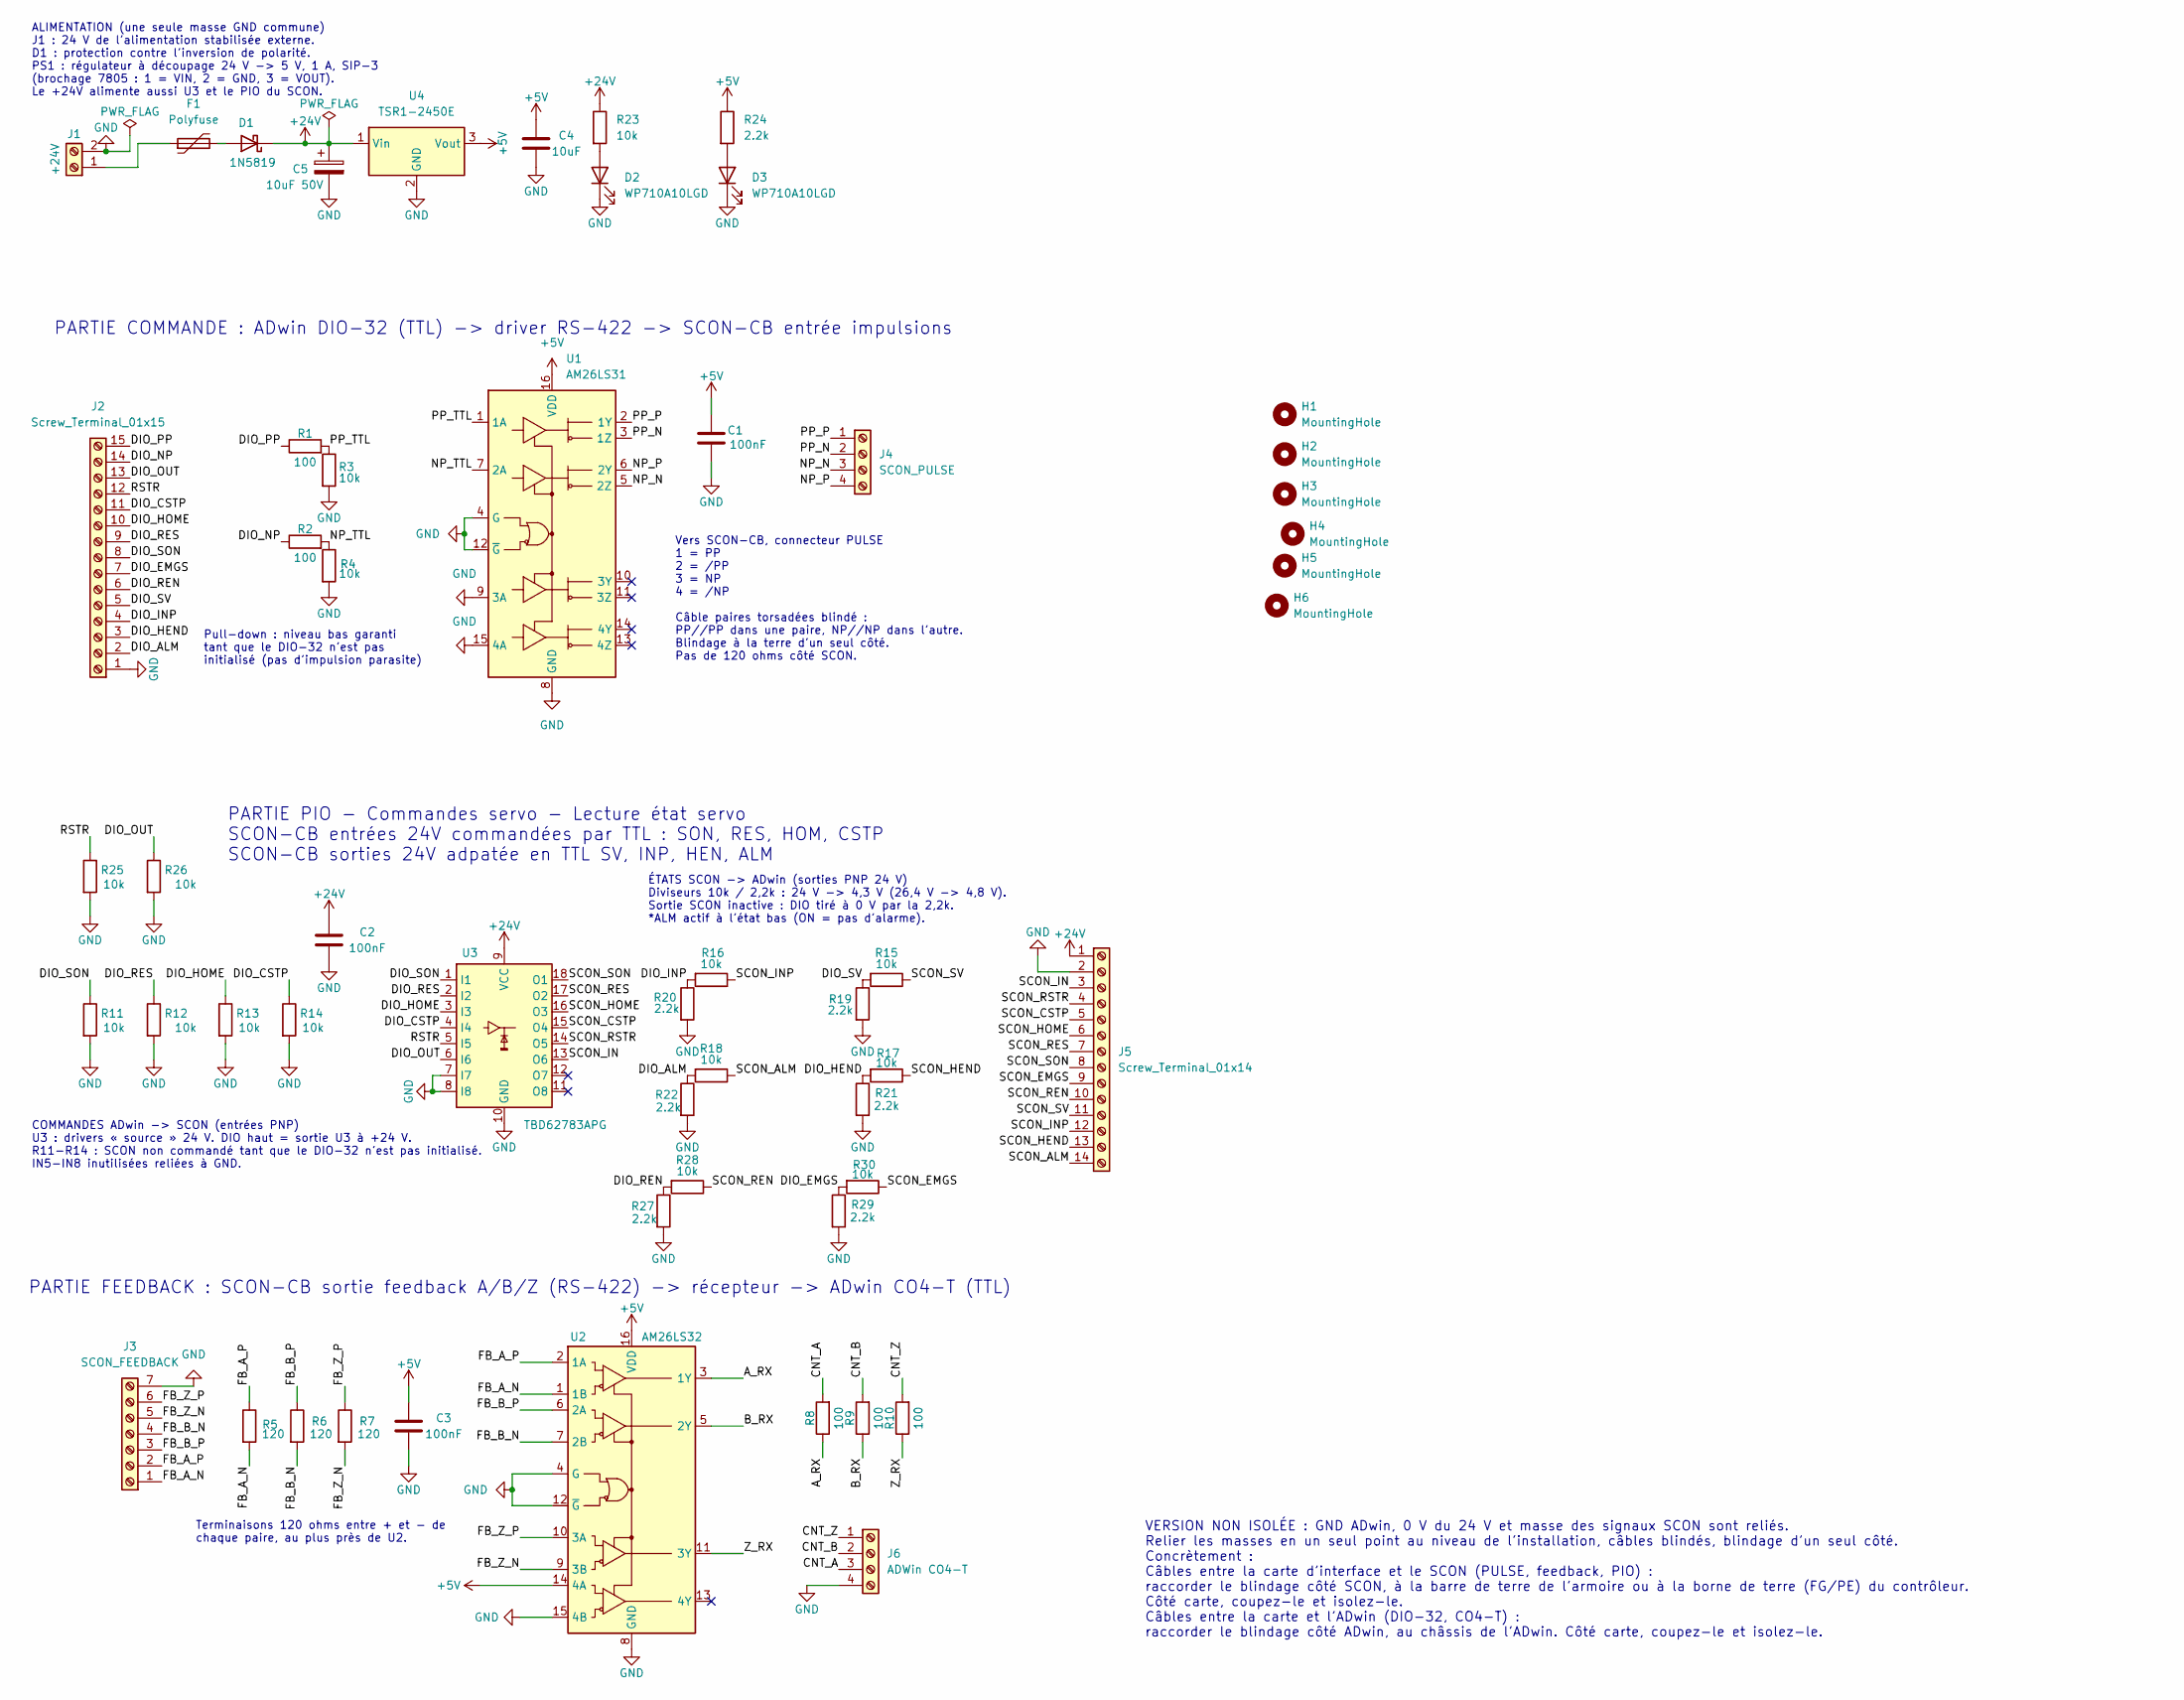
[picture p88: schematic Interface_IAI.kicad_sch, Interface ADwin-Pro I <-> IAI SCON-CB (commande + feedback)]

Parts:
C1, C2, C3: 100nF; C_Disc_D5.0mm_W2.5mm_P5.00mm
C4: 10uF; C_Disc_D5.0mm_W2.5mm_P5.00mm
C5: 10uF 50V; CP_Radial_D5.0mm_P2.00mm
D1: 1N5819; D_DO-41_SOD81_P10.16mm_Horizontal
D2, D3: WP710A10LGD; LED_D3.0mm
F1: Polyfuse; MFR050
H1, H2, H3, H4, H5, H6: MountingHole; MountingHole_3.2mm_M3
J1: +24V; TerminalBlock_Phoenix_MKDS-1,5-2-5.08_1x02_P5.08mm_Horizont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
J2: Screw_Terminal_01x15; TerminalBlock_Phoenix_MKDS-1,5-15-5.08_1x15_P5.08mm_Horizon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
J3: SCON_FEEDBACK; TerminalBlock_Phoenix_MKDS-1,5-7-5.08_1x07_P5.08mm_Horizont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
J4: SCON_PULSE; TerminalBlock_Phoenix_MKDS-1,5-4-5.08_1x04_P5.08mm_Horizont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
J5: Screw_Terminal_01x14; TerminalBlock_Phoenix_MKDS-1,5-14-5.08_1x14_P5.08mm_Horizon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
J6: ADWin CO4-T; TerminalBlock_Phoenix_MKDS-1,5-4-5.08_1x04_P5.08mm_Horizont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
R1, R2, R8, R9, R10: 100; R_Axial_DIN0207_L6.3mm_D2.5mm_P7.62mm_Horizontal
R3, R4, R11, R12, R13, R14, R15, R16, R17, R18, R23, R25, R26, R28, R30: 10k; R_Axial_DIN0207_L6.3mm_D2.5mm_P7.62mm_Horizontal
R5, R6, R7: 120; R_Axial_DIN0207_L6.3mm_D2.5mm_P7.62mm_Horizontal
R19, R20, R21, R22, R24, R27, R29: 2.2k; R_Axial_DIN0207_L6.3mm_D2.5mm_P7.62mm_Horizontal
U1: AM26LS31; DIP-16_W7.62mm_Socket
U2: AM26LS32; DIP-16_W7.62mm_Socket
U3: TBD62783APG; DIP-18_W7.62mm_Socket
U4: TSR1-2450E; Converter_DCDC_TRACO_TSR-1_THT

Connections:
+5V: C1.1, C3.1, C4.1, R24.1, U1.16 (VDD), U2.14 (4A), U2.16 (VDD), U4.3 (Vout)
+24V: C2.1, C5.1, D1.1 (K), J5.1, R23.1, U3.9 (VCC), U4.1 (Vin)
/A_RX: R8.1, U2.3 (1Y)
/B_RX: R9.1, U2.5 (2Y)
/CNT_A: J6.3, R8.2
/CNT_B: J6.2, R9.2
/CNT_Z: J6.1, R10.2
/DIO_ALM: J2.2, R18.2, R22.1
/DIO_CSTP: J2.11, R14.1, U3.4 (I4)
/DIO_EMGS: J2.7, R29.1, R30.2
/DIO_HEND: J2.3, R17.2, R21.1
/DIO_HOME: J2.10, R13.1, U3.3 (I3)
/DIO_INP: J2.4, R16.2, R20.1
/DIO_NP: J2.14, R2.1
/DIO_OUT: J2.13, R26.1, U3.6 (I6)
/DIO_PP: J2.15, R1.1
/DIO_REN: J2.6, R27.1, R28.2
/DIO_RES: J2.9, R12.1, U3.2 (I2)
/DIO_SON: J2.8, R11.1, U3.1 (I1)
/DIO_SV: J2.5, R15.2, R19.1
/FB_A_N: J3.1, R5.2, U2.1 (1B)
/FB_A_P: J3.2, R5.1, U2.2 (1A)
/FB_B_N: J3.4, R6.2, U2.7 (2B)
/FB_B_P: J3.3, R6.1, U2.6 (2A)
/FB_Z_N: J3.5, R7.2, U2.9 (3B)
/FB_Z_P: J3.6, R7.1, U2.10 (3A)
/NP_N: J4.3, U1.5 (2Z)
/NP_P: J4.4, U1.6 (2Y)
/NP_TTL: R2.2, R4.1, U1.7 (2A)
/PP_N: J4.2, U1.3 (1Z)
/PP_P: J4.1, U1.2 (1Y)
/PP_TTL: R1.2, R3.1, U1.1 (1A)
/RSTR: J2.12, R25.1, U3.5 (I5)
/SCON_ALM: J5.14, R18.1
/SCON_CSTP: J5.5, U3.15 (O4)
/SCON_EMGS: J5.9, R30.1
/SCON_HEND: J5.13, R17.1
/SCON_HOME: J5.6, U3.16 (O3)
/SCON_IN: J5.3, U3.13 (O6)
/SCON_INP: J5.12, R16.1
/SCON_REN: J5.10, R28.1
/SCON_RES: J5.7, U3.17 (O2)
/SCON_RSTR: J5.4, U3.14 (O5)
/SCON_SON: J5.8, U3.18 (O1)
/SCON_SV: J5.11, R15.1
/Z_RX: R10.1, U2.11 (3Y)
GND: C1.2, C2.2, C3.2, C4.2, C5.2, D2.1 (K), D3.1 (K), J1.2, J2.1, J3.7, J5.2, J6.4, R3.2, R4.2, R11.2, R12.2, R13.2, R14.2, R19.2, R20.2, R21.2, R22.2, R25.2, R26.2, R27.2, R29.2, U1.4 (G), U1.8 (GND), U1.9 (3A), U1.12 (~G), U1.15 (4A), U2.4 (G), U2.8 (GND), U2.12 (~G), U2.15 (4B), U3.7 (I7), U3.8 (I8), U3.10 (GND), U4.2 (GND)
unnamed: D1.2 (A), F1.2
unnamed: D2.2 (A), R23.2
unnamed: D3.2 (A), R24.2
unnamed: F1.1, J1.1

Notes on the sheet:
COMMANDES ADwin -> SCON (entrées PNP) U3 : drivers « source » 24 V. DIO haut = sortie U3 à +24 V. R11-R14 : SCON non commandé tant que le DIO-32 n'est pas initialisé. IN5-IN8 inutilisées reliées à GND.
ÉTATS SCON -> ADwin (sorties PNP 24 V) Diviseurs 10k / 2,2k : 24 V -> 4,3 V (26,4 V -> 4,8 V). Sortie SCON inactive : DIO tiré à 0 V par la 2,2k. *ALM actif à l'état bas (ON = pas d'alarme).
Vers SCON-CB, connecteur PULSE 1 = PP 2 = /PP 3 = NP 4 = /NP Câble paires torsadées blindé : PP//PP dans une paire, NP//NP dans l'autre. Blindage à la terre d'un seul côté. Pas de 120 ohms côté SCON.
Pull-down : niveau bas garanti tant que le DIO-32 n'est pas initialisé (pas d'impulsion parasite)
Terminaisons 120 ohms entre + et - de chaque paire, au plus près de U2.
PARTIE FEEDBACK : SCON-CB sortie feedback A/B/Z (RS-422) -> récepteur -> ADwin CO4-T (TTL)
PARTIE PIO - Commandes servo - Lecture état servo SCON-CB entrées 24V commandées par TTL : SON, RES, HOM, CSTP SCON-CB sorties 24V adpatée en TTL SV, INP, HEN, ALM
ALIMENTATION (une seule masse GND commune) J1 : 24 V de l'alimentation stabilisée externe. D1 : protection contre l'inversion de polarité. PS1 : régulateur à découpage 24 V -> 5 V, 1 A, SIP-3 (brochage 7805 : 1 = VIN, 2 = GND, 3 = VOUT). Le +24V alimente aussi U3 et le PIO du SCON.
PARTIE COMMANDE : ADwin DIO-32 (TTL) -> driver RS-422 -> SCON-CB entrée impulsions
VERSION NON ISOLÉE : GND ADwin, 0 V du 24 V et masse des signaux SCON sont reliés. Relier les masses en un seul point au niveau de l'installation, câbles blindés, blindage d'un seul côté. Concrètement : Câbles entre la carte d'interface et le SCON (PULSE, feedback, PIO) : raccorder le blindage côté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

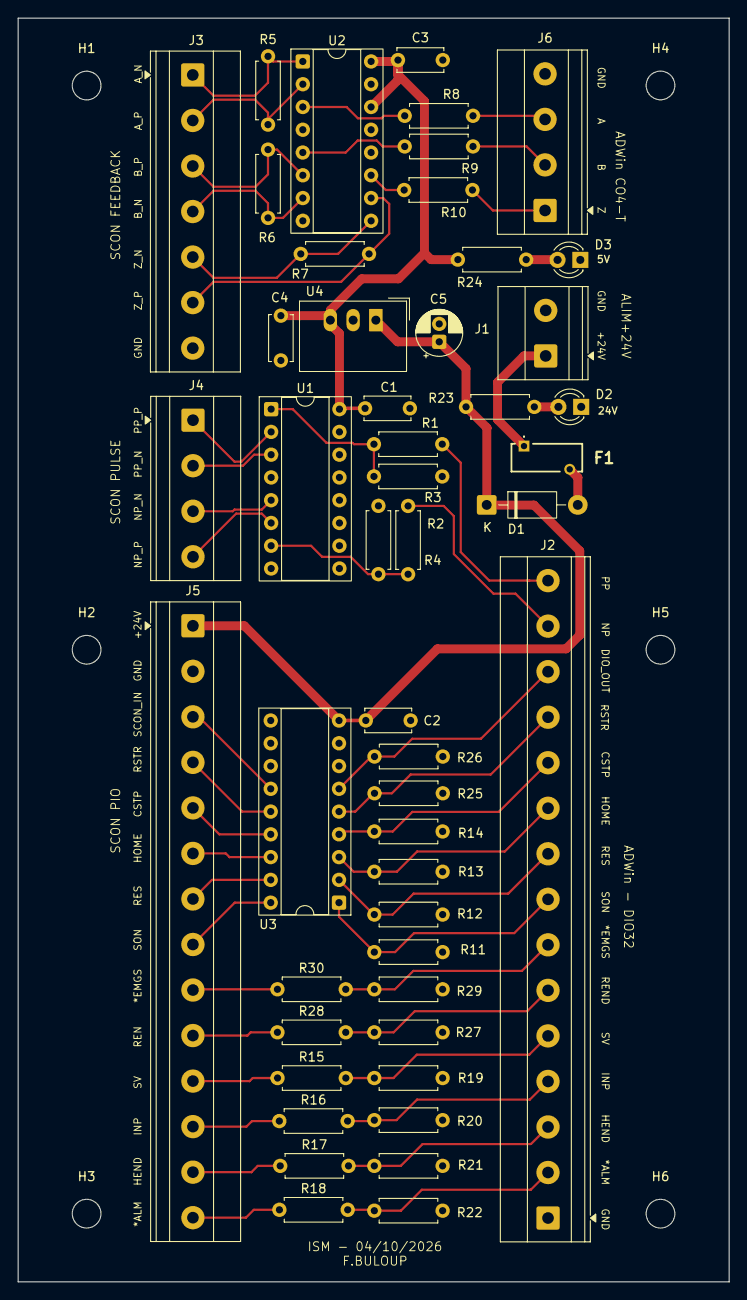
[picture p89: board Interface_IAI.kicad_pcb from above]

Board: 2 copper layers, 79.3 x 141.0 mm, 55 parts (0 on the bottom side), 51 nets.
