fbuloup/Interface_IAI/(commit log)

2026-10-02 Update PCB silkscreen
    [Interface_IAI-B_Cu.gbr, Interface_IAI-B_Mask.gbr, Interface_IAI-Edge_Cuts.gbr, Interface_IAI-F_Cu.gbr, Interface_IAI-F_Mask.gbr, Interface_IAI-F_Silkscreen.gbr, Interface_IAI-NPTH.drl, Interface_IAI-PTH.drl]
2026-10-04 Update board
    [Interface_IAI-B_Cu.gbr, Interface_IAI-B_Mask.gbr, Interface_IAI-Edge_Cuts.gbr, Interface_IAI-F_Cu.gbr, Interface_IAI-F_Mask.gbr, Interface_IAI-F_Silkscreen.gbr, Interface_IAI-NPTH-drl_map.gbr, Interface_IAI-NPTH.drl]
2026-10-04 Modify BOM
    [Interface_IAI.csv, Interface_IAI.kicad_pcb, Interface_IAI.kicad_sch]
2026-10-04 Add DEL Alim.
    [Interface_IAI.csv, Interface_IAI.kicad_pcb, Interface_IAI.kicad_sch]
2026-10-04 Update gerber files
    [Interface_IAI-B_Cu.gbr, Interface_IAI-B_Mask.gbr, Interface_IAI-Edge_Cuts.gbr, Interface_IAI-F_Cu.gbr, Interface_IAI-F_Mask.gbr, Interface_IAI-F_Silkscreen.gbr, Interface_IAI-NPTH-drl_map.gbr, Interface_IAI-NPTH.drl]
2026-10-04 Update Doc. and Gerber files
    [1455N1601.stp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]
2026-10-04 Update gerber zip file
2026-10-05 Add prices (Excel file)
    [Interface_IAI.csv]
2026-10-06 Move to wall-mounted enclosure - Step 1
2026-10-06 Move to wall-mounted enclosure - Step 2
2026-10-06 Remove Hammond box, refactor schematic
    [Interface_IAI.kicad_sch]
2026-10-07 Update Doc.
    [Interface_IAI.kicad_pcb, Interface_IAI.kicad_sch, Interface_IAI.xlsx]
2026-10-08 Update doc
    [Interface_IAI.xlsx]
2026-10-09 Update doc. Change PCB (RSTR, REND, *EMGS)
    [Interface_IAI-B_Cu.gbr, Interface_IAI-B_Mask.gbr, Interface_IAI-Edge_Cuts.gbr, Interface_IAI-F_Cu.gbr, Interface_IAI-F_Mask.gbr, Interface_IAI-F_Silkscreen.gbr, Interface_IAI-NPTH-drl_map.gbr, Interface_IAI-NPTH.drl]
2026-10-15 Add 36 conductors cable ref. RS
